IowaScaledEngineering/ckt-pingpong/doc/usermanual/img/power.jpg

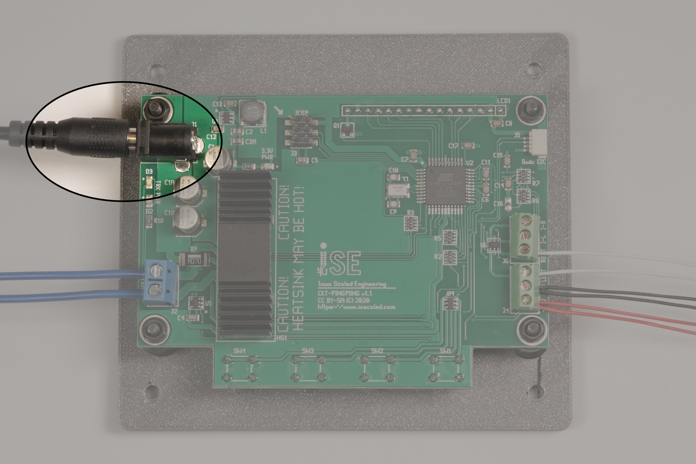
doc/usermanual/img/power.jpg
