IowaScaledEngineering/ckt-pingpong/mech/faceplates/pingpong-sw-template.pdf

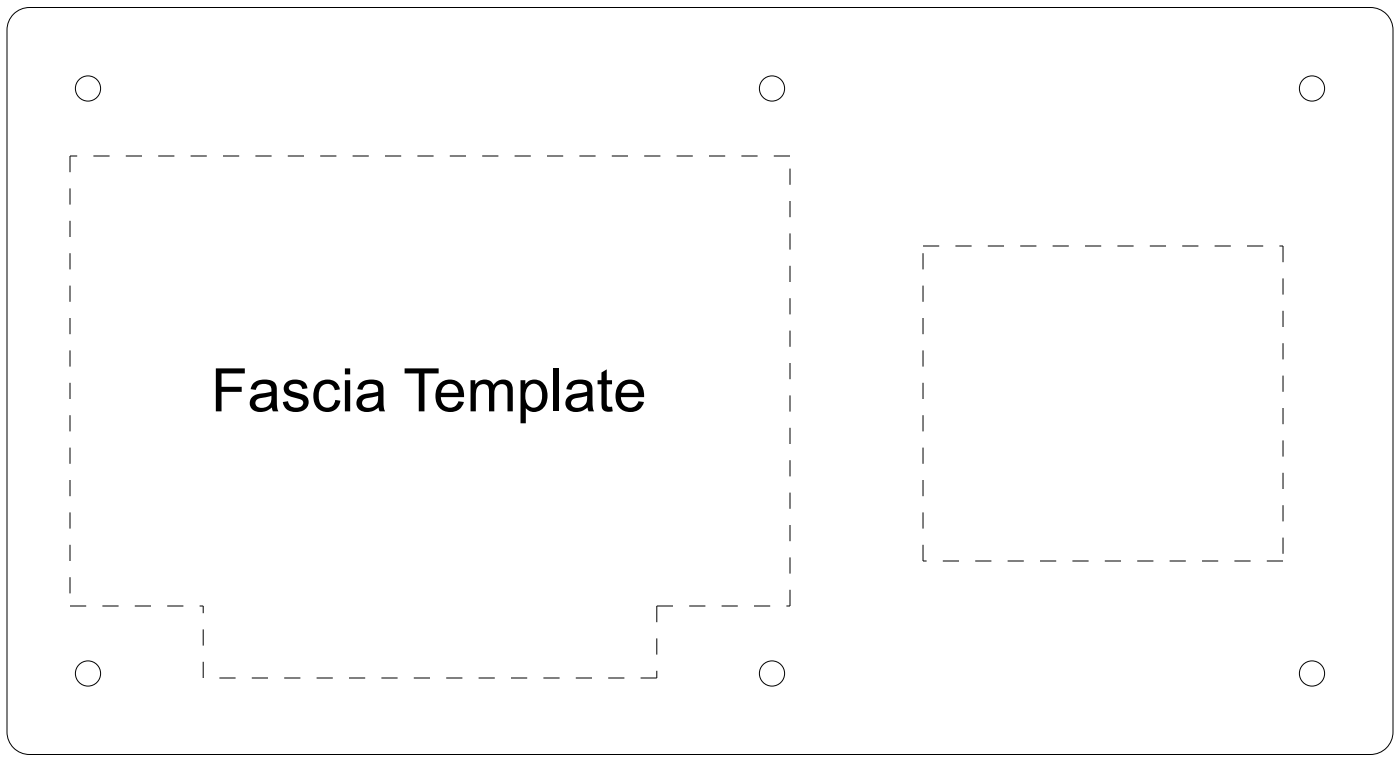
[picture p2: figure]
Fascia Template
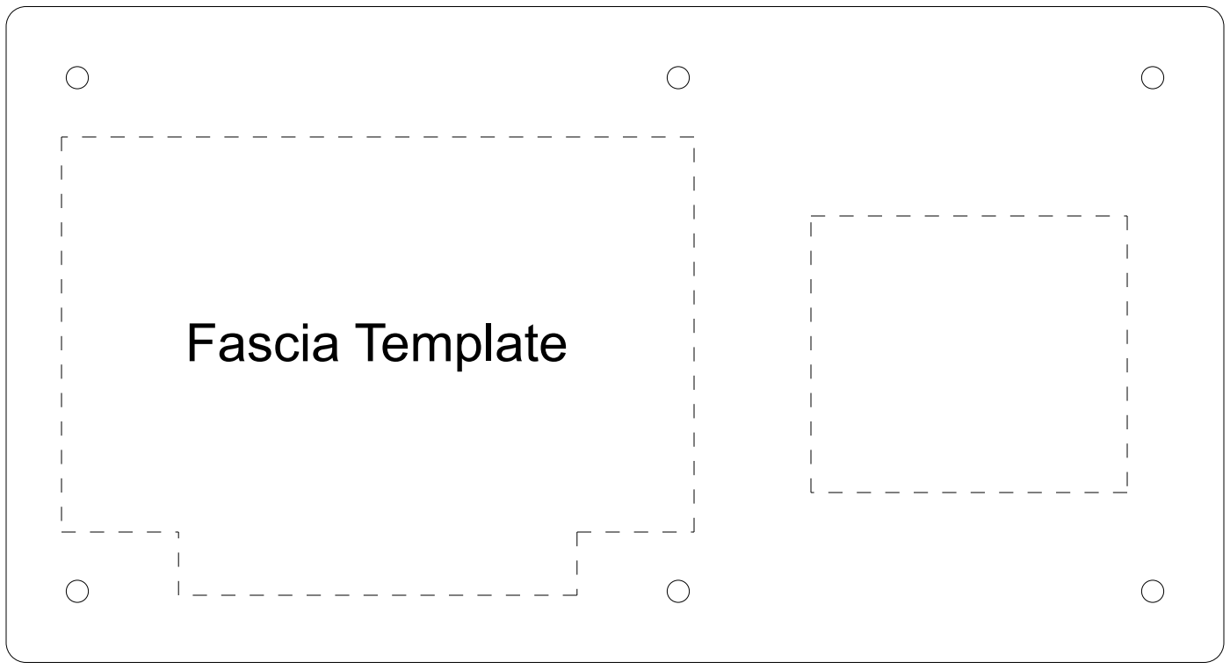
[picture p3: figure]
Fascia Template
