IowaScaledEngineering/ckt-pingpong/pg/ckt-pingpong-sw-v1.0-e837b19/ckt-pingpong-sw-pcb.pdf

# ckt-pingpong-sw.pcb

# 1. Table of Contents (This Page) Created on Wed Aug 19 21:07:21 2020

# 2. top 3. bottom 4. outline 5. plated-drill 6. componentmask 7. soldermask 8. topsilk 9. bottomsilk 10. topassembly 11. bottomassembly 12. fab

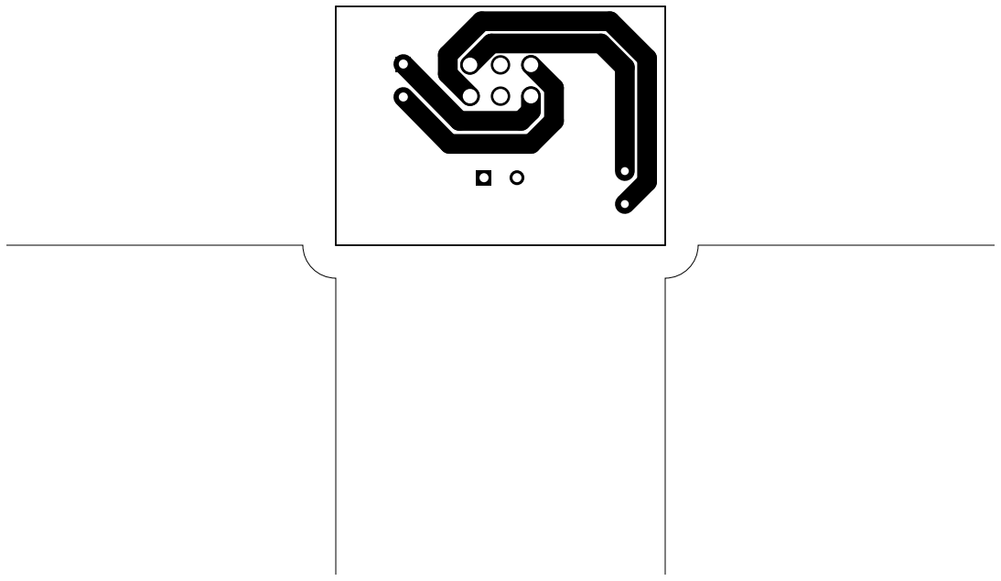
[picture p4: figure]

top, scale = 1:1.000

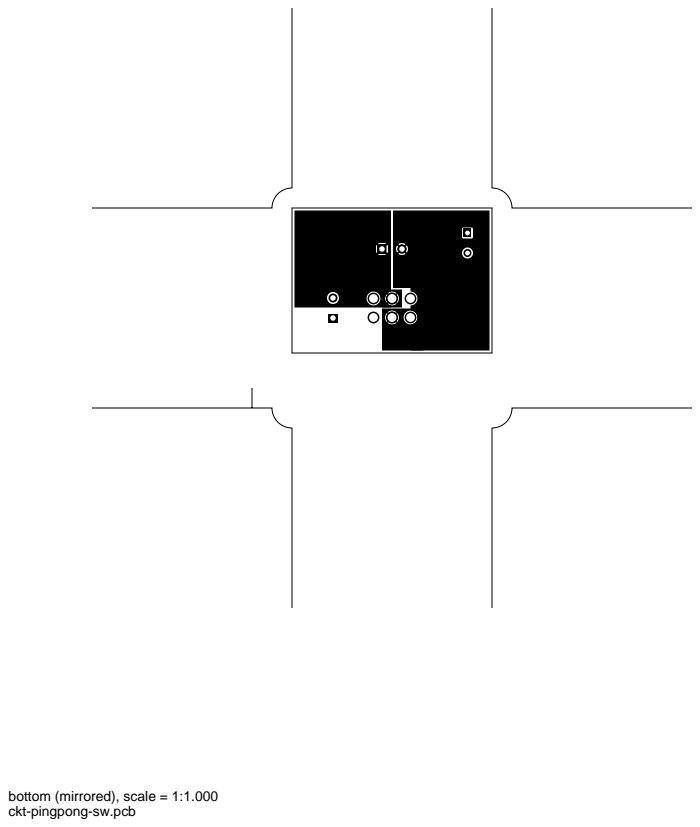
[picture p5: page 3]

bottom (mirrored), scale = 1:1.000

outline, scale = 1:1.000 plated-drill, scale = 1:1.000

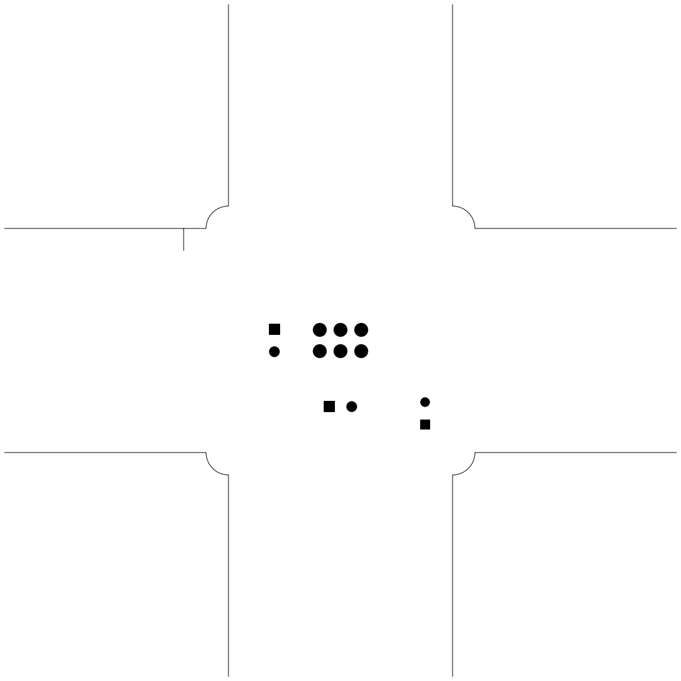
[picture p6: figure]

topmask, scale = 1:1.000

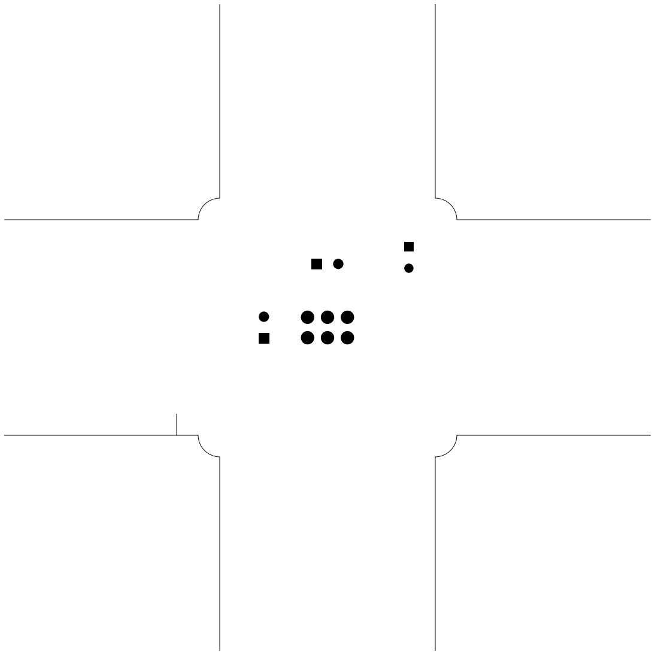
[picture p7: figure]

bottommask (mirrored), scale = 1:1.000

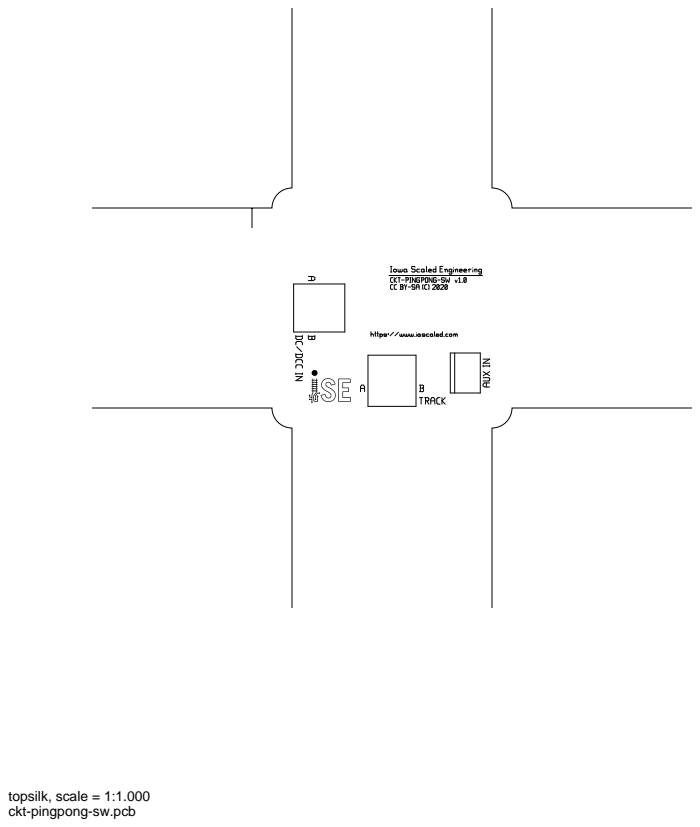
[picture p8: page 8]
topsilk, scale = 1:1.000

bottomsilk (mirrored), scale = 1:1.000

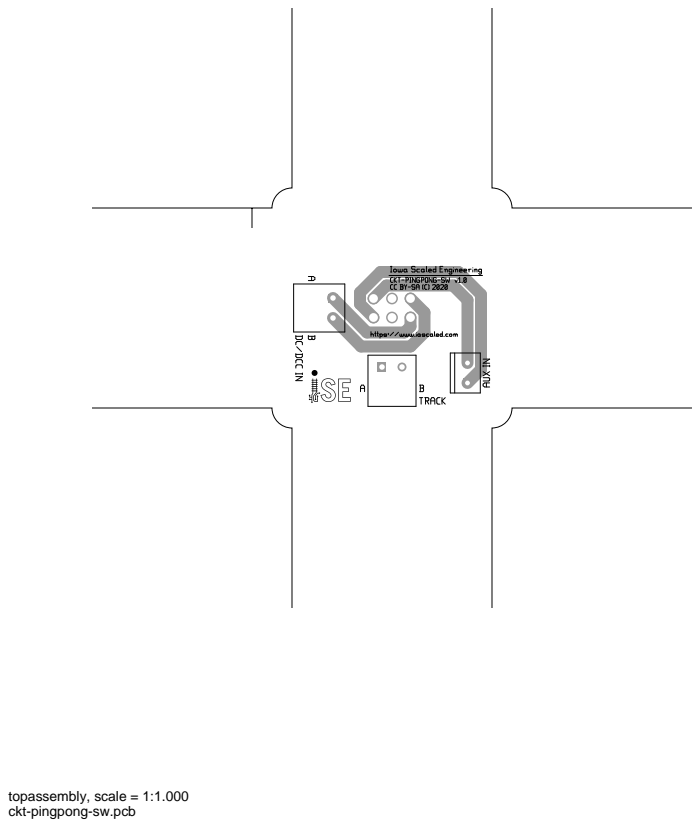
[picture p9: page 10]
topassembly, scale = 1:1.000

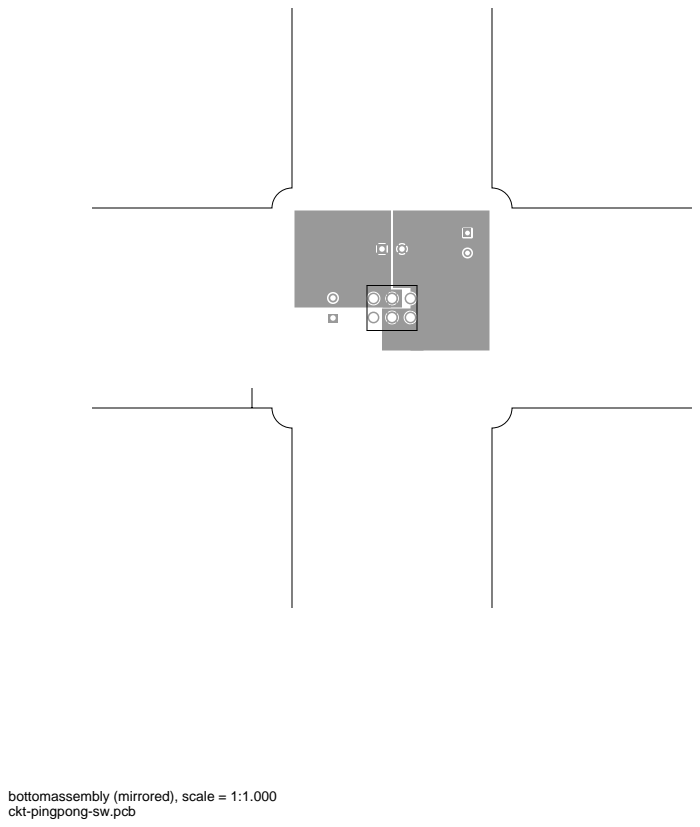
[picture p10: page 11]

bottomassembly (mirrored), scale = 1:1.000

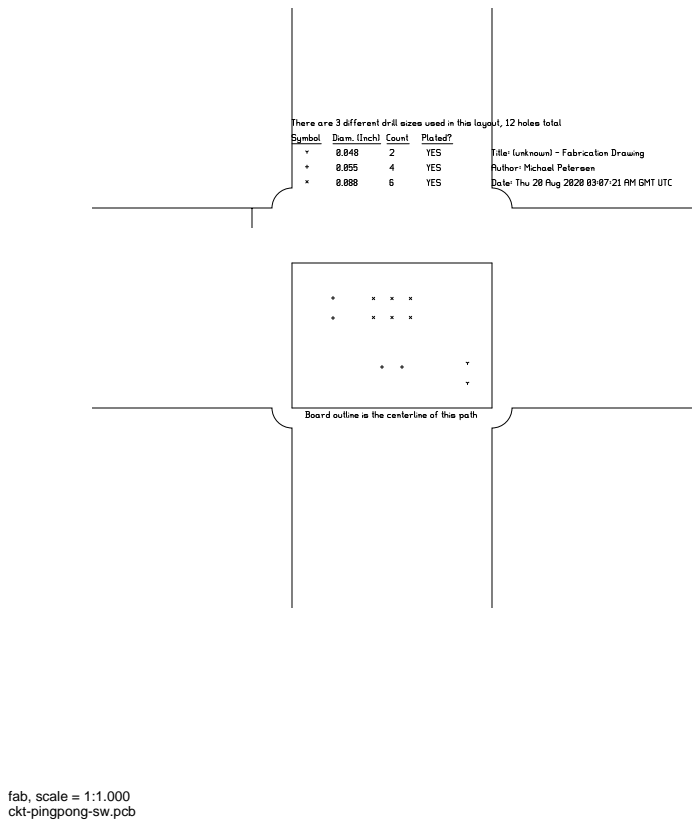
[picture p11: page 12]
fab, scale = 1:1.000
