IowaScaledEngineering/ckt-pingpong/mech/faceplates/pingpong-faceplate-plate v18.stl

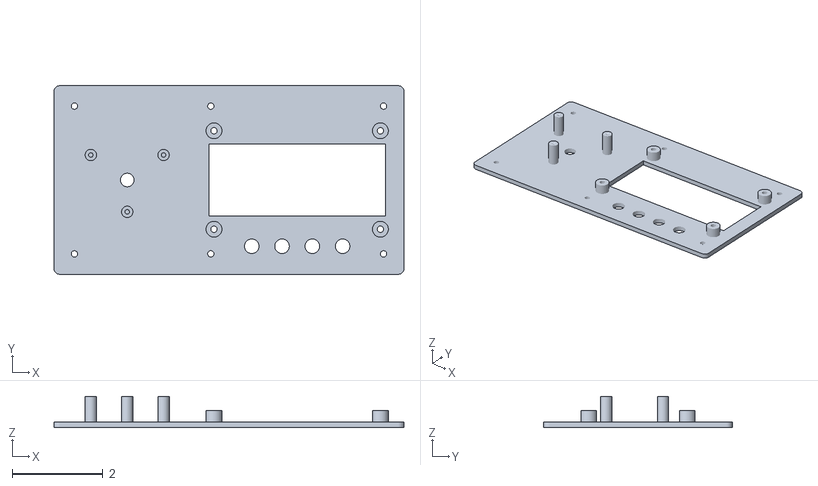
[picture p12: CAD file, 2021-12-24]
mech/faceplates/pingpong-faceplate-plate v18.stl
7.70 x 4.15 x 0.683
