IowaScaledEngineering/ckt-pingpong/mech/faceplates/pingpong-faceplate v18.3mf

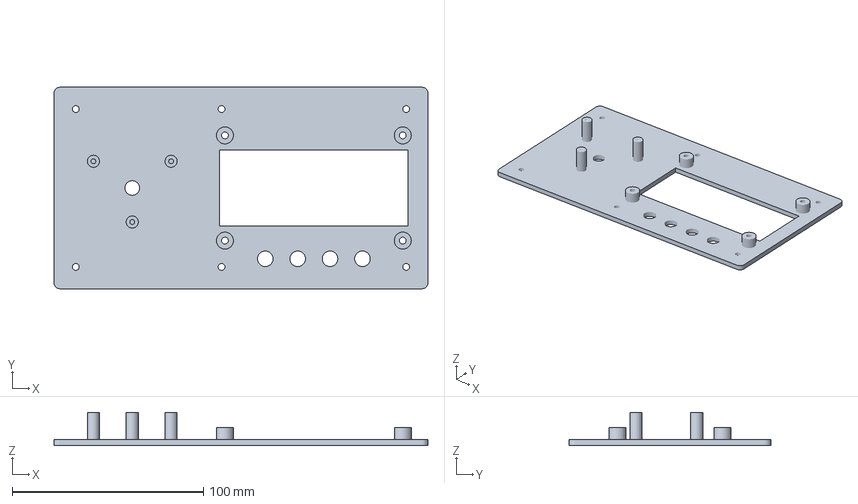
[picture p13: CAD file, 2021-12-24]
mech/faceplates/pingpong-faceplate v18.3mf
195.6 x 105.4 x 17.3 mm
