IowaScaledEngineering/ckt-pingpong/mech/faceplates/knob v7.3mf

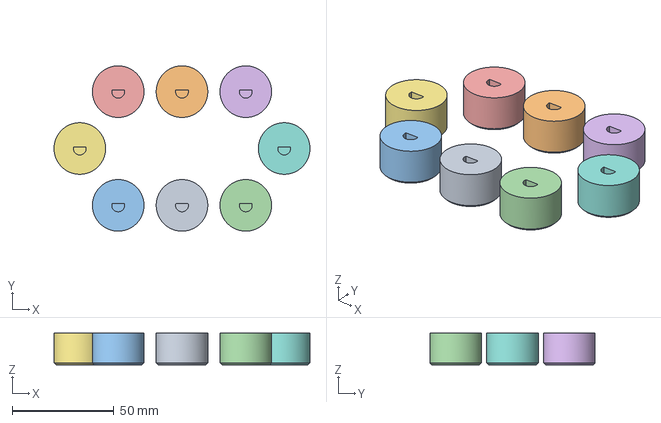
[picture p14: CAD file, 2021-12-24]
mech/faceplates/knob v7.3mf
126.0 x 81.4 x 15.7 mm
