IowaScaledEngineering/ckt-pingpong/mech/faceplates/pingpong-faceplate-abc v18.stl

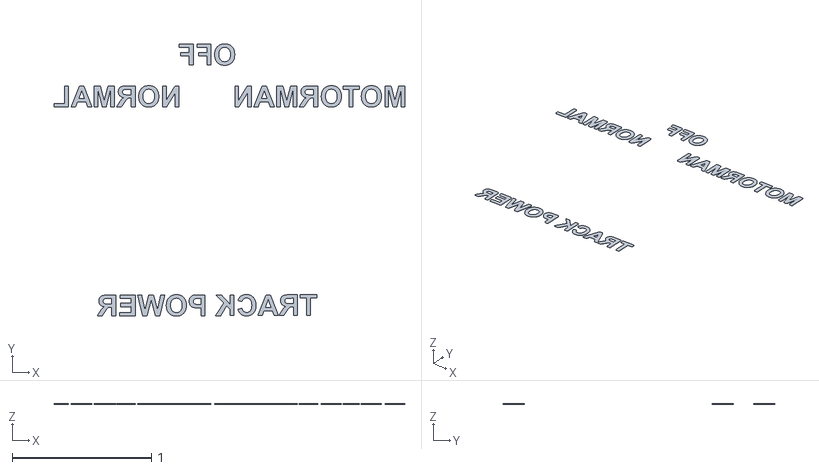
[picture p15: CAD file, 2021-12-24]
mech/faceplates/pingpong-faceplate-abc v18.stl
2.52 x 1.96 x 0.00787
