IowaScaledEngineering/ckt-pingpong/mech/faceplates/knob-pointer v7.stl

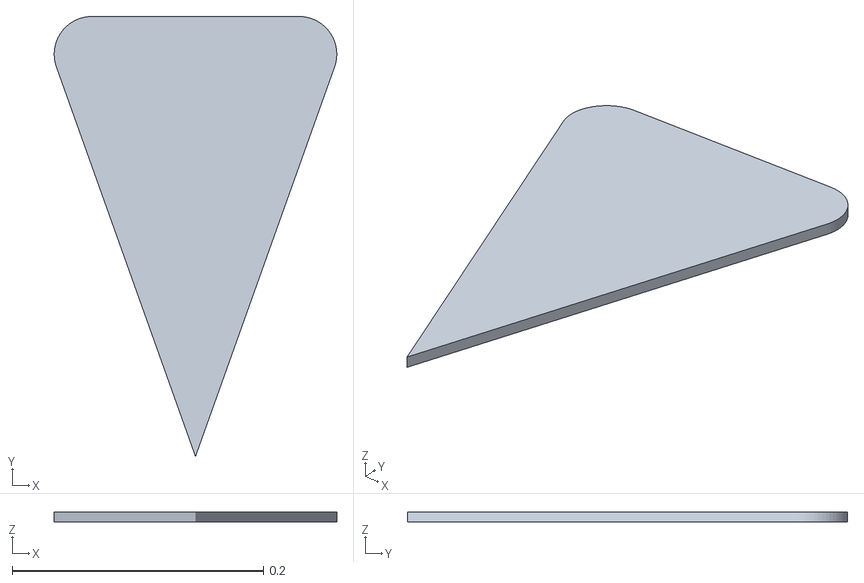
[picture p16: CAD file, 2021-02-20]
mech/faceplates/knob-pointer v7.stl
0.225 x 0.35 x 0.00787
