IowaScaledEngineering/ckt-pingpong/(list of files, cad)

Other CAD files:
mech/faceplates/knob v7.stl
