IowaScaledEngineering/ckt-pingpong/doc/motorman-testing.odt

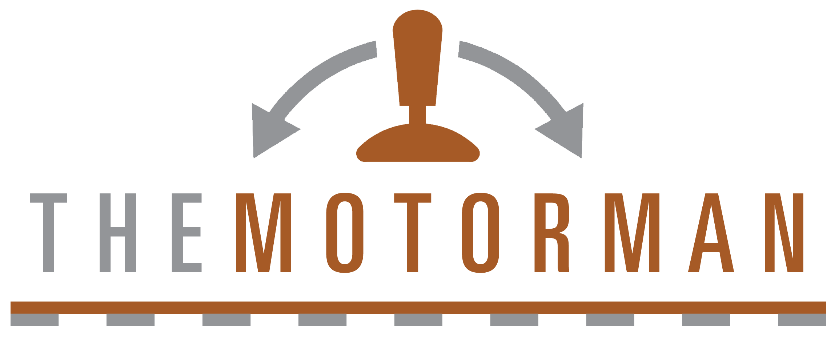
[picture p21: figure]
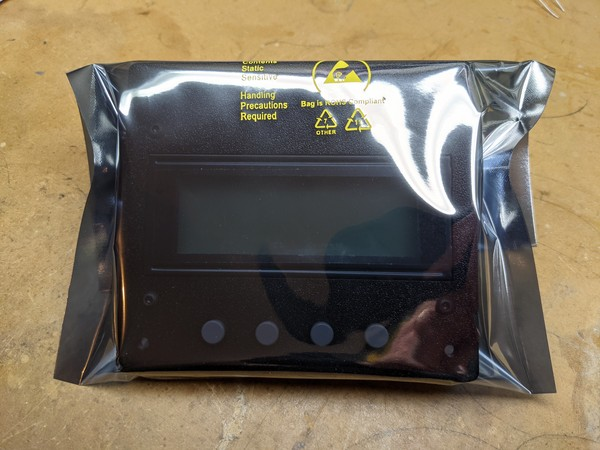
[picture p22: figure]

1. Power from 12V Verify power LED is lit Loosen GND and track screws while powering up Figure 1
2. Factory Reset
3. Attach 12Ω resistor to TRACK terminals Monitor voltage and current Verify both track LEDs are lit
4. Enter Diagnostics menu Short each sensor input to GND, verifying response on display

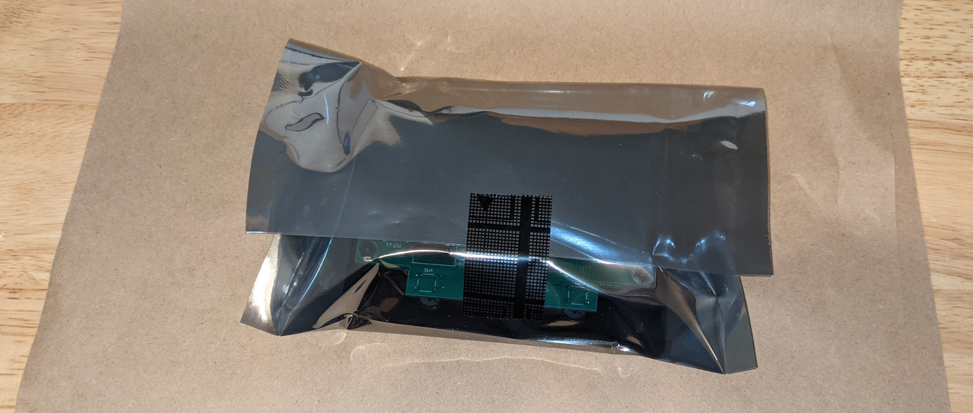
[picture p23: figure]

5. Place in 6x8 anti-tatic bag (Figure 1) Tape closed on back Figure 2
6. Place face down on folded packing paper (Figure 2)
7. Wrap and fold paper loosely over front (Figure 3)
8. Put layer of crinkle paper in box

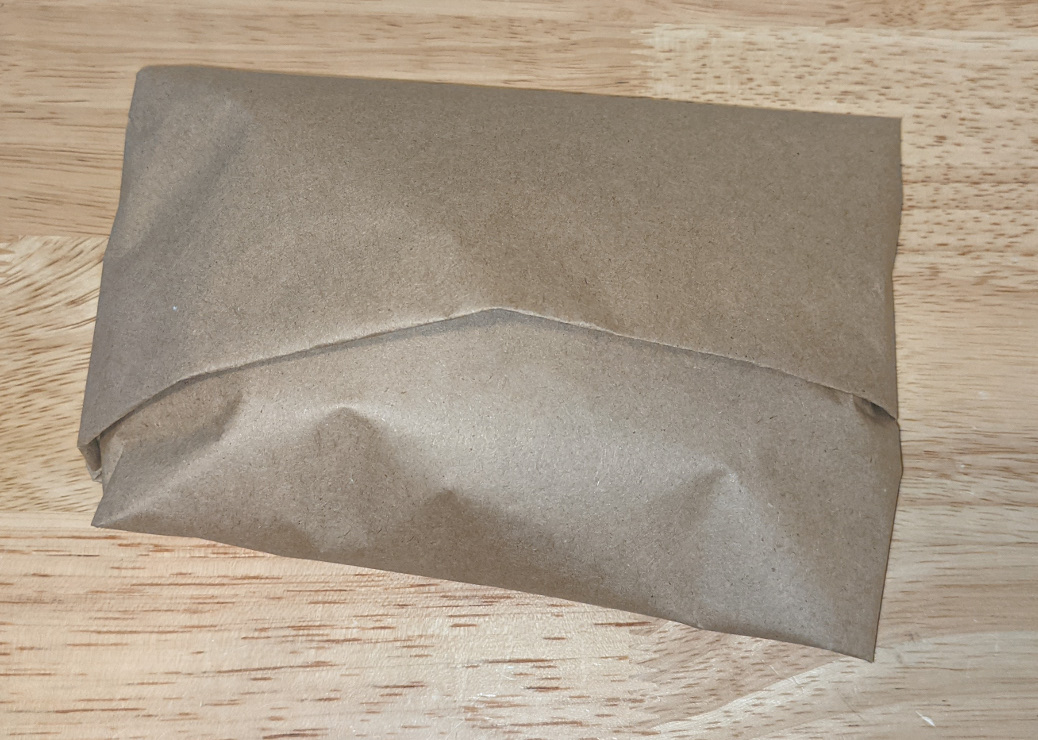
[picture p24: figure]

9. Place control unit in back of box, face down, with power supply toward front (Figure 4) Figure 3
10. Place selected IR sensor on top (Figure 5)
11. Insert manual and close box
12. Label box in middle of top lid, small piece of tape to hold closed

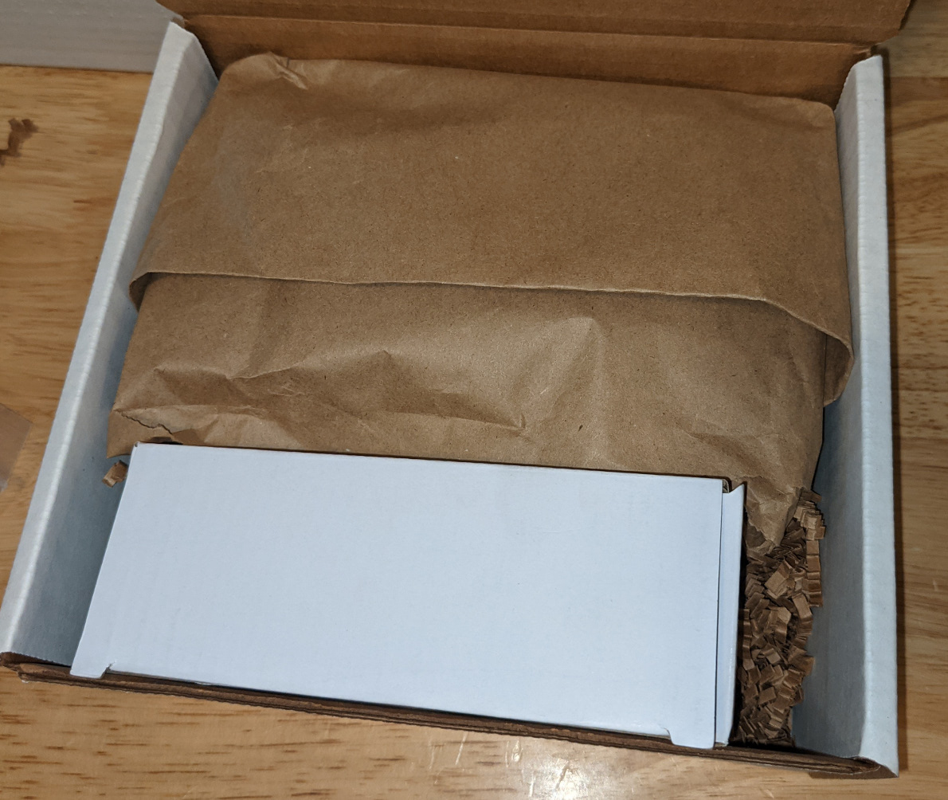
[picture p25: figure]

Figure 4

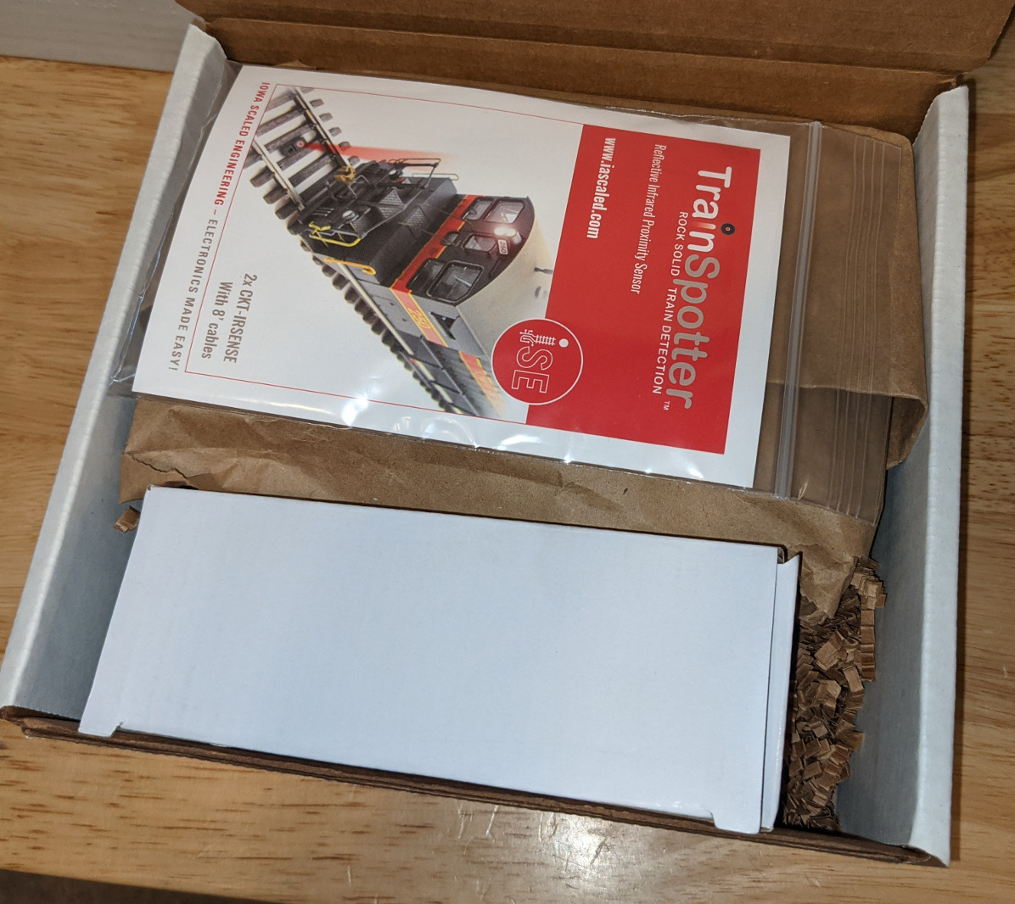
[picture p26: figure]

Figure 5
