IowaScaledEngineering/ckt-pingpong/pg/ckt-pingpong-v1.3-6b31691/ckt-pingpong-pcb.pdf

# ckt-pingpong.pcb

# 1. Table of Contents (This Page) Created on Thu Feb 2 21:42:43 2023

# 2. component 3. solder 4. outline 5. plated-drill 6. componentmask 7. soldermask 8. topsilk 9. bottomsilk 10. toppaste 11. topassembly 12. bottomassembly 13. fab

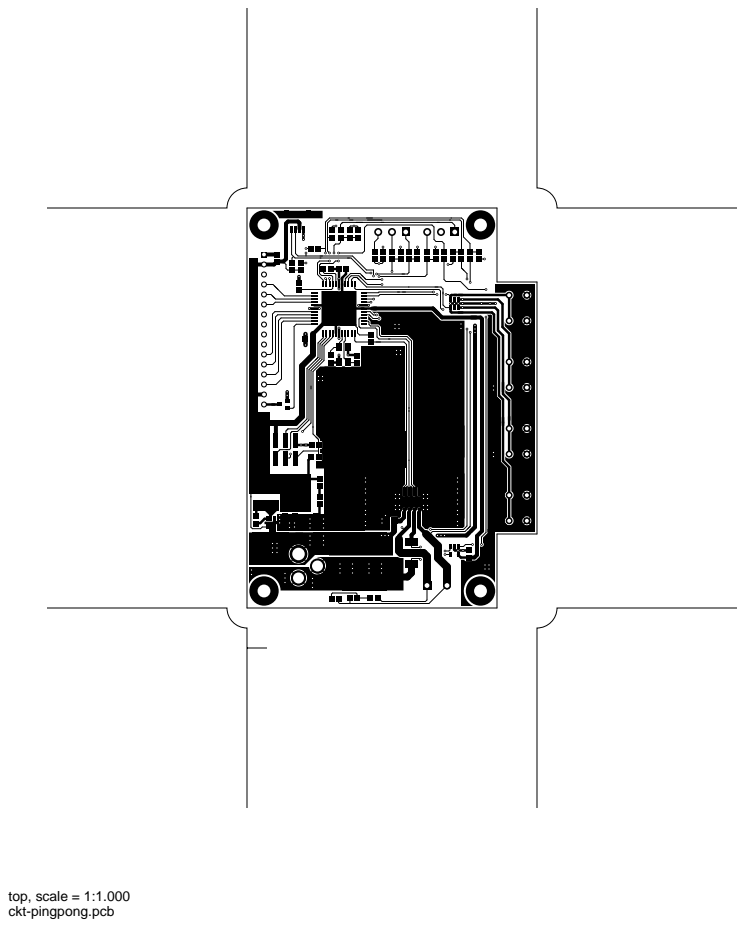
[picture p27: page 2]
top, scale = 1:1.000

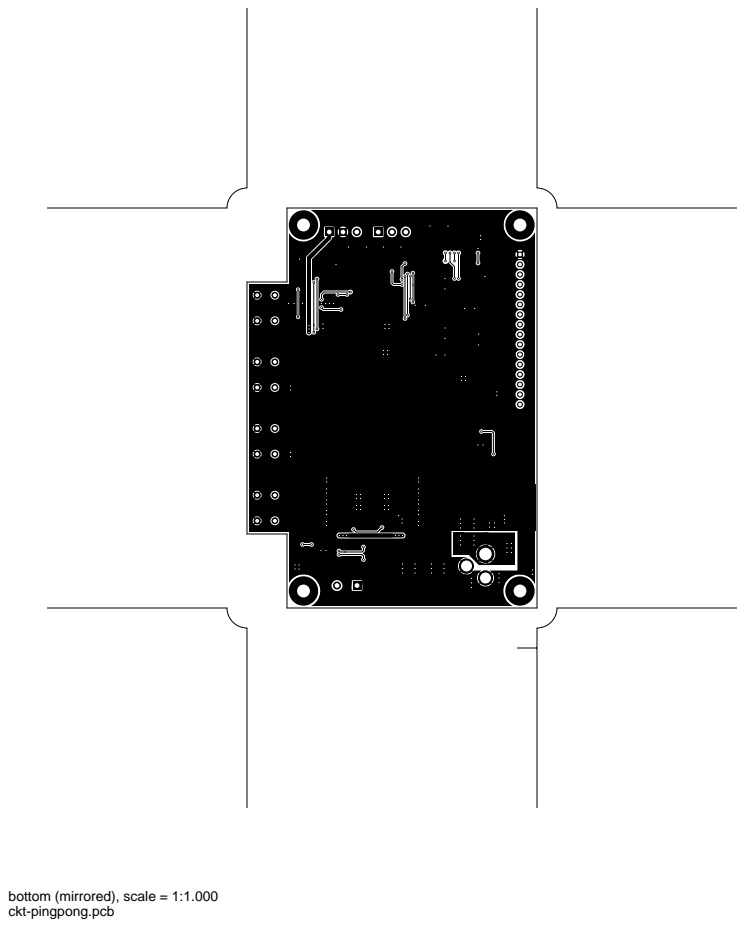
[picture p28: page 3]

bottom (mirrored), scale = 1:1.000

outline, scale = 1:1.000

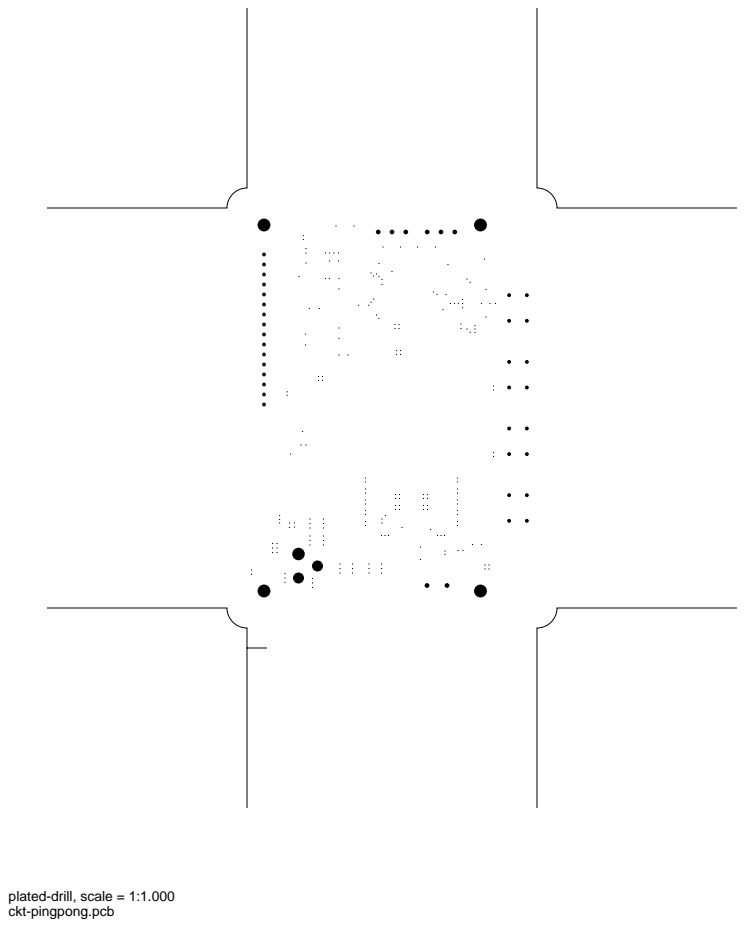
[picture p29: page 5]

plated-drill, scale = 1:1.000

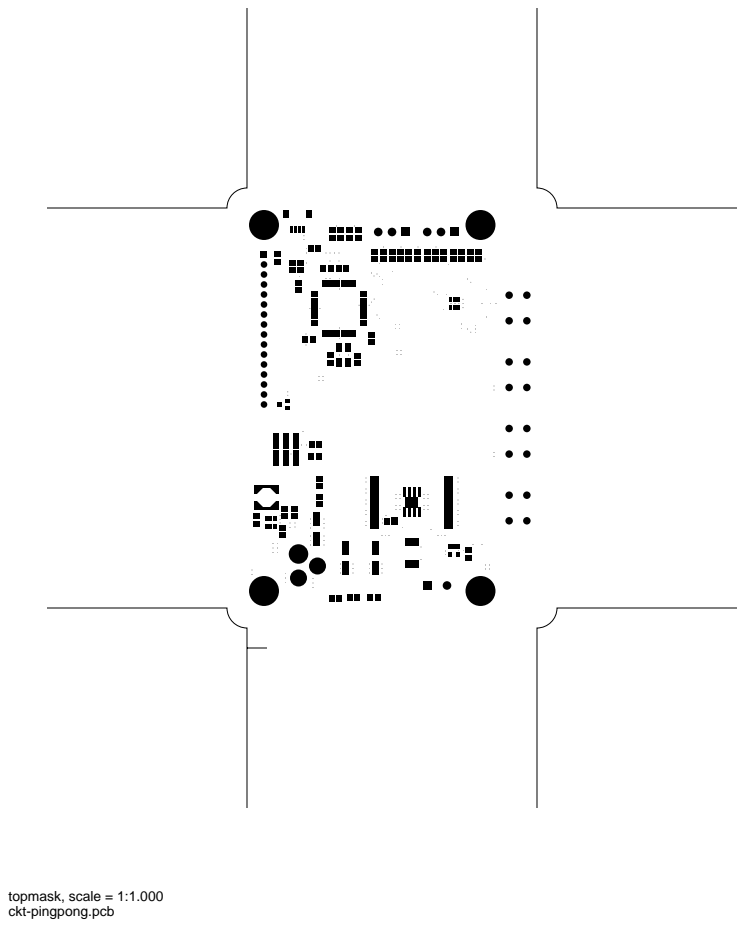
[picture p30: page 6]
topmask, scale = 1:1.000

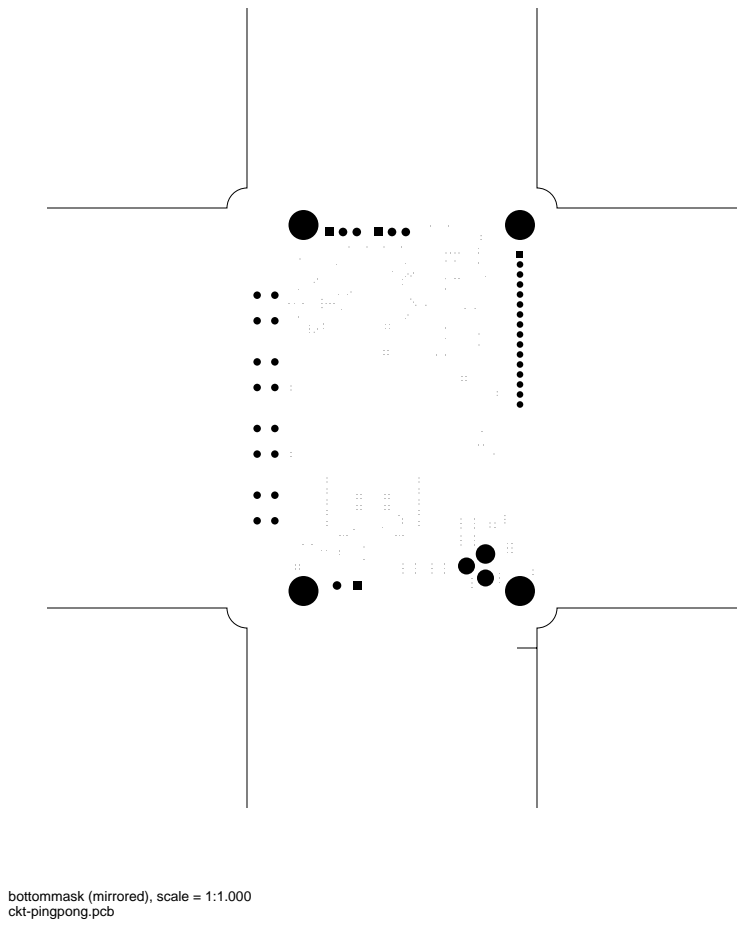
[picture p31: page 7]

bottommask (mirrored), scale = 1:1.000

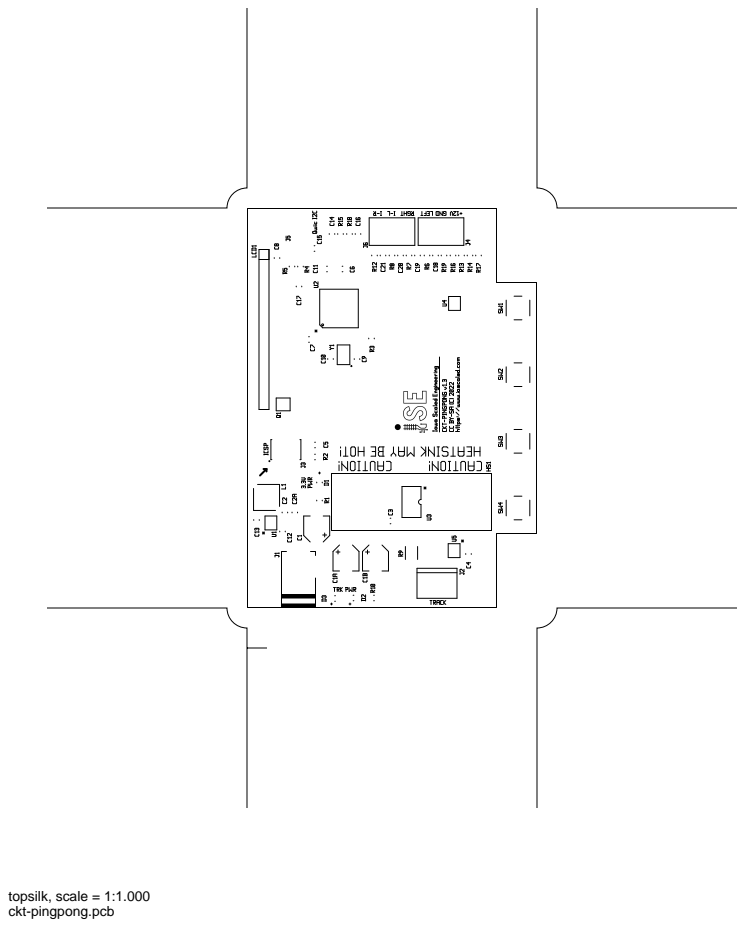
[picture p32: page 8]
topsilk, scale = 1:1.000

bottomsilk (mirrored), scale = 1:1.000

toppaste, scale = 1:1.000

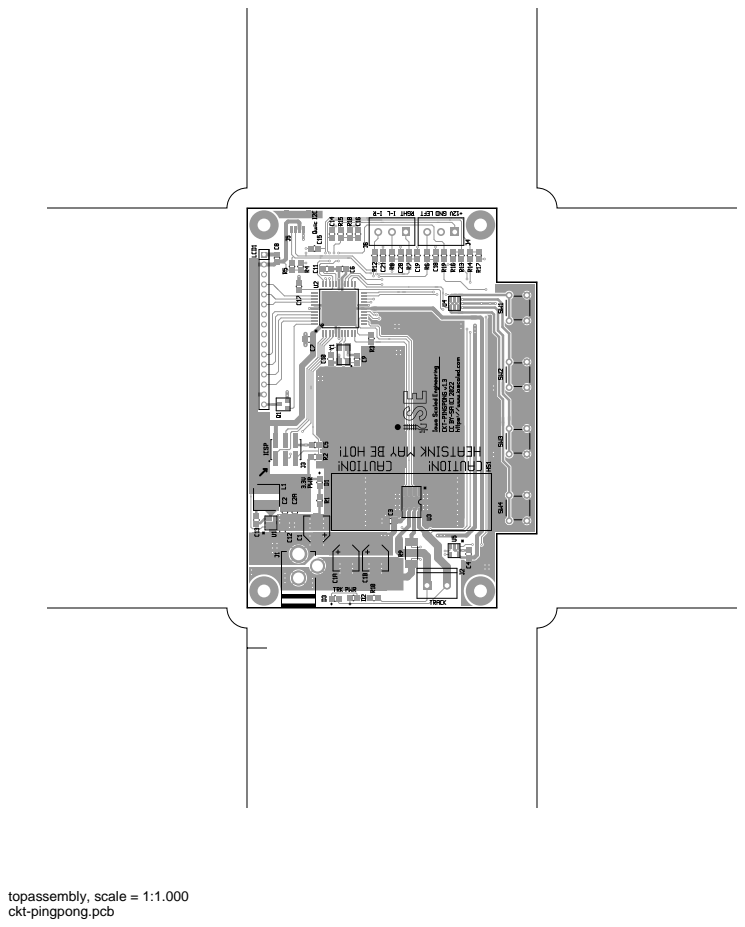
[picture p33: page 11]
topassembly, scale = 1:1.000

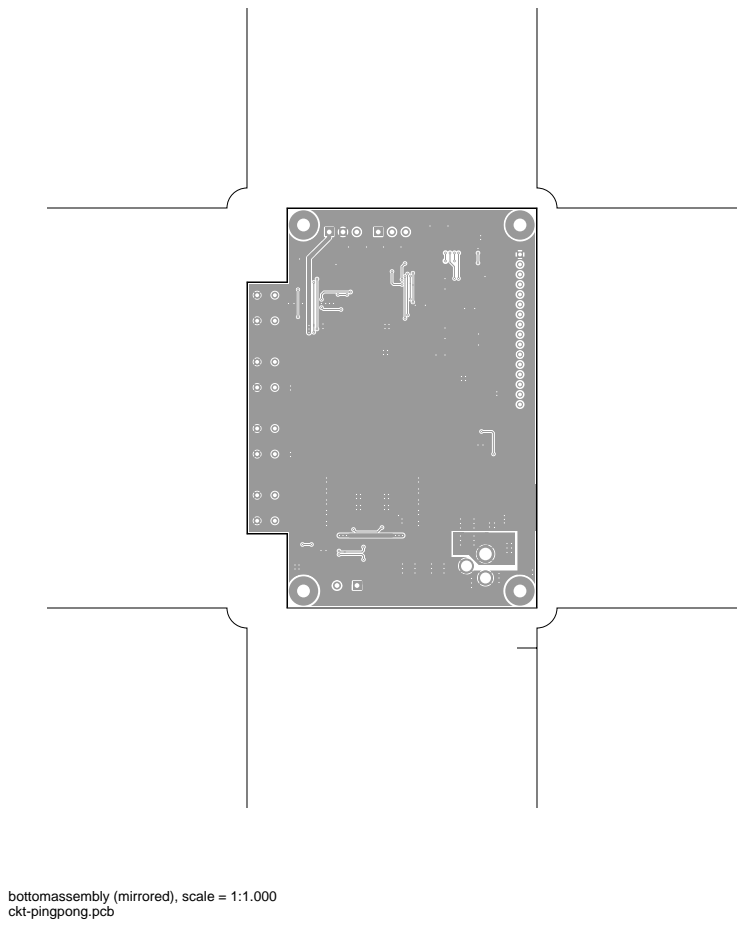
[picture p34: page 12]

bottomassembly (mirrored), scale = 1:1.000

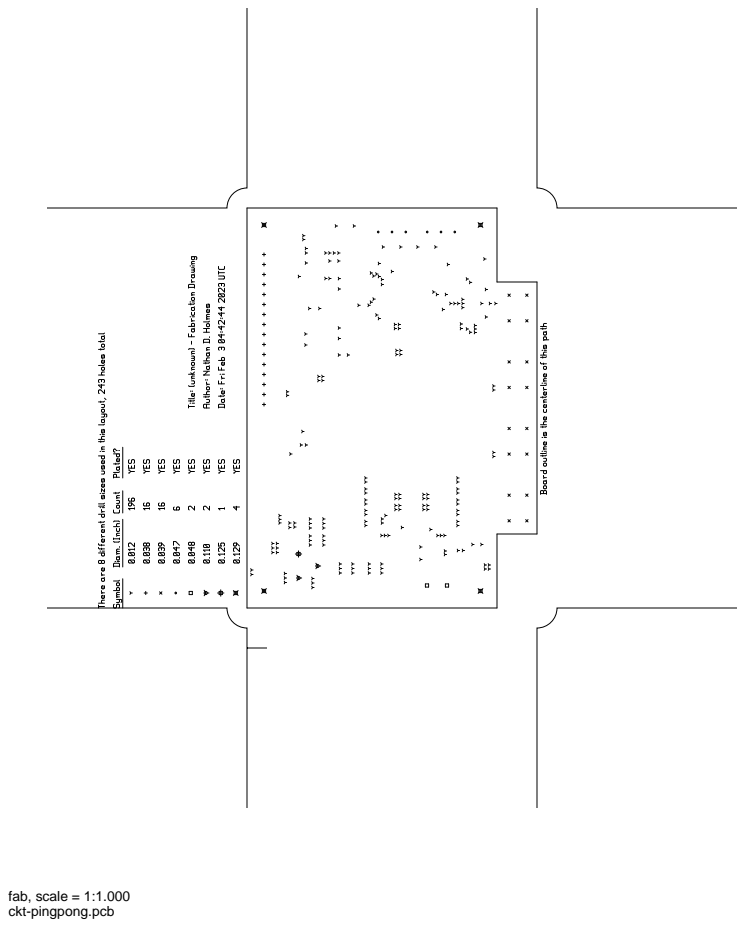
[picture p35: page 13]
fab, scale = 1:1.000
