IowaScaledEngineering/ckt-pingpong/pg/ckt-pingpong-v1.3-6b31691/ckt-pingpong.pdf

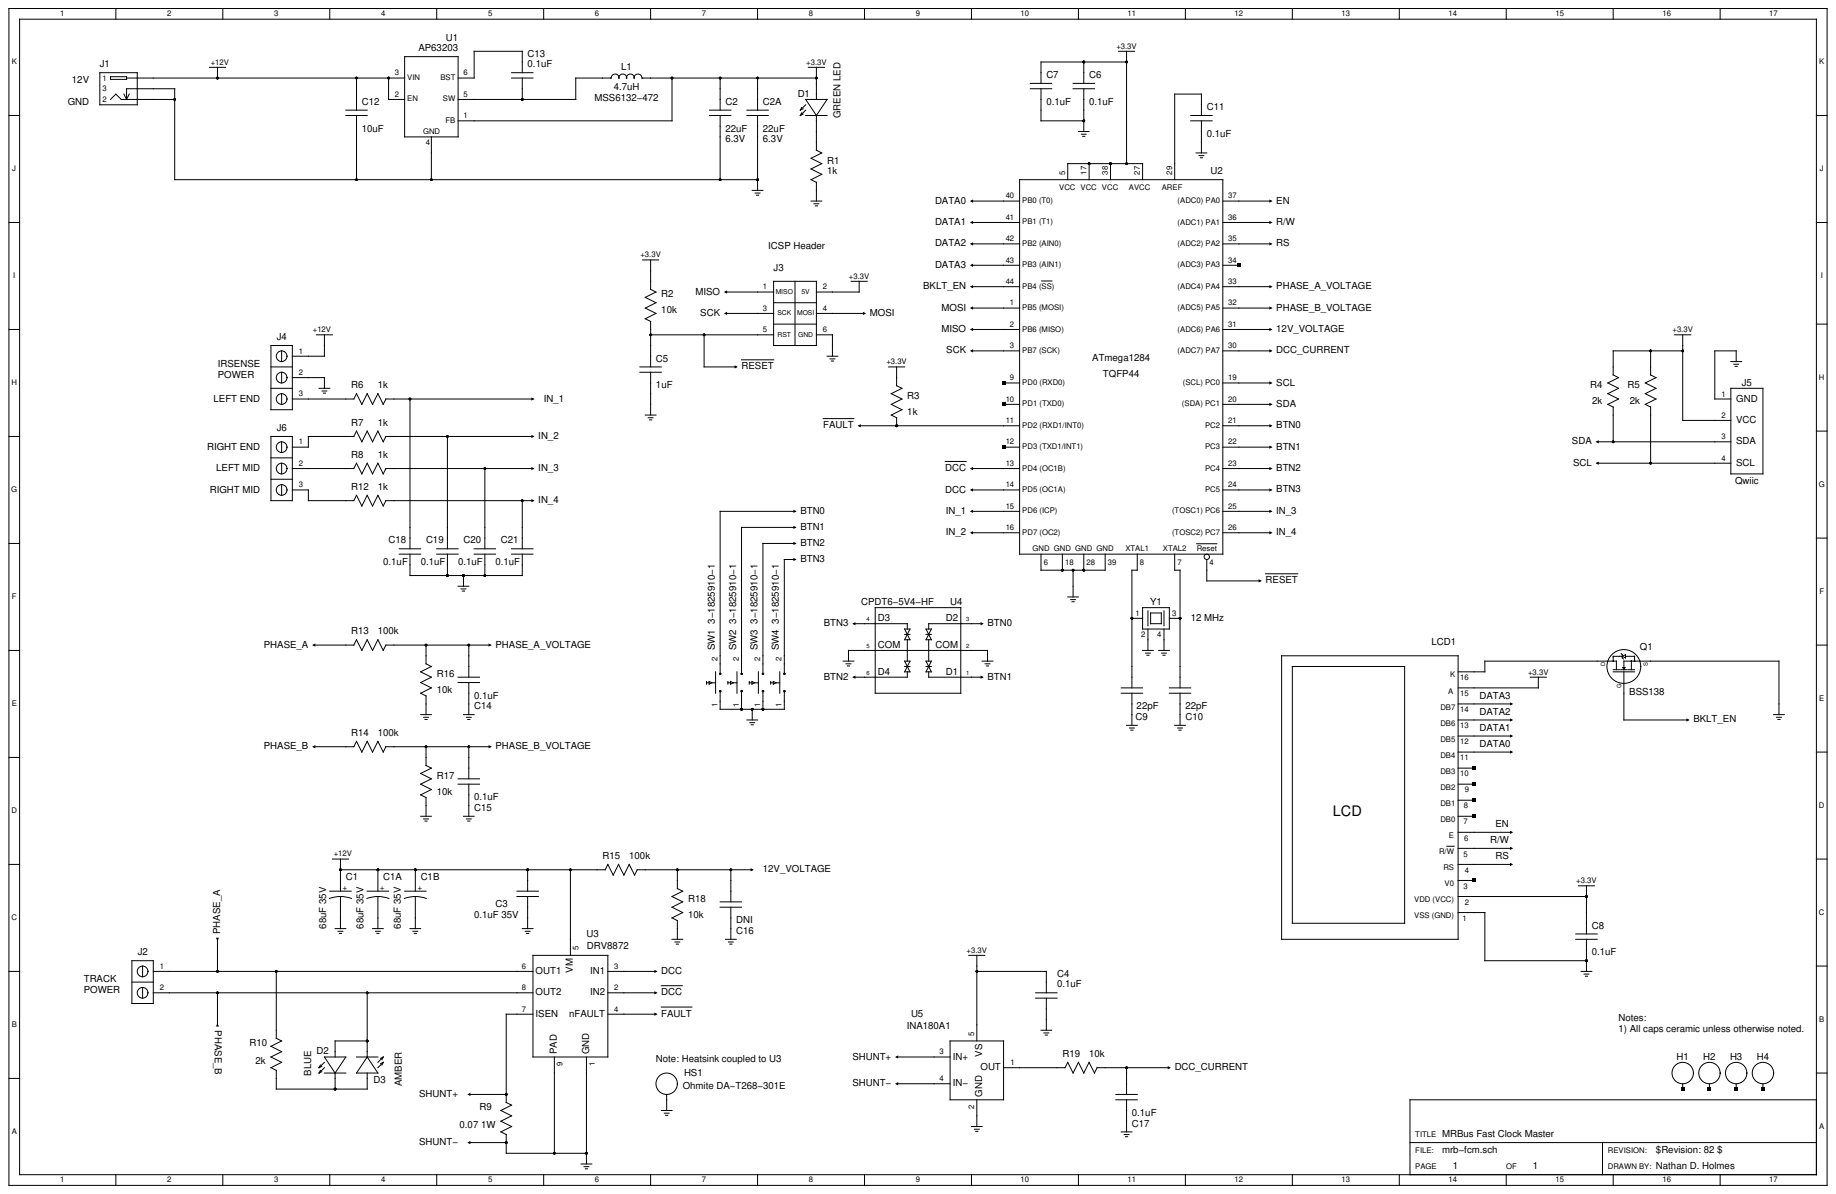
[picture p36: page 1]

Notes:
1) All caps ceramic unless otherwise noted.

Note: Heatsink coupled to U3
Ohmite DA−T268−301E

MRBus Fast Clock Master
mrb−fcm.sch
