IowaScaledEngineering/ckt-pingpong/pg/ckt-pingpong-sw-v2.0-66eee88/ckt-pingpong-sw-pcb.pdf

# ckt-pingpong-sw.pcb

# 1. Table of Contents (This Page) Created on Mon Jan 25 11:16:20 2021

# 2. top 3. bottom 4. outline 5. plated-drill 6. componentmask 7. soldermask 8. topsilk 9. bottomsilk 10. topassembly 11. bottomassembly 12. fab

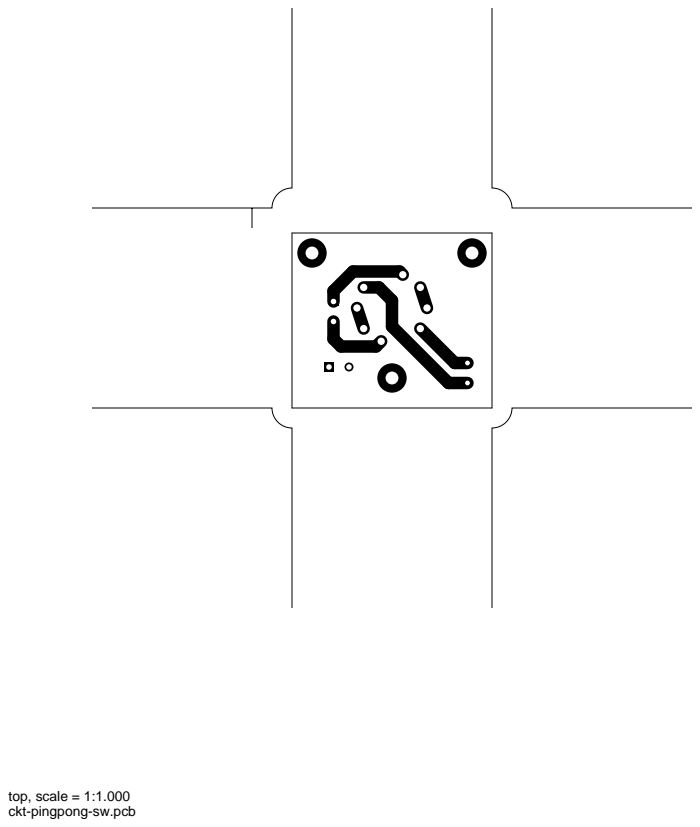
[picture p37: page 2]
top, scale = 1:1.000

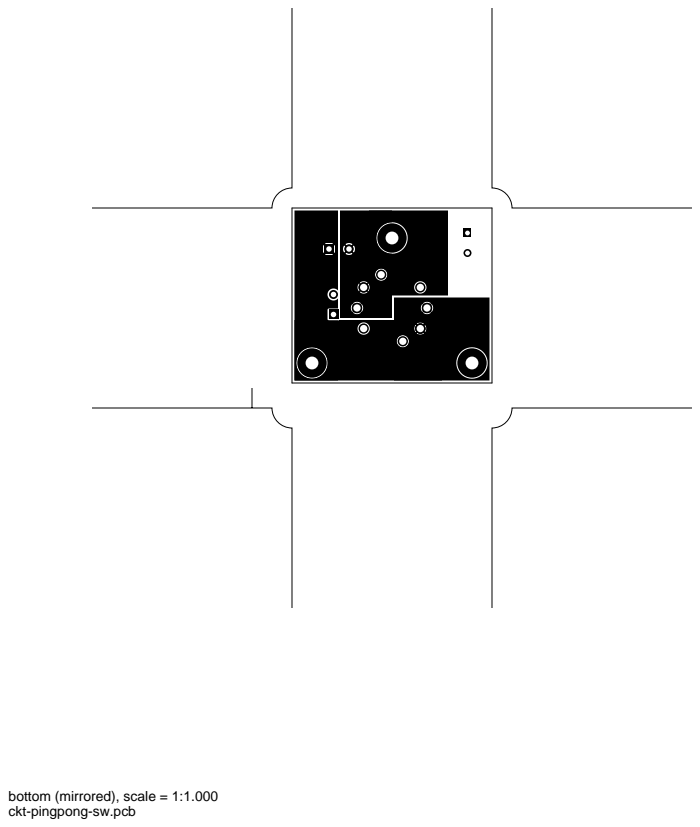
[picture p38: page 3]

bottom (mirrored), scale = 1:1.000

outline, scale = 1:1.000 plated-drill, scale = 1:1.000

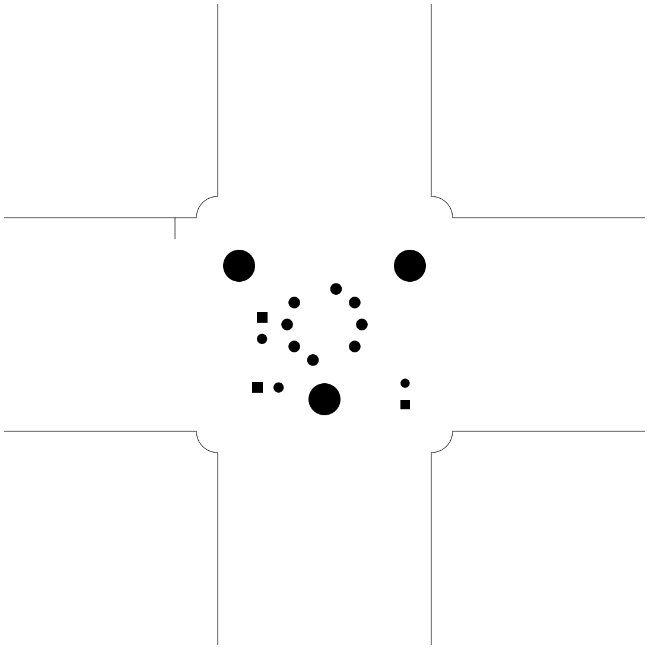
[picture p39: figure]

topmask, scale = 1:1.000

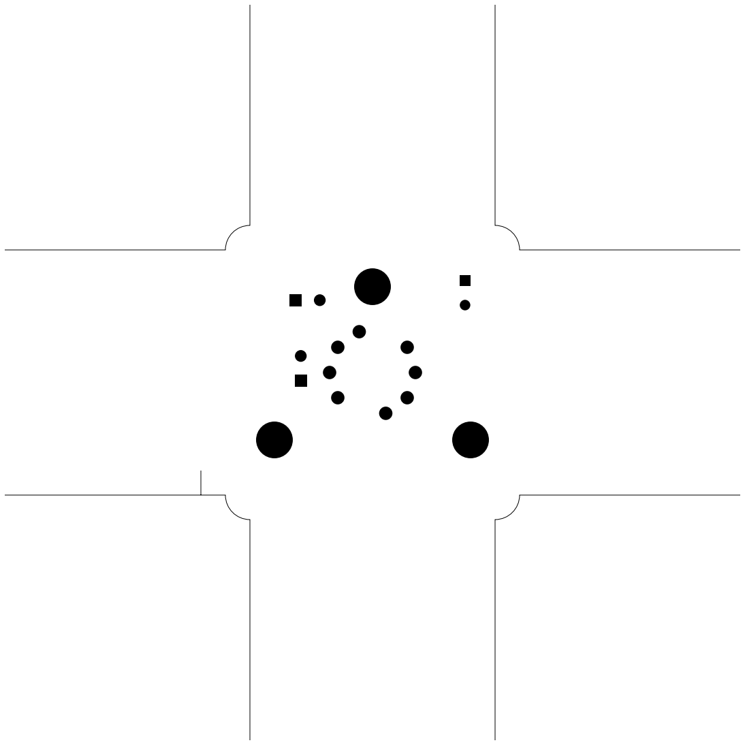
[picture p40: figure]

bottommask (mirrored), scale = 1:1.000

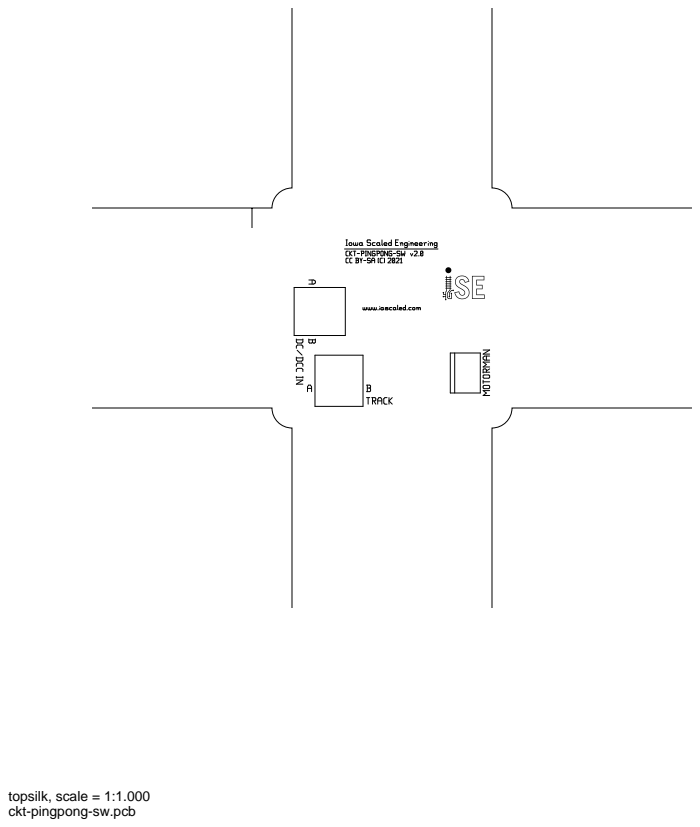
[picture p41: page 8]
topsilk, scale = 1:1.000

bottomsilk (mirrored), scale = 1:1.000

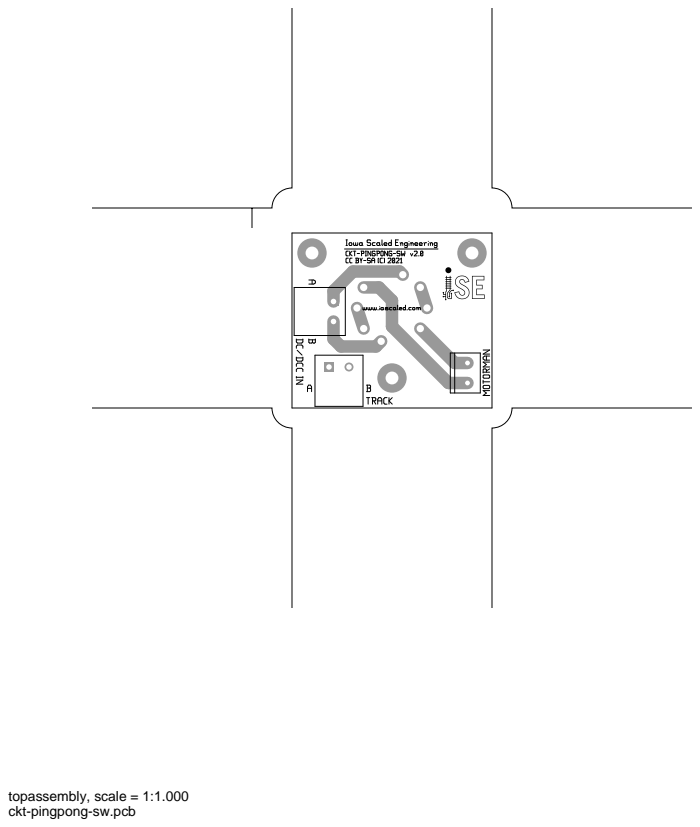
[picture p42: page 10]
topassembly, scale = 1:1.000

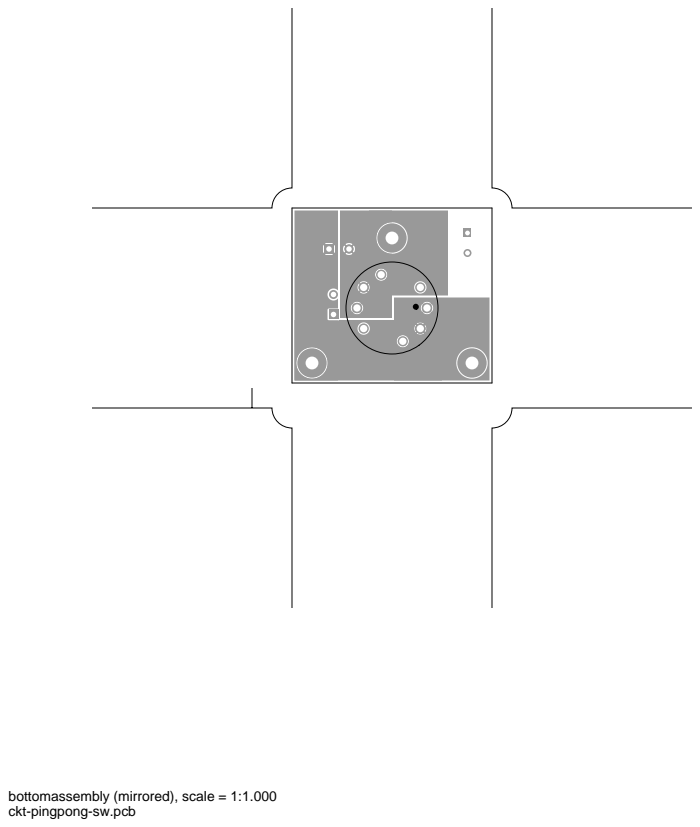
[picture p43: page 11]

bottomassembly (mirrored), scale = 1:1.000

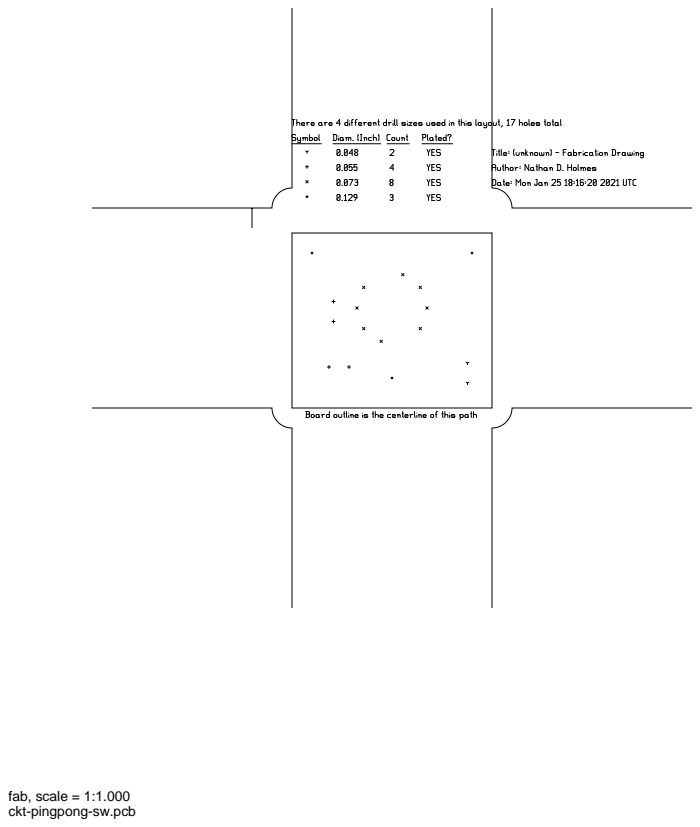
[picture p44: page 12]
fab, scale = 1:1.000
