IowaScaledEngineering/ckt-pingpong/pg/ckt-pingpong-v1.2-3fdbe3e/ckt-pingpong-pcb.pdf

# ckt-pingpong.pcb

# 1. Table of Contents (This Page) Created on Tue Jun 15 20:52:29 2021

# 2. component 3. solder 4. outline 5. plated-drill 6. componentmask 7. soldermask 8. topsilk 9. bottomsilk 10. toppaste 11. topassembly 12. bottomassembly 13. fab

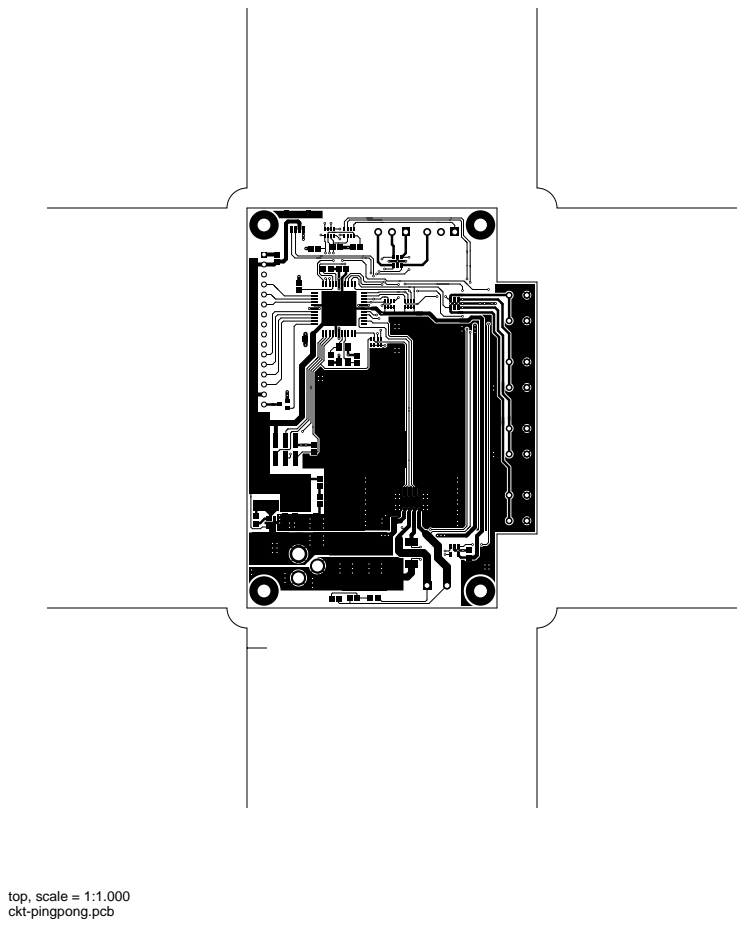
[picture p45: page 2]
top, scale = 1:1.000

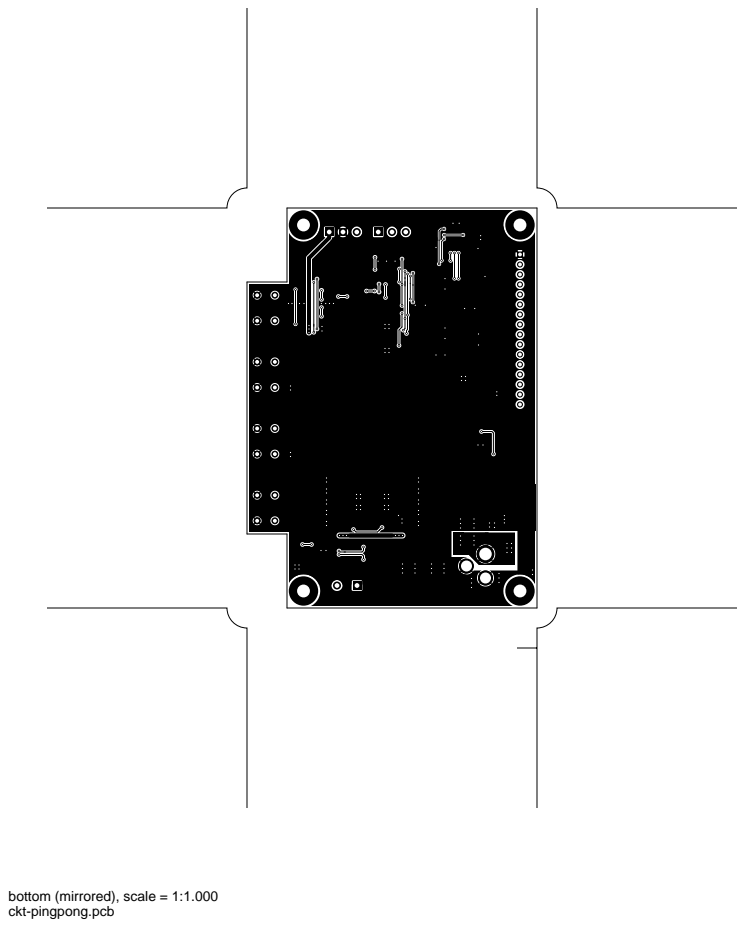
[picture p46: page 3]

bottom (mirrored), scale = 1:1.000

outline, scale = 1:1.000

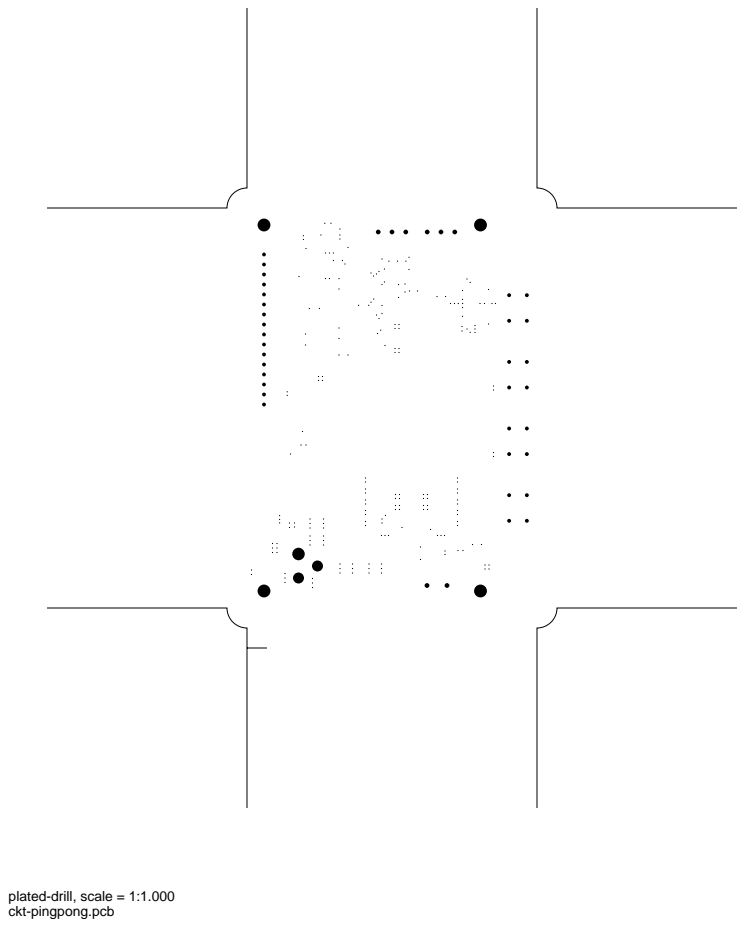
[picture p47: page 5]

plated-drill, scale = 1:1.000

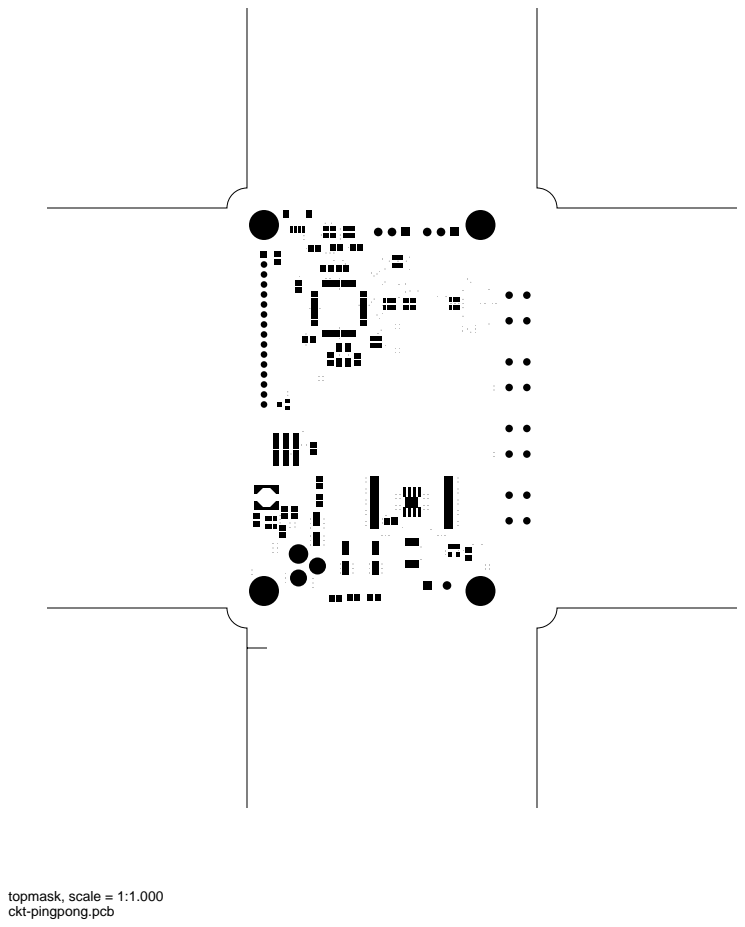
[picture p48: page 6]
topmask, scale = 1:1.000

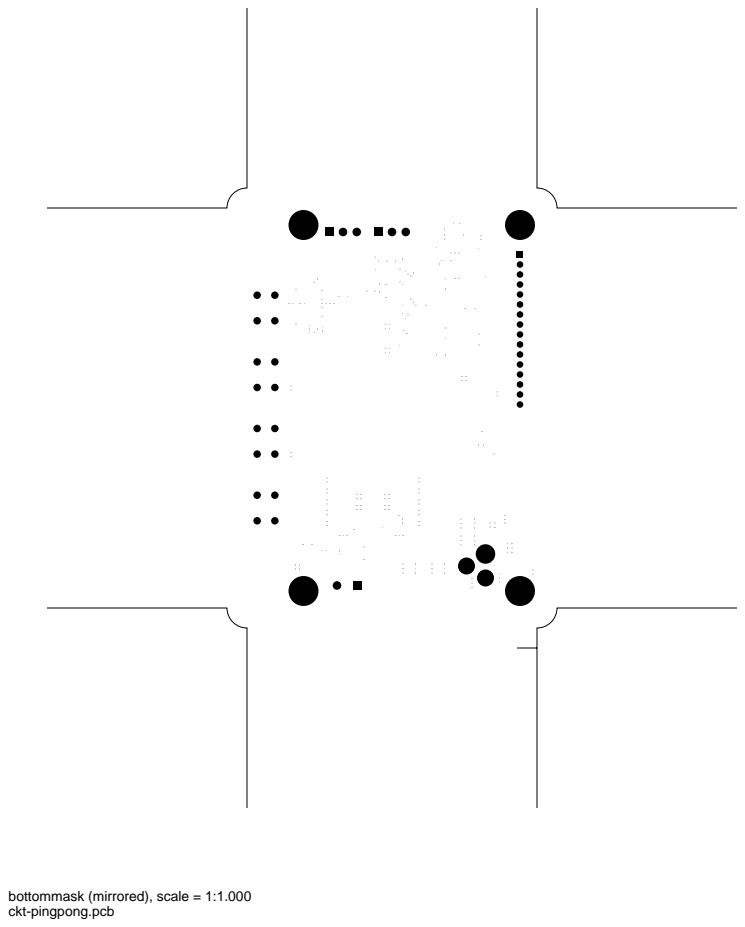
[picture p49: page 7]

bottommask (mirrored), scale = 1:1.000

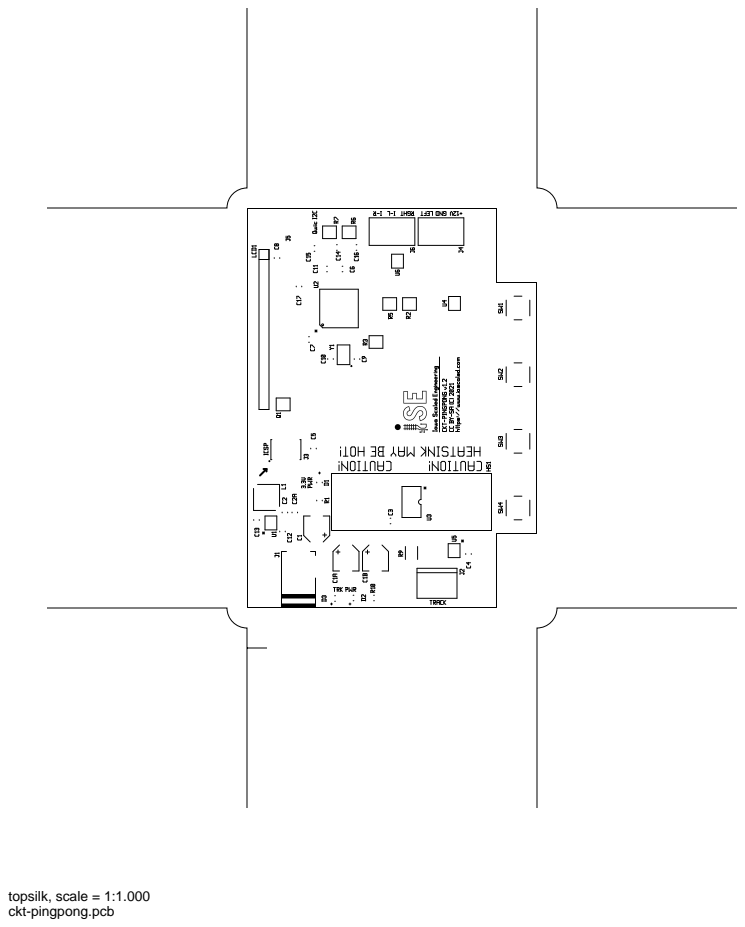
[picture p50: page 8]
topsilk, scale = 1:1.000

bottomsilk (mirrored), scale = 1:1.000

toppaste, scale = 1:1.000

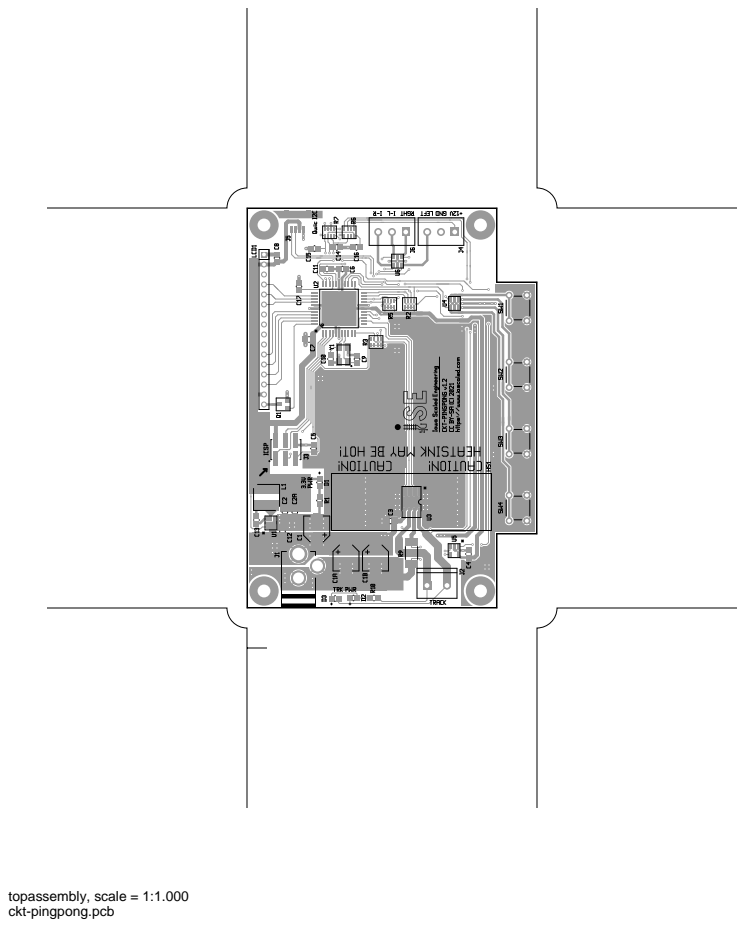
[picture p51: page 11]
topassembly, scale = 1:1.000

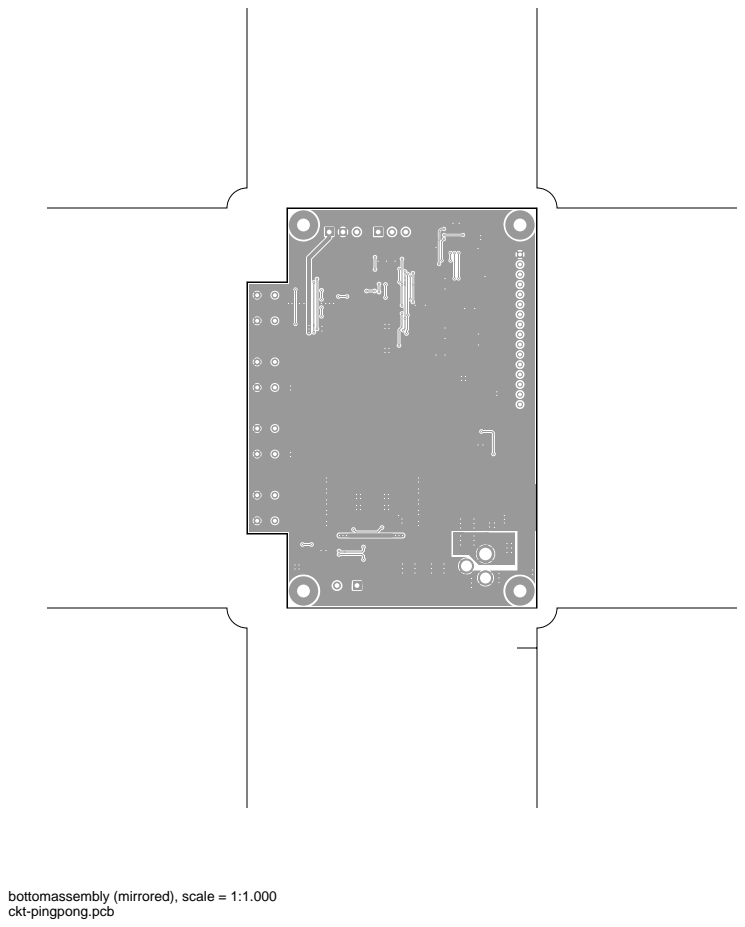
[picture p52: page 12]

bottomassembly (mirrored), scale = 1:1.000

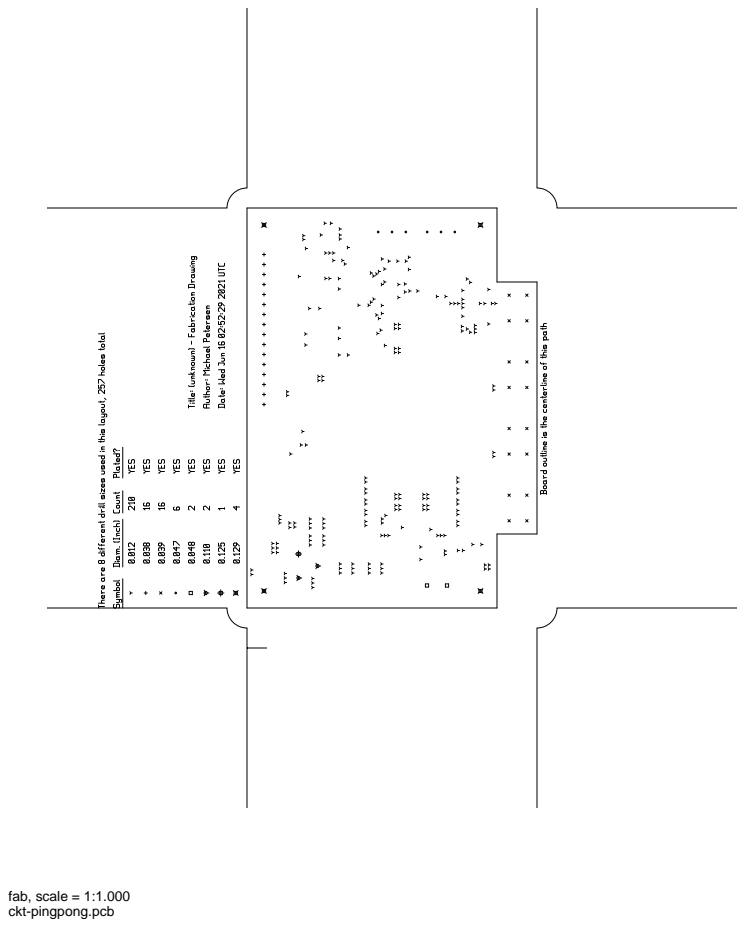
[picture p53: page 13]
fab, scale = 1:1.000
