IowaScaledEngineering/ckt-pingpong/(list of files, drawings)

Other design files:
pcb/ckt-pingpong-sw.pcb
pcb/ckt-pingpong.pcb
