IowaScaledEngineering/ckt-pingpong/src/ckt-pingpong.c

/*************************************************************************
Title:    CKT-PINGPONG v1.2
Authors:  Nathan D. Holmes <maverick@drgw.net>
File:     $Id: $
License:  GNU General Public License v3

LICENSE:
    Copyright (C) 2022 Nathan D. Holmes (maverick@drgw.net)
     & Michael Petersen (railfan@drgw.net)

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
*************************************************************************/

#include <stdlib.h>
#include <stdio.h>
#include <string.h>
#include <stdbool.h>

#include <avr/io.h>
#include <avr/interrupt.h>
#include <avr/eeprom.h>
#include <avr/wdt.h>
#include <util/delay.h>
#include <avr/sleep.h>
#include <avr/pgmspace.h>
#include <util/delay.h>
#include <util/atomic.h>

#include "macros.h"
#include "lcd.h"
#include "dc.h"
#include "dcc.h"
#include "userconfig.h"
#include "increment.h"

typedef enum
{
	STATE_LEARN = 0,
	STATE_FTOR_WAIT,
	STATE_RTOF_WAIT,
	STATE_REVERSE,
	STATE_FORWARD,
	STATE_REVDECEL,
	STATE_FWDDECEL,
	STATE_REVINTDECEL,
	STATE_FWDINTDECEL,
	STATE_REVINTWAIT,
	STATE_FWDINTWAIT,
	STATE_REVINTACCEL,
	STATE_FWDINTACCEL,

} OpState;


// ******** Start 100 Hz Timer - Very Accurate Version

// Initialize a 100Hz timer for use in triggering events.
// If you need the timer resources back, you can remove this, but I find it
// rather handy in triggering things like periodic status transmissions.
// If you do remove it, be sure to yank the interrupt handler and ticks/secs as well
// and the call to this function in the main function

volatile uint16_t decisecs=0;
volatile uint16_t screenUpdateDecisecs=0;
volatile uint8_t eventFlags=0;

#define EVENT_TIME_READ_INPUTS      0x01
#define EVENT_TIME_READ_ADCS        0x02
#define EVENT_TIME_ADJUST_SPEED     0x04
#define EVENT_ANALOG_READ_COMPLETE  0x10

uint32_t loopCount = 0;

void blankCursorLine()
{
	lcd_gotoxy(0,2);
	lcd_puts_p(PSTR("                    "));
}

typedef struct
{
	uint16_t clock_A;
	uint16_t clock_B;
	uint16_t debounced_state;
} DebounceState;

void initDebounceState(DebounceState* d, uint16_t initialState)
{
	d->clock_A = d->clock_B = 0;
	d->debounced_state = initialState;
}

uint16_t debounce(uint16_t raw_inputs, DebounceState* d)
{
	uint16_t delta = raw_inputs ^ d->debounced_state;   //Find all of the changes
	uint16_t changes;

	d->clock_A ^= d->clock_B;                     //Increment the counters
	d->clock_B  = ~d->clock_B;

	d->clock_A &= delta;                       //Reset the counters if no changes
	d->clock_B &= delta;                       //were detected.

	changes = ~((~delta) | d->clock_A | d->clock_B);
	d->debounced_state ^= changes;
	return(changes & ~(d->debounced_state));
}


#define TRACK_STATUS_SENSOR_LEFT      0x80
#define TRACK_STATUS_SENSOR_RIGHT     0x40
#define TRACK_STATUS_FAULTED          0x20
#define TRACK_STATUS_SENSOR_MIDPNT    0x10
#define TRACK_STATUS_SENSOR_INT_LEFT  0x08
#define TRACK_STATUS_SENSOR_INT_RIGHT 0x04
#define TRACK_STATUS_STOPPED          0x01

volatile uint16_t adcValue[4];

void initializeADC()
{
	for(uint8_t i=0; i<sizeof(adcValue[0])/sizeof(adcValue); i++)
		adcValue[i] = 0;

	// Setup ADC for bus voltage monitoring
	ADMUX  = 0x44;  // AVCC reference, ADC4 starting channel
	ADCSRA = _BV(ADIF) | _BV(ADPS2) | _BV(ADPS1) | _BV(ADPS0); // 128 prescaler
	ADCSRB = 0x00;  // Free-running mode
	DIDR0  = 0xF0;  // Turn ADC 4-7 into inputs
	ADCSRA |= _BV(ADEN) | _BV(ADSC) | _BV(ADIE) | _BV(ADIF);
}

ISR(ADC_vect)
{
	static uint8_t workingChannel = 0;
	static uint32_t accumulator[4] = {0,0,0,0};
	static uint8_t count = 0;
	
	accumulator[workingChannel++] += ADC;

	if (4 == workingChannel)
	{
		count++;
		workingChannel = 0;
	}
	ADMUX = (ADMUX & 0xF0) | ((workingChannel+4) & 0x07);
	
	if (count >= 128)
	{
		for(uint8_t i=0; i<4; i++)
		{
			adcValue[i] = accumulator[i] / 128;
			accumulator[i] = 0;
		}
		count = 0;
		eventFlags |= EVENT_ANALOG_READ_COMPLETE;
	}

	if (0 == (eventFlags & EVENT_ANALOG_READ_COMPLETE))
	{
		// Trigger the next conversion.  Not using auto-trigger so that we can safely change channels
		ADCSRA |= _BV(ADSC);
	}
}


typedef enum
{
	SCREEN_MAIN_DRAW = 0,
	SCREEN_MAIN_REFRESH = 1,
	SCREEN_MAIN_IDLE = 2,
	
	SCREEN_CONF_MENU_DRAW = 10,
	SCREEN_CONF_MENU_IDLE = 11,

	SCREEN_FAST_RESET_DRAW = 14,
	SCREEN_FAST_RESET_IDLE = 15,

	SCREEN_CONF_OUTPUT_SETUP = 100,
	SCREEN_CONF_OUTPUT_DRAW  = 101,
	SCREEN_CONF_OUTPUT_IDLE  = 102,


	SCREEN_CONF_LOCOLIST_SETUP = 105,
	SCREEN_CONF_LOCOLIST_DRAW  = 106,
	SCREEN_CONF_LOCOLIST_IDLE  = 107,

	SCREEN_CONF_LOCOSLOT1_SETUP = 110,
	SCREEN_CONF_LOCOSLOT1_DRAW  = 111,
	SCREEN_CONF_LOCOSLOT1_IDLE  = 112,

	SCREEN_CONF_LOCOSLOT2_SETUP = 113,
	SCREEN_CONF_LOCOSLOT2_DRAW  = 114,
	SCREEN_CONF_LOCOSLOT2_IDLE  = 115,

	SCREEN_CONF_LOCOSLOT3_SETUP = 116,
	SCREEN_CONF_LOCOSLOT3_DRAW  = 117,
	SCREEN_CONF_LOCOSLOT3_IDLE  = 118,

	SCREEN_LOAD_CONF_SETUP = 120,
	SCREEN_LOAD_CONF_DRAW = 121,
	SCREEN_LOAD_CONF_IDLE = 122,

	SCREEN_CONF_DELAY_SETUP = 125,
	SCREEN_CONF_DELAY_DRAW = 126,
	SCREEN_CONF_DELAY_IDLE = 127,

	SCREEN_CONF_PAUSED_SETUP = 130,
	SCREEN_CONF_PAUSED_DRAW = 131,
	SCREEN_CONF_PAUSED_IDLE = 132,
	
	SCREEN_CONF_MIDDELAY_SETUP = 135,
	SCREEN_CONF_MIDDELAY_DRAW = 136,
	SCREEN_CONF_MIDDELAY_IDLE = 137,
	
	SCREEN_CONF_INTSENSE_SETUP = 140,
	SCREEN_CONF_INTSENSE_DRAW  = 141,
	SCREEN_CONF_INTSENSE_IDLE  = 142,

	SCREEN_CONF_ACCLIST_SETUP = 145,
	SCREEN_CONF_ACCLIST_DRAW  = 146,
	SCREEN_CONF_ACCLIST_IDLE  = 147,

	SCREEN_CONF_ACCCONF_SETUP  = 150,
	SCREEN_CONF_ACCCONF_DRAW   = 151,
	SCREEN_CONF_ACCCONF_IDLE   = 152,
	
	SCREEN_CONF_RELEARN_SETUP = 153,
	SCREEN_CONF_RELEARN_DRAW = 154,
	SCREEN_CONF_RELEARN_IDLE = 155,

	SCREEN_CONF_BACKLITE_SETUP = 235,
	SCREEN_CONF_BACKLITE_DRAW  = 236,
	SCREEN_CONF_BACKLITE_IDLE  = 237,
	SCREEN_CONF_BACKLITE_OFF   = 238,

	SCREEN_CONF_MANUAL_SETUP = 240,
	SCREEN_CONF_MANUAL_DRAW  = 241,
	SCREEN_CONF_MANUAL_IDLE  = 242,

	SCREEN_CONF_RESET_SETUP = 245,
	SCREEN_CONF_RESET_DRAW  = 246,
	SCREEN_CONF_RESET_IDLE  = 247,

	SCREEN_CONF_DIAG_SETUP = 250,
	SCREEN_CONF_DIAG_DRAW  = 251,
	SCREEN_CONF_DIAG_IDLE  = 252,
	
	SCREEN_DONT_KNOW = 255

} ScreenState;


typedef struct
{
	const char* configName;
	ScreenState configScreen;
} ConfigurationOption;

const ConfigurationOption configurationOptions[] = 
{
  { "Locomotive Config",  SCREEN_CONF_LOCOLIST_SETUP },
  { "Accessory Config",   SCREEN_CONF_ACCLIST_SETUP },
  { "DC/DCC Output ",     SCREEN_CONF_OUTPUT_SETUP },
  { "Endpoint Delay",     SCREEN_CONF_DELAY_SETUP },
  { "Midpoint Delay",     SCREEN_CONF_MIDDELAY_SETUP },  
  { "Midpoints Enable",   SCREEN_CONF_INTSENSE_SETUP },
  { "Pause on Start",     SCREEN_CONF_PAUSED_SETUP },
  { "Stop Relearns Dir",   SCREEN_CONF_RELEARN_SETUP },
  { "Backlight Timeout",  SCREEN_CONF_BACKLITE_SETUP },  
  { "Turn Off Backlight", SCREEN_CONF_BACKLITE_OFF },  
  { "Diagnostics",        SCREEN_CONF_DIAG_SETUP },  
  { "Factory Reset",      SCREEN_CONF_RESET_SETUP },  
};

#define NUM_CONF_OPTIONS  (sizeof(configurationOptions)/sizeof(ConfigurationOption))

void initialize100HzTimer(void)
{
	// Set up timer 3 for 100Hz interrupts
	TCNT3 = 0;
	OCR3A = 0x0752;
	TCCR3A = 0;
	TCCR3B = _BV(WGM32) | _BV(CS31) | _BV(CS30);
	TCCR3C = 0;
	TIFR3 |= _BV(OCF3A);
	TIMSK3 |= _BV(OCIE3A);
	
	decisecs = 0;
	screenUpdateDecisecs = 0;
}

ISR(TIMER3_COMPA_vect)
{
	static uint8_t ticks = 0;

	if (++ticks & 0x01)
		eventFlags |= EVENT_TIME_READ_INPUTS;

	if (ticks >= 10)
	{
		ticks = 0;
		decisecs++;
		screenUpdateDecisecs++;
		eventFlags |= EVENT_TIME_READ_ADCS | EVENT_TIME_ADJUST_SPEED;
	}
}

#define LCD_BACKLIGHT_PIN  PB4

void lcd_backlightOn()
{
	DDRB |= _BV(LCD_BACKLIGHT_PIN);
	PORTB |= _BV(LCD_BACKLIGHT_PIN);
}

void lcd_backlightOff()
{
	DDRB |= _BV(LCD_BACKLIGHT_PIN);
	PORTB &= ~_BV(LCD_BACKLIGHT_PIN);
}

#define PANEL_SWITCH_MASK (_BV(PC2) | _BV(PC3) | _BV(PC4) | _BV(PC5))
#define SENSOR_INPUT_MASK (_BV(PD7) | _BV(PD6))
#define INT_SENSOR_INPUT_MASK (_BV(PC6) | _BV(PC7))

#define SOFTKEY_1      0x01
#define SOFTKEY_2      0x02
#define SOFTKEY_3      0x04
#define SOFTKEY_4      0x08
#define SOFTKEY_1_LONG 0x10
#define SOFTKEY_2_LONG 0x20
#define SOFTKEY_3_LONG 0x40
#define SOFTKEY_4_LONG 0x80

#define FAULT_IN         0x0020
#define SENSOR_LEFT      0x0040
#define SENSOR_RIGHT     0x0080
#define SENSOR_INT_LEFT  0x0100
#define SENSOR_INT_RIGHT 0x0200


void initializeSwitches(void)
{
	DDRC &= ~(PANEL_SWITCH_MASK);  // Make panel switches inputs
	PORTC |= (PANEL_SWITCH_MASK);  // Turn on pull-ups

	DDRD &= ~(SENSOR_INPUT_MASK);  // Make sensor input connections inputs
	PORTD |= (SENSOR_INPUT_MASK);  // Turn on pull-ups (already has externals)
	DDRC &= ~(INT_SENSOR_INPUT_MASK);  // Make intermediate sensors inputs (I2C lines)
	PORTC |= (INT_SENSOR_INPUT_MASK);  // Turn on pull-ups

	DDRD &= ~(_BV(PD2)); // Fault input
	PORTD |= _BV(PD2); // Fault input
}

uint16_t readSwitches()
{
	uint16_t sensors = (uint16_t)(PIND & SENSOR_INPUT_MASK) | (((uint16_t)(PINC & INT_SENSOR_INPUT_MASK))<<2);
	uint8_t switches = ((PINC & PANEL_SWITCH_MASK)>>2);

	uint8_t fault = (PIND & _BV(PD2))?0x20:0x00;
	// We want the upper two bits of sensors and the lower four of switches
	// These are active low, so we need to be careful how we put them together
	
	return (sensors & 0x03C0) | (fault & 0x20) |  (switches & 0x0F);
}

void init(void)
{
	// Kill watchdog
	MCUSR = 0;
	wdt_reset();
	wdt_enable(WDTO_1S);
	eventFlags = 0;
	wdt_reset();

	memset((uint8_t*)nextDCCPacket.data, 0, sizeof(nextDCCPacket.data));
	nextDCCPacket.len = 0;

	initializeSwitches();
	// Set Up LCD Panel
	lcd_backlightOn();
	lcd_init(LCD_DISP_ON);
	lcd_clrscr();
	lcd_gotoxy(0,0);

	// Set up tick timer
	initialize100HzTimer();
	initializeADC();
	// Enable interrupts
	sei();
}

void drawSplashScreen()
{
	char buffer[24];
	lcd_setup_bigdigits();
	lcd_gotoxy(0,0);
	//               00000000001111111111
	//               01234567890123456789
	//                        ||
	lcd_gotoxy(0,0);
	memset(buffer, 0, sizeof(buffer));
	sprintf(buffer, " The Motorman  v%d.%d", SWREV_MAJOR, SWREV_MINOR);
	lcd_puts(buffer);
	lcd_gotoxy(0,1);
	lcd_puts_p(PSTR(" Shuttle Controller "));
	lcd_gotoxy(0,2);
	lcd_puts_p(PSTR("Iowa Scaled Eng 2022"));
	lcd_gotoxy(0,3);
	lcd_puts_p(PSTR("  www.iascaled.com  "));
	
	for(uint8_t i=0; i<30; i++)
	{
		wdt_reset();
		_delay_ms(100);
	}
	lcd_clrscr();
}

void calcIntermediateAccFunctions(uint8_t trackStatus, AccConfig* accConfig, OpState opState)
{
	for(uint8_t r = 0; r<NUM_ACC_OPTIONS; r++)
	{
		if(0 == accConfig[r].address)
			continue;
			
		// Only do the intermediate functions
		switch(accConfig[r].trigMode)
		{
			case ACC_LI_ST:
				if ((opState == STATE_FWDINTDECEL || opState == STATE_REVINTDECEL) && (trackStatus & TRACK_STATUS_SENSOR_INT_LEFT))
					accPktQueuePush(accConfig[r].address, accConfig[r].currentState = true);
				else if ((opState == STATE_FWDINTACCEL || opState == STATE_REVINTACCEL) && true == accConfig[r].currentState)
					accPktQueuePush(accConfig[r].address, accConfig[r].currentState = false);
				break;
				
			case ACC_RI_ST:
				if ((opState == STATE_FWDINTDECEL || opState == STATE_REVINTDECEL) && (trackStatus & TRACK_STATUS_SENSOR_INT_RIGHT))
					accPktQueuePush(accConfig[r].address, accConfig[r].currentState = true);
				else if ((opState == STATE_FWDINTACCEL || opState == STATE_REVINTACCEL) && true == accConfig[r].currentState)
					accPktQueuePush(accConfig[r].address, accConfig[r].currentState = false);
				break;
				
			case ACC_XI_ST:
				if ((opState == STATE_FWDINTDECEL || opState == STATE_REVINTDECEL) && (trackStatus & (TRACK_STATUS_SENSOR_INT_RIGHT | TRACK_STATUS_SENSOR_INT_LEFT)))
					accPktQueuePush(accConfig[r].address, accConfig[r].currentState = true);
				else if ((opState == STATE_FWDINTACCEL || opState == STATE_REVINTACCEL) && true == accConfig[r].currentState)
					accPktQueuePush(accConfig[r].address, accConfig[r].currentState = false);
				break;
			default: // Don't do anything
				break; 
		}
	}
}

void calcEndpointAccFunctions(uint8_t trackStatus, AccConfig* accConfig, OpState opState)
{
	for(uint8_t r = 0; r<NUM_ACC_OPTIONS; r++)
	{
		if(0 == accConfig[r].address)
			continue;

		switch(accConfig[r].trigMode)
		{
			case ACC_LS_RC:
				if (opState == STATE_FWDDECEL || opState == STATE_REVDECEL)
				{
					if ((opState == STATE_FWDDECEL || opState == STATE_REVDECEL) && (trackStatus & TRACK_STATUS_SENSOR_LEFT))
						accPktQueuePush(accConfig[r].address, accConfig[r].currentState = true);
					else if (trackStatus & TRACK_STATUS_SENSOR_RIGHT)
						accPktQueuePush(accConfig[r].address, accConfig[r].currentState = false);
				}
				break;
				
			case ACC_LC_RS:
				if (opState == STATE_FWDDECEL || opState == STATE_REVDECEL)
				{
					if (trackStatus & TRACK_STATUS_SENSOR_LEFT)
						accPktQueuePush(accConfig[r].address, accConfig[r].currentState = false);
					else if (trackStatus & TRACK_STATUS_SENSOR_RIGHT)
						accPktQueuePush(accConfig[r].address, accConfig[r].currentState = true);
				}
				break;

			case ACC_LSTOG:
				if ((opState == STATE_FWDDECEL || opState == STATE_REVDECEL) && (trackStatus & TRACK_STATUS_SENSOR_LEFT))
					accPktQueuePush(accConfig[r].address, accConfig[r].currentState = !accConfig[r].currentState);
				break;

			case ACC_RSTOG:
				if ((opState == STATE_FWDDECEL || opState == STATE_REVDECEL) && (trackStatus & TRACK_STATUS_SENSOR_RIGHT))
					accPktQueuePush(accConfig[r].address, accConfig[r].currentState = !accConfig[r].currentState);
				break;

			case ACC_XSTOG:
				if ((opState == STATE_FWDDECEL || opState == STATE_REVDECEL) && (trackStatus & (TRACK_STATUS_SENSOR_RIGHT | TRACK_STATUS_SENSOR_LEFT)))
					accPktQueuePush(accConfig[r].address, accConfig[r].currentState = !accConfig[r].currentState);
				break;

			case ACC_LE_ST: // this should set when entering the left end, clear when departing
				if ((opState == STATE_FWDDECEL || opState == STATE_REVDECEL) && (trackStatus & TRACK_STATUS_SENSOR_LEFT))
					accPktQueuePush(accConfig[r].address, accConfig[r].currentState = true);
				else if ((opState == STATE_RTOF_WAIT || opState == STATE_FTOR_WAIT) && true == accConfig[r].currentState)
					accPktQueuePush(accConfig[r].address, accConfig[r].currentState = false);
				break;
			case ACC_RE_ST:
				if ((opState == STATE_FWDDECEL || opState == STATE_REVDECEL) && (trackStatus & TRACK_STATUS_SENSOR_RIGHT))
					accPktQueuePush(accConfig[r].address, accConfig[r].currentState = true);
				else if ((opState == STATE_RTOF_WAIT || opState == STATE_FTOR_WAIT) && true == accConfig[r].currentState)
					accPktQueuePush(accConfig[r].address, accConfig[r].currentState = false);
			case ACC_XE_ST:
				if ((opState == STATE_FWDDECEL || opState == STATE_REVDECEL) && (trackStatus & (TRACK_STATUS_SENSOR_LEFT | TRACK_STATUS_SENSOR_RIGHT)))
					accPktQueuePush(accConfig[r].address, accConfig[r].currentState = true);
				else if ((opState == STATE_RTOF_WAIT || opState == STATE_FTOR_WAIT) && true == accConfig[r].currentState)
					accPktQueuePush(accConfig[r].address, accConfig[r].currentState = false);
				break;


			case ACC_INIT: // Only sets initially
			case ACC_DISBL: // Does nothing
			default:
				break;
		}
	}
}


/* Screen Layouts

//  Main Screen
//  00000000001111111111
//  01234567890123456789
// [ADR:xxxx vv.vV a.aaA]
// [SPD:nnn%  RAMP:yy.ys]
// [DIR:fff    SENSE:-/-]
// [LOAD REV  STOP CONF ]
//  1111 2222 3333 4444
// xxxx = Unit number (4 digit, sNNN for short, or *DC* for DC)
// nnn = Speed, 0-100%
// STOP softkey says "RUN" when stopped
// yy.y = Ramp, 0-25.5 seconds
// a.aa = Track amps
// v.v = Track volts
// fff = FWD/REV (direction)
// REV softkey will say "FWD" if direction is reversed
// [ADR:xxxx  **FAULT** ] <-- Top line if driver is faulted
// 

// Configuration Options
// - DC/DCC
// - Loco Config
// - 

//  Loco Configuration Slots Screen (15 slots?)
//  00000000001111111111
//  01234567890123456789
// [> nn A:xxxx nnn/yy.y]
// [> nn A:xxxx nnn/yy.y]
// [> nn A:xxxx         ]
// [ UP  DOWN SLCT BACK ]
// nn = locomotive slot number or DC (slot 0)
// xxxx = address (or *DC* for DC)
// nnn = max speed %
// yy.y = ramp time



//  Diagnostic Screen
//  00000000001111111111
//  01234567890123456789
// [IN:vv.vV ]
// [A:vv.v B:vv.v I:a.aa]
// [S:-/- F:n           ]
// [PHSA PHSB      BACK ]
// F:n - n=Y/N for faulted
*/
void drawSoftKeys_p(const char* key1Text, const char* key2Text, const char* key3Text, const char* key4Text)
{
	uint8_t i;

	lcd_gotoxy(0,3);
	for(i=0; i<20; i++)
		lcd_putc(' ');

	lcd_gotoxy(0,3);
	lcd_puts_p(key1Text);
	lcd_gotoxy(5,3);
	lcd_puts_p(key2Text);
	lcd_gotoxy(10,3);
	lcd_puts_p(key3Text);
	lcd_gotoxy(15,3);
	lcd_puts_p(key4Text);
}





#define ANALOG_CHANNEL_PHASE_A_VOLTS  0
#define ANALOG_CHANNEL_PHASE_B_VOLTS  1
#define ANALOG_CHANNEL_INPUT_VOLTS    2
#define ANALOG_CHANNEL_TRACK_CURRENT  3




int main(void)
{
	uint8_t buttonsPressed=0;
	uint8_t configMenuOption = 0;
	uint32_t kloopsPerSec=0;
	uint8_t trackStatus = 0;
	uint16_t inputVoltage=0, phaseAVoltage=0, phaseBVoltage=0, trackCurrent=0, trackVoltage=0;

	char screenLineBuffer[21];
	uint8_t configSaveU8 = 0;
	uint8_t configSaveU8_2 = 0;
	uint8_t configSaveFuncs[5];
	uint8_t locoSlotOption = 0;
	OpState opState = STATE_LEARN;
	ScreenState screenState = SCREEN_MAIN_DRAW;
	LocoConfig currentLoco, tmpLocoConfig;
	OpsConfiguration opsConfig;
	AccConfig accConfig[NUM_ACC_OPTIONS];
	AccConfig tmpAccConfig;
	uint16_t endStopDelay = 0;
	uint16_t backlightDelay = 0xFFFF;
	uint8_t buttonLongPressCounters[4] = {3,3,3,3};
	DebounceState d;
	uint8_t fwdSensorMask = 0, revSensorMask = 0;
	uint8_t fwdIntSensorMask = 0, revIntSensorMask = 0;
	bool forceBacklightOff = false;

	memset(&currentLoco, 0, sizeof(currentLoco));
	memset(&tmpLocoConfig, 0, sizeof(tmpLocoConfig));


	// ***************************************************************************
	// Application initialization
	init();
	initDebounceState(&d, 0xFFFF); // Initialize all high since all inputs are active low

	loadOpsConfiguration(&opsConfig);
	opsConfig.stopped = true;

	loadLocoConfiguration(opsConfig.activeLocoConfig, &currentLoco);
	for(uint8_t i = 0; i<NUM_ACC_OPTIONS; i++)
		loadAccConfiguration(i, &accConfig[i]);


	// Initialize the output driver to either DC or DCC operation
	// In the event of DCC, send the initial state of all accessories
	
	if (opsConfig.dcMode)
		dc_init();
	else
	{
		dcc_init();
		for(uint8_t r = 0; r<NUM_ACC_OPTIONS; r++)
		{
			if(0 != accConfig[r].address && ACC_DISBL != accConfig[r].trigMode)
			{
				accPktQueuePush(accConfig[r].address, accConfig[r].startState);
				accConfig[r].currentState = accConfig[r].startState;
			}
		}
	}
	drawSplashScreen();
	wdt_reset();



	loopCount = 0;

	opState = STATE_LEARN;
	opsConfig.stopped = opsConfig.startPaused;
	opsConfig.requestedSpeed = (int16_t)currentLoco.maxSpeed * 100;
	backlightDelay = opsConfig.backlightTimeout * 10;

	while (1)
	{
		bool updateData = false;
		loopCount++;
		wdt_reset();
		
		// STEP 1 - Check Event Flags from 100Hz ISR and see if it's time to scan the inputs (every 20mS)

		if (eventFlags & EVENT_TIME_READ_INPUTS)
		{
			eventFlags &= ~(EVENT_TIME_READ_INPUTS);
			
			buttonsPressed = 0x0F & (debounce(readSwitches(), &d));
			
			for(uint8_t btn=0; btn<4; btn++)
			{
				if (buttonsPressed & (1<<btn))
					buttonLongPressCounters[btn] = 25; // On initial press, we set a 0.5s delay before rapid

				if (d.debounced_state & (1<<btn))
					buttonLongPressCounters[btn] = 25; // Long delay if the button is up, too
				else
				{
					// Button is down
					if (buttonLongPressCounters[btn])
						buttonLongPressCounters[btn]--;
					else
					{
						buttonsPressed |= (1<<(btn+4));
						buttonLongPressCounters[btn] = 5; // Repeat time
					}
				}
			}

			// If any button is pressed, reset backlight delay
			if (buttonsPressed)
			{
				if ((0 == backlightDelay && opsConfig.backlightTimeout != 0) || forceBacklightOff)
				{
					// If we're timed out and the backlight is off, eat the first
					// keystroke
					buttonsPressed &= 0xF0;
					forceBacklightOff = false;
					lcd_backlightOn();
				}
				backlightDelay = opsConfig.backlightTimeout * 10;
			}

			if (d.debounced_state & FAULT_IN)
				trackStatus &= ~TRACK_STATUS_FAULTED;
			else
				trackStatus |= TRACK_STATUS_FAULTED;
				
			
			if (d.debounced_state & SENSOR_LEFT)
				trackStatus &= ~TRACK_STATUS_SENSOR_LEFT;
			else
				trackStatus |= TRACK_STATUS_SENSOR_LEFT;
				
			if (d.debounced_state & SENSOR_RIGHT)
				trackStatus &= ~TRACK_STATUS_SENSOR_RIGHT;
			else
				trackStatus |= TRACK_STATUS_SENSOR_RIGHT;
				
			if (d.debounced_state & SENSOR_INT_LEFT)
				trackStatus &= ~TRACK_STATUS_SENSOR_INT_LEFT;
			else
				trackStatus |= TRACK_STATUS_SENSOR_INT_LEFT;
				
			if (d.debounced_state & SENSOR_INT_RIGHT)
				trackStatus &= ~TRACK_STATUS_SENSOR_INT_RIGHT;
			else
				trackStatus |= TRACK_STATUS_SENSOR_INT_RIGHT;
		}

		// STEP 2 - Run Ping-Pong State Machine
		//  Now that we have the sensor inputs read and debounced, run the state machine to
		//  see if we need to change states of motion

		switch(opState)
		{
			case STATE_LEARN:
				fwdSensorMask = 0;
				revSensorMask = 0;
				fwdIntSensorMask = 0;
				revIntSensorMask = 0;
				
				if (opsConfig.requestedSpeed >= 0)
					opsConfig.requestedSpeed = (int16_t)currentLoco.maxSpeed * 100;
				else
					opsConfig.requestedSpeed = -(int16_t)currentLoco.maxSpeed * 100;

				if (opsConfig.speed > 0)
				{
					if (trackStatus & TRACK_STATUS_SENSOR_LEFT)
					{
						fwdSensorMask = TRACK_STATUS_SENSOR_LEFT;
						revSensorMask = TRACK_STATUS_SENSOR_RIGHT;
						fwdIntSensorMask = TRACK_STATUS_SENSOR_INT_RIGHT; // These are backwards because the right sensor will hit first for intermediates
						revIntSensorMask = TRACK_STATUS_SENSOR_INT_LEFT;
						opState = STATE_FWDDECEL;
						calcEndpointAccFunctions(trackStatus, accConfig, opState);

					} else if (trackStatus & TRACK_STATUS_SENSOR_RIGHT) {
						fwdSensorMask = TRACK_STATUS_SENSOR_RIGHT;
						revSensorMask = TRACK_STATUS_SENSOR_LEFT;
						fwdIntSensorMask = TRACK_STATUS_SENSOR_INT_LEFT; // These are backwards because the left sensor will hit first for intermediates
						revIntSensorMask = TRACK_STATUS_SENSOR_INT_RIGHT;
						opState = STATE_FWDDECEL;
						calcEndpointAccFunctions(trackStatus, accConfig, opState);
					}
				} else if (opsConfig.speed < 0) {
					if (trackStatus & TRACK_STATUS_SENSOR_LEFT)
					{
						fwdSensorMask = TRACK_STATUS_SENSOR_RIGHT;
						revSensorMask = TRACK_STATUS_SENSOR_LEFT;
						fwdIntSensorMask = TRACK_STATUS_SENSOR_INT_LEFT;
						revIntSensorMask = TRACK_STATUS_SENSOR_INT_RIGHT;
						opState = STATE_REVDECEL;
						calcEndpointAccFunctions(trackStatus, accConfig, opState);
					} else if (trackStatus & TRACK_STATUS_SENSOR_RIGHT) {
						fwdSensorMask = TRACK_STATUS_SENSOR_LEFT;
						revSensorMask = TRACK_STATUS_SENSOR_RIGHT;
						fwdIntSensorMask = TRACK_STATUS_SENSOR_INT_RIGHT;
						revIntSensorMask = TRACK_STATUS_SENSOR_INT_LEFT;
						opState = STATE_REVDECEL;
						calcEndpointAccFunctions(trackStatus, accConfig, opState);
					}
				}
				break;
				
			case STATE_FTOR_WAIT:
				opsConfig.requestedSpeed = 0;
				if (0 == endStopDelay)
				{
					calcEndpointAccFunctions(trackStatus, accConfig, opState);
					opState = STATE_REVERSE;
				}
				break;
			
			case STATE_RTOF_WAIT:
				opsConfig.requestedSpeed = 0;
				if (0 == endStopDelay)
				{
					calcEndpointAccFunctions(trackStatus, accConfig, opState);
					opState = STATE_FORWARD;
				}
				break;
			
			case STATE_FORWARD:
				if (trackStatus & fwdSensorMask)
				{
					opsConfig.requestedSpeed = 0;
					opState = STATE_FWDDECEL;
					calcEndpointAccFunctions(trackStatus, accConfig, opState);
				} else if (opsConfig.intStopsEnable && (trackStatus & fwdIntSensorMask)) {
					opsConfig.requestedSpeed = 0;
					opState = STATE_FWDINTDECEL;
					calcIntermediateAccFunctions(trackStatus, accConfig, opState);
				} else {
					opsConfig.requestedSpeed = (int16_t)currentLoco.maxSpeed*100;
				}
				break;

			case STATE_REVERSE:
				if (trackStatus & revSensorMask)
				{
					opsConfig.requestedSpeed = 0;
					opState = STATE_REVDECEL;
					calcEndpointAccFunctions(trackStatus, accConfig, opState);
				} else if (opsConfig.intStopsEnable && (trackStatus & revIntSensorMask)) {
					opsConfig.requestedSpeed = 0;
					opState = STATE_REVINTDECEL;
					calcIntermediateAccFunctions(trackStatus, accConfig, opState);
				} else {
					opsConfig.requestedSpeed = -((int16_t)currentLoco.maxSpeed*100);
				}
				break;

			case STATE_REVDECEL:
				opsConfig.requestedSpeed = 0;
				if (0 == opsConfig.speed)
				{
					endStopDelay = opsConfig.endpointDelay * 10;
					opState = STATE_RTOF_WAIT;
				}
				break;

			case STATE_REVINTDECEL:
				opsConfig.requestedSpeed = 0;
				if (0 == opsConfig.speed)
				{
					endStopDelay = opsConfig.midpointDelay * 10;
					opState = STATE_REVINTWAIT;
				}
				break;

			case STATE_REVINTWAIT:
				opsConfig.requestedSpeed = 0;
				if (0 == endStopDelay)
				{
					opState = STATE_REVINTACCEL;
					opsConfig.requestedSpeed = -((int16_t)currentLoco.maxSpeed*100);
				}
				break;

			case STATE_REVINTACCEL:
				opsConfig.requestedSpeed = -((int16_t)currentLoco.maxSpeed*100);
				if (!(trackStatus & revIntSensorMask))
				{
					calcIntermediateAccFunctions(trackStatus, accConfig, opState);
					opState = STATE_REVERSE;
				}
				break;

			case STATE_FWDDECEL:
				opsConfig.requestedSpeed = 0;
				if (0 == opsConfig.speed)
				{
					endStopDelay = opsConfig.endpointDelay * 10;
					opState = STATE_FTOR_WAIT;
				}
				break;

			case STATE_FWDINTDECEL:
				opsConfig.requestedSpeed = 0;
				if (0 == opsConfig.speed)
				{
					endStopDelay = opsConfig.midpointDelay * 10;
					opState = STATE_FWDINTWAIT;
				}
				break;

			case STATE_FWDINTWAIT:
				opsConfig.requestedSpeed = 0;
				if (0 == endStopDelay)
				{
					opState = STATE_FWDINTACCEL;
					opsConfig.requestedSpeed = (int16_t)currentLoco.maxSpeed*100;
				}
				break;

			case STATE_FWDINTACCEL:
				opsConfig.requestedSpeed = (int16_t)currentLoco.maxSpeed*100;
				if (!(trackStatus & fwdIntSensorMask))
				{
					calcIntermediateAccFunctions(trackStatus, accConfig, opState);
					opState = STATE_FORWARD;
				}
				break;

			default:
				opState = STATE_LEARN;
				break;
		}

		// STEP 3 - If it's time to adjust speed (every 100mS), send a new speed to the output
		//  mechanism (DC or DCC)

		if (eventFlags & EVENT_TIME_ADJUST_SPEED)
		{
			eventFlags &= ~(EVENT_TIME_ADJUST_SPEED);
			
			if (endStopDelay > 0)
				endStopDelay--;

			if (0 == opsConfig.backlightTimeout)
				backlightDelay = 255;  // Never let the backlight time out if configured to never sleep

			if (forceBacklightOff || 0 == backlightDelay )
				lcd_backlightOff();
			else
			{
				if (backlightDelay > 0)
					backlightDelay--;
				lcd_backlightOn();
			}

			// Time to re-evaluate speed
			if (opsConfig.stopped)  // If a stop is requested, immediately set speed to 0
				opsConfig.speed = 0;
			else if (opsConfig.requestedSpeed != opsConfig.speed)
			{
				// Ramp rate is the number of deciseconds it should take to go from 0-max
				// What we need is the speed change per decisecond
				// Fix 1/4/2021 - add a floor for the max speed, otherwise at 0 it never turns off, and at only a couple percent
				//  it takes forever
				uint16_t incrementsPerDecisec = (int16_t)max(5,currentLoco.maxSpeed)*100 / currentLoco.rampRate;
				
				// Which is less, the current difference or the ramp increment?
				uint16_t increment = min(abs(opsConfig.speed - opsConfig.requestedSpeed), incrementsPerDecisec);
				
				if (opsConfig.requestedSpeed > opsConfig.speed)
					opsConfig.speed += increment;
				else if (opsConfig.requestedSpeed < opsConfig.speed)
					opsConfig.speed -= increment;
			}

			// Set speed / direction
			if (opsConfig.dcMode)
				dc_setSpeedAndDir(abs(opsConfig.speed) / 100, (opsConfig.speed >= 0)?0:1);
			else
			{
				uint32_t accDecFunctions = 0;
				if (opState == STATE_REVDECEL || opState == STATE_REVINTDECEL || opState == STATE_REVINTWAIT || opState == STATE_RTOF_WAIT
					|| opState == STATE_FWDDECEL || opState == STATE_FWDINTDECEL || opState == STATE_FWDINTWAIT || opState == STATE_FTOR_WAIT || opsConfig.stopped)
				{
					// If we're in a known deceleration or stopping mode, activate decelerate functions (like brake)
					accDecFunctions = currentLoco.decFunctions;
				} else if (opsConfig.requestedSpeed != opsConfig.speed) {
					// If we're in any other mode and requested speed != speed, assume accel and set functions
					accDecFunctions = currentLoco.accFunctions;
				}
				
				
				dcc_setSpeedAndDir(currentLoco.address, currentLoco.shortDCCAddress, 
					abs(opsConfig.speed) / 100, (opsConfig.speed >= 0)?0:1,
					currentLoco.allFunctions | accDecFunctions | ((opsConfig.speed >= 0)?currentLoco.fwdFunctions:currentLoco.revFunctions));
			}
		}

		// Whether or not we've changed speed, we need to call the DCC scheduler so that it can fill the packet buffer
		//  if it's empty
		dcc_scheduler();

		// STEP 4 - Read the ADCs
		if ((eventFlags & EVENT_TIME_READ_ADCS) && (eventFlags & EVENT_ANALOG_READ_COMPLETE))
		{
			// Analog readings are done - go get and process the values
			
			// ADC decivolts = adcValue[] * 33 / 1023
			// Real volts to ADC decivolts = ADC * 11
			// adcValue[ANALOG_CHANNEL_INPUT_VOLTS] * 33 * 11 / 1023
			// simplified, that's adc * 11 / 31
			
			// Iin = adcdecivolts / (20 * 0.07 * 10)
			// Iin = (adc * 33) / (1023 * 14)
			// cIin = adc * 100 / 434
			
			inputVoltage = adcValue[ANALOG_CHANNEL_INPUT_VOLTS] * 11 / 31;
			phaseAVoltage = adcValue[ANALOG_CHANNEL_PHASE_A_VOLTS] * 11 / 31;
			phaseBVoltage = adcValue[ANALOG_CHANNEL_PHASE_B_VOLTS] * 11 / 31;
			trackCurrent = adcValue[ANALOG_CHANNEL_TRACK_CURRENT] * 100 / 434;
			if (opsConfig.dcMode)
				trackVoltage = max(phaseAVoltage, phaseBVoltage);
			else
				trackVoltage = (phaseAVoltage + phaseBVoltage);
			
			// Restart ADC for another round
			eventFlags &= ~(EVENT_ANALOG_READ_COMPLETE | EVENT_TIME_READ_ADCS);
			ADCSRA |= _BV(ADSC);
			updateData = true;
		}
		
		// STEP 5 - Deal with the gigantic UI management state machine
		// This really should be better
		switch(screenState)
		{
			case SCREEN_MAIN_DRAW:
				lcd_clrscr();
//  Main Screen
//  00000000001111111111
//  01234567890123456789
// [ADR:xxxx vv.vV a.aaA]
// [SPD:Fnnn (Fnnn)  STA]
// [RMP:yy.ys L-?/R-?/I-]
// [LOAD REV  STOP CONF ]
				lcd_gotoxy(0, 0);
				lcd_puts_p(PSTR("ADR:"));
				if (opsConfig.dcMode)
					lcd_puts_p(PSTR("*DC*"));
				else
				{
					if (currentLoco.shortDCCAddress)
						snprintf(screenLineBuffer, sizeof(screenLineBuffer), "s%03d", (currentLoco.address & 0xFF));
					else
						snprintf(screenLineBuffer, sizeof(screenLineBuffer), "%04d", currentLoco.address);
					lcd_puts(screenLineBuffer);
				}
				lcd_gotoxy(0,1);
				lcd_puts_p(PSTR("SPD:"));

				// Display ramp rate
				lcd_gotoxy(0, 2);
				lcd_puts_p(PSTR("RMP:"));
				snprintf(screenLineBuffer, sizeof(screenLineBuffer), "%02d.%01ds", currentLoco.rampRate/10, currentLoco.rampRate%10);
				lcd_puts(screenLineBuffer);
				
				// Display sensor input status
				lcd_gotoxy(10, 2);
				// Intentional fall-through

			case SCREEN_MAIN_REFRESH:
				lcd_gotoxy(9, 0);
				if (trackStatus & TRACK_STATUS_FAULTED)
				{
					lcd_puts_p(PSTR("** FAULT **"));
				} else {
					snprintf(screenLineBuffer, sizeof(screenLineBuffer), "%02d.%01dV %01d.%02dA", trackVoltage/10, trackVoltage%10, trackCurrent/100, trackCurrent%100);
					lcd_puts(screenLineBuffer);
				}
				
				
				// Display speed
				lcd_gotoxy(4, 1);
				snprintf(screenLineBuffer, sizeof(screenLineBuffer), "%c%03d", (opsConfig.speed<0)?'R':'F', abs(opsConfig.speed)/100);
				lcd_puts(screenLineBuffer);
				lcd_gotoxy(9, 1);
				if (!opsConfig.stopped)
				{
					snprintf(screenLineBuffer, sizeof(screenLineBuffer), "(%c%03d)", (opsConfig.requestedSpeed<0)?'R':'F', abs(opsConfig.requestedSpeed)/100);
					lcd_puts(screenLineBuffer);
				}
				else
					lcd_puts_p(PSTR("(STOP)"));


				lcd_gotoxy(16, 1);
				{
					char opStateStr[5];
					switch(opState)
					{
						case STATE_LEARN:
							strcpy(opStateStr, "LRN ");
							break;
						case STATE_FTOR_WAIT:
							strcpy(opStateStr, "FTR ");
							break;
						case STATE_RTOF_WAIT:
							strcpy(opStateStr, "RTF ");
							break;
						case STATE_REVERSE:
							strcpy(opStateStr, "REV ");
							break;
						case STATE_FORWARD:
							strcpy(opStateStr, "FWD ");
							break;
						case STATE_REVDECEL:
							strcpy(opStateStr, "RDC ");
							break;
						case STATE_FWDDECEL:
							strcpy(opStateStr, "FDC ");
							break;

						case STATE_REVINTDECEL:
							strcpy(opStateStr, "RID ");
							break;
						case STATE_FWDINTDECEL:
							strcpy(opStateStr, "FID ");
							break;
						case STATE_REVINTWAIT:
							strcpy(opStateStr, "RIW ");
							break;
						case STATE_FWDINTWAIT:
							strcpy(opStateStr, "FIW ");
							break;
						case STATE_REVINTACCEL:
							strcpy(opStateStr, "RIA ");
							break;
						case STATE_FWDINTACCEL:
							strcpy(opStateStr, "FIA ");
							break;


						default:
							snprintf(opStateStr, sizeof(opStateStr), "%03d", opState);
							break;
					}
					lcd_puts(opStateStr);
				}

				lcd_gotoxy(10,2);
				// [RMP:yy.ys L-?/R-?/I-]
				lcd_putc('L');
				lcd_putc((trackStatus & TRACK_STATUS_SENSOR_LEFT)?'*':'-');

				if (TRACK_STATUS_SENSOR_LEFT == fwdSensorMask)
					lcd_putc('F');
				else if (TRACK_STATUS_SENSOR_LEFT == revSensorMask)
					lcd_putc('R');
				else
					lcd_putc('?');
				lcd_putc('/');
				lcd_putc('R');
				lcd_putc((trackStatus & TRACK_STATUS_SENSOR_RIGHT)?'*':'-');

				if (TRACK_STATUS_SENSOR_RIGHT == fwdSensorMask)
					lcd_putc('F');
				else if (TRACK_STATUS_SENSOR_RIGHT == revSensorMask)
					lcd_putc('R');
				else
					lcd_putc('?');

				if (opsConfig.intStopsEnable)
				{
					lcd_putc('/');
					lcd_putc('I');
					if ((trackStatus & (TRACK_STATUS_SENSOR_INT_RIGHT | TRACK_STATUS_SENSOR_INT_LEFT)) ==  (TRACK_STATUS_SENSOR_INT_RIGHT | TRACK_STATUS_SENSOR_INT_LEFT))
						lcd_putc('A');
					else if (trackStatus & (TRACK_STATUS_SENSOR_INT_RIGHT))
						lcd_putc('R');
					else if (trackStatus & (TRACK_STATUS_SENSOR_INT_LEFT))
						lcd_putc('L');
					else
						lcd_putc('-');
				}

				drawSoftKeys_p(opsConfig.dcMode?PSTR(""):PSTR("LOAD"),  PSTR("MANL"), (opsConfig.stopped)?PSTR("RUN!"):PSTR("STOP"), PSTR("CONF"));
				buttonsPressed = 0;
				screenState = SCREEN_MAIN_IDLE;
				break;

			case SCREEN_MAIN_IDLE:
				if(updateData)
					screenState = SCREEN_MAIN_REFRESH;
			
				if ((SOFTKEY_1 & buttonsPressed) && !opsConfig.dcMode)
				{
					// The "Load" key only works in DCC mode
					// Do stuff here to change to load configuration screen
					screenState = SCREEN_LOAD_CONF_SETUP;
				}
				else if (SOFTKEY_2 & buttonsPressed)
				{
					screenState = SCREEN_CONF_MANUAL_SETUP;
				}
				else if (SOFTKEY_3 & buttonsPressed)
				{
					opsConfig.stopped = !opsConfig.stopped;
					if (opsConfig.stopped)
					{
						opsConfig.speed = 0;
						if (opsConfig.stopRetriggersLearnMode)
							opState = STATE_LEARN; // Put it back in learning mode
					}
					
					screenState = SCREEN_MAIN_REFRESH;
				}
				else if (SOFTKEY_4 & buttonsPressed)
				{
					// Load Configuration menu
					screenState = SCREEN_CONF_MENU_DRAW;
					configMenuOption = 0;
				}

				buttonsPressed = 0;
				break;
				
			case SCREEN_LOAD_CONF_SETUP:
				if (opsConfig.dcMode)
				{
					screenState = SCREEN_MAIN_DRAW;
					break;
				}
				locoSlotOption = 0;
				screenState = SCREEN_LOAD_CONF_DRAW;
				break;

			case SCREEN_LOAD_CONF_DRAW:
				lcd_clrscr();
				drawSoftKeys_p((locoSlotOption>0)?PSTR(" UP "):PSTR(""),  (locoSlotOption < NUM_LOCO_OPTIONS-1)?PSTR("DOWN"):PSTR(""), PSTR("SLCT"), PSTR("CNCL"));
				{
					uint8_t i, baseOptionCount = (locoSlotOption / 3) * 3;
					for(i=0; i<3; i++)
					{
						if (i+baseOptionCount >= NUM_LOCO_OPTIONS-1)
							continue;
						if (i+baseOptionCount == locoSlotOption)
						{
							lcd_gotoxy(0, i);
							lcd_putc('>');
						}
						
						loadLocoConfiguration(i+baseOptionCount+1, &tmpLocoConfig);
						lcd_gotoxy(1, i);
						
						char currentConfigIndicator = (i+baseOptionCount+1 == opsConfig.activeLocoConfig)?'*':' ';
						
						// Get locomotive configuration details
						snprintf(screenLineBuffer, sizeof(screenLineBuffer), 
							tmpLocoConfig.shortDCCAddress?"%02d%cA:s%03d %03d %02d.%01d":"%02d%cA:%04d %03d %02d.%01d",
							i+baseOptionCount+1, currentConfigIndicator, tmpLocoConfig.address, tmpLocoConfig.maxSpeed, tmpLocoConfig.rampRate/10, tmpLocoConfig.rampRate%10);
						lcd_puts(screenLineBuffer);
					}
				}
				screenState = SCREEN_LOAD_CONF_IDLE;
				break;

			case SCREEN_LOAD_CONF_IDLE:
				// Switchy goodness
				if ((SOFTKEY_1 | SOFTKEY_1_LONG) & buttonsPressed)
				{
					if (locoSlotOption > 0)
						locoSlotOption--;
					screenState = SCREEN_LOAD_CONF_DRAW;
				}
				else if ((SOFTKEY_2 | SOFTKEY_2_LONG) & buttonsPressed)
				{
					if (locoSlotOption < NUM_LOCO_OPTIONS-1)
						locoSlotOption++;
					screenState = SCREEN_LOAD_CONF_DRAW;
				}
				else if (SOFTKEY_4 & buttonsPressed)
				{
					screenState = SCREEN_MAIN_DRAW;
				}
				else if (SOFTKEY_3 & buttonsPressed && (configurationOptions[configMenuOption].configScreen))
				{
					// Stop old locomotive in DCC mode
					if (!opsConfig.dcMode)
						dcc_reinit();
					opsConfig.activeLocoConfig = locoSlotOption+1;
					saveOpsConfiguration(&opsConfig);
					loadLocoConfiguration(opsConfig.activeLocoConfig, &currentLoco);
					if (opsConfig.startPaused)
						opsConfig.stopped = true;
					opState = STATE_LEARN; // New locomotive, no guarantee it moves the same direction
					screenState = SCREEN_MAIN_DRAW;
				}
				
				// Buttons handled, clear
				buttonsPressed = 0;
				break;


			case SCREEN_CONF_LOCOLIST_SETUP:
				locoSlotOption = 0;
				screenState = SCREEN_CONF_LOCOLIST_DRAW;
				break;
				
			case SCREEN_CONF_LOCOLIST_DRAW:
				lcd_clrscr();
				drawSoftKeys_p((locoSlotOption>0)?PSTR(" UP "):PSTR(""),  (locoSlotOption < NUM_LOCO_OPTIONS-1)?PSTR("DOWN"):PSTR(""), PSTR("SLCT"), PSTR("BACK"));
				{
					uint8_t i, baseOptionCount = (locoSlotOption / 3) * 3;
					for(i=0; i<3; i++)
					{
						if (i+baseOptionCount >= NUM_LOCO_OPTIONS)
							continue;
						if (i+baseOptionCount == locoSlotOption)
						{
							lcd_gotoxy(0, i);
							lcd_putc('>');
						}

						loadLocoConfiguration(i+baseOptionCount, &tmpLocoConfig);
						lcd_gotoxy(2, i);
						if (0 == i+baseOptionCount)
							snprintf(screenLineBuffer, sizeof(screenLineBuffer), "00 **DC** %03d %02d.%01d", tmpLocoConfig.maxSpeed, tmpLocoConfig.rampRate/10, tmpLocoConfig.rampRate%10);
						else
						{
							// Get locomotive configuration details
							snprintf(screenLineBuffer, sizeof(screenLineBuffer), 
								tmpLocoConfig.shortDCCAddress?"%02d A:s%03d %03d %02d.%01d":"%02d A:%04d %03d %02d.%01d", 
								i+baseOptionCount, tmpLocoConfig.address, tmpLocoConfig.maxSpeed, tmpLocoConfig.rampRate/10, tmpLocoConfig.rampRate%10);
						}
						lcd_puts(screenLineBuffer);
					}
				}
				screenState = SCREEN_CONF_LOCOLIST_IDLE;
				break;

			case SCREEN_CONF_LOCOLIST_IDLE:
				// Switchy goodness
				if (SOFTKEY_1 & buttonsPressed)
				{
					if (locoSlotOption > 0)
						locoSlotOption--;
					screenState = SCREEN_CONF_LOCOLIST_DRAW;
				}
				else if (SOFTKEY_2 & buttonsPressed)
				{
					if (locoSlotOption < NUM_LOCO_OPTIONS-1)
						locoSlotOption++;
					screenState = SCREEN_CONF_LOCOLIST_DRAW;
				}
				else if (SOFTKEY_4 & buttonsPressed)
				{
					screenState = SCREEN_CONF_MENU_DRAW;
				}
				else if (SOFTKEY_3 & buttonsPressed && (configurationOptions[configMenuOption].configScreen))
				{
					screenState = SCREEN_CONF_LOCOSLOT1_SETUP;
				}
				
				// Buttons handled, clear
				buttonsPressed = 0;
				break;


			case SCREEN_CONF_ACCLIST_SETUP:
				locoSlotOption = 0;
				screenState = SCREEN_CONF_ACCLIST_DRAW;
				break;


// mmmm = LS-RC
// mmmm = LC-RS
// mmmm = LSTOG
// mmmm = RSTOG


//  00000000001111111111
//  01234567890123456789
// [ 00 0000 LS-RC S [S]]
// [ 01 0001 LS-RC S [S]]
// [ 02 0002 LS-RC S [S]]
// [ +++  >>> NEXT CNCL ]



			case SCREEN_CONF_ACCLIST_DRAW:
				lcd_clrscr();
				drawSoftKeys_p((locoSlotOption>0)?PSTR(" UP "):PSTR(""),  (locoSlotOption < NUM_ACC_OPTIONS-1)?PSTR("DOWN"):PSTR(""), PSTR("SLCT"), PSTR("BACK"));
				{
					uint8_t i, baseOptionCount = (locoSlotOption / 3) * 3;
					for(i=0; i<3; i++)
					{
						uint8_t j = i+baseOptionCount;
						
						if (j >= NUM_ACC_OPTIONS)
							continue;
						if (j == locoSlotOption)
						{
							lcd_gotoxy(0, i);
							lcd_putc('>');
						} else {
							lcd_gotoxy(0, i);
							lcd_putc(' ');
						}
						
						// Get accessory configuration details
						snprintf(screenLineBuffer, sizeof(screenLineBuffer), 
							"%02d %04d %5.5s %c [%c]", 
							j, accConfig[j].address, getAccModeText(accConfig[j].trigMode), 
							accConfig[j].startState?'S':'C', accConfig[j].currentState?'S':'C');
						lcd_puts(screenLineBuffer);
					}
				}
				screenState = SCREEN_CONF_ACCLIST_IDLE;
				break;

			case SCREEN_CONF_ACCLIST_IDLE:
				// Switchy goodness
				if ((SOFTKEY_1_LONG | SOFTKEY_1) & buttonsPressed)
				{
					if (locoSlotOption > 0)
						locoSlotOption--;
					screenState = SCREEN_CONF_ACCLIST_DRAW;
				}
				else if ((SOFTKEY_2_LONG | SOFTKEY_2) & buttonsPressed)
				{
					if (locoSlotOption < NUM_ACC_OPTIONS-1)
						locoSlotOption++;
					screenState = SCREEN_CONF_ACCLIST_DRAW;
				}
				else if (SOFTKEY_4 & buttonsPressed)
				{
					screenState = SCREEN_CONF_MENU_DRAW;
				}
				else if (SOFTKEY_3 & buttonsPressed)
				{
					screenState = SCREEN_CONF_ACCCONF_SETUP;
				}
				
				// Buttons handled, clear
				buttonsPressed = 0;
				break;


//  00000000001111111111
//  01234567890123456789
// [ACC ADDR INIT TRIGR ]
// [ nn xxxx nnn  qqqqq ]
// [    ^               ]
// [ +++  >>> NEXT CNCL ]


			case SCREEN_CONF_ACCCONF_SETUP:
				lcd_clrscr();
				memcpy(&tmpAccConfig, &accConfig[locoSlotOption], sizeof(AccConfig));
				
				snprintf(screenLineBuffer, sizeof(screenLineBuffer), "ACC ADDR INIT TRIGR");
				lcd_puts(screenLineBuffer);

				configSaveU8 = 4;
				drawSoftKeys_p(PSTR(" ++ "), PSTR(" >> "), PSTR("SAVE"), PSTR("CNCL"));
				screenState = SCREEN_CONF_ACCCONF_DRAW;
				break;
				
			case SCREEN_CONF_ACCCONF_DRAW:
				lcd_gotoxy(0, 1);
				snprintf(screenLineBuffer, sizeof(screenLineBuffer), "%02d  %04d %3.3s  %5.5s", locoSlotOption, 
					tmpAccConfig.address, tmpAccConfig.startState?"SET":"CLR", getAccModeText(tmpAccConfig.trigMode));
				lcd_puts(screenLineBuffer);

				blankCursorLine();
				lcd_gotoxy(configSaveU8, 2);
				switch(configSaveU8)
				{
					case 4:
					case 5:
					case 6:
					case 7:
						lcd_putc('^');
						break;
					
					case 9:
						lcd_puts("^^^");
						break;
					case 14:
						lcd_puts("^^^^^");
						break;
				}
				screenState = SCREEN_CONF_ACCCONF_IDLE;
				break;

			case SCREEN_CONF_ACCCONF_IDLE:
				if ((SOFTKEY_1_LONG | SOFTKEY_1) & buttonsPressed)
				{
					switch(configSaveU8)
					{
						case 4:
						case 5: // 100s addr
						case 6: // 10s addr
						case 7: // 1s addr
							tmpAccConfig.address = deciIncrement(tmpAccConfig.address, 2044, 0, 7 - configSaveU8 );
							break;

						case 9:
							tmpAccConfig.startState = !tmpAccConfig.startState;
							break;

						case 14: // 10s rate
							tmpAccConfig.trigMode = (tmpAccConfig.trigMode+1) % ACC_MAX_OPS_MODES;
							break;

					}
					screenState = SCREEN_CONF_ACCCONF_DRAW;
				}
				else if ((SOFTKEY_2_LONG | SOFTKEY_2) & buttonsPressed)
				{
					switch(configSaveU8)
					{
						case 4:
						case 5:
						case 6:
							configSaveU8++;
							break;

						case 7:
							configSaveU8 = 9;
							break;
						
						case 9:
							configSaveU8 = 14;
							break;

						case 14:
							configSaveU8 = 4;
							break;

						default:
							configSaveU8 = 4;
							break;
					}
					screenState = SCREEN_CONF_ACCCONF_DRAW;
				}
				else if (SOFTKEY_3 & buttonsPressed)
				{
					// Save this accessory option
					saveAccConfiguration(locoSlotOption, &tmpAccConfig);
					loadAccConfiguration(locoSlotOption, &accConfig[locoSlotOption]);
					screenState = SCREEN_CONF_ACCLIST_DRAW;

				}
				else if (SOFTKEY_4 & buttonsPressed)
				{
					// Cancel
					lcd_clrscr();
					screenState = SCREEN_CONF_ACCLIST_DRAW;
				}

				// Buttons handled, clear
				buttonsPressed = 0;

				break;




//  Loco Configuration Screen 1
//  00000000001111111111
//  01234567890123456789
// [nn  ADDR  MAX  RAMP ]
// [    xxxx  nnn% yy.ys]
// [    ^               ]
// [ +++  >>> NEXT CNCL ]
// nn = locomotive slot number or DC (slot 0)
// xxxx = address (or *DC* for DC)
// nnn = max speed %
// yy.y = ramp time

			case SCREEN_CONF_LOCOSLOT1_SETUP:
				lcd_clrscr();
				loadLocoConfiguration(locoSlotOption, &tmpLocoConfig);
				snprintf(screenLineBuffer, sizeof(screenLineBuffer), "%02d  ADDR  MAX  RAMP", locoSlotOption);
				lcd_puts(screenLineBuffer);
				configSaveU8 = (0 == locoSlotOption)?10:4;
				lcd_gotoxy(configSaveU8, 2);
				lcd_putc('^');
				drawSoftKeys_p(PSTR(" ++ "), PSTR(" >> "), (0==locoSlotOption)?PSTR("SAVE"):PSTR("NEXT"), PSTR("CNCL"));
				screenState = SCREEN_CONF_LOCOSLOT1_DRAW;
				break;

			case SCREEN_CONF_LOCOSLOT1_DRAW:
				lcd_gotoxy(4, 1);
				if (0 == locoSlotOption)
				{
					// DC Slot
					snprintf(screenLineBuffer, sizeof(screenLineBuffer), 
						"-DC-  %03d  %02d.%01d", 
						tmpLocoConfig.maxSpeed, tmpLocoConfig.rampRate/10, tmpLocoConfig.rampRate%10);
				} else {
					snprintf(screenLineBuffer, sizeof(screenLineBuffer), 
						tmpLocoConfig.shortDCCAddress?"s%03d  %03d  %02d.%01d":"%04d  %03d  %02d.%01d", 
						tmpLocoConfig.address, tmpLocoConfig.maxSpeed, tmpLocoConfig.rampRate/10, tmpLocoConfig.rampRate%10);
				}
				lcd_puts(screenLineBuffer);
				blankCursorLine();
				lcd_gotoxy(configSaveU8, 2);
				lcd_putc('^');
				screenState = SCREEN_CONF_LOCOSLOT1_IDLE;
				break;

			case SCREEN_CONF_LOCOSLOT1_IDLE:
				if ((SOFTKEY_1_LONG | SOFTKEY_1) & buttonsPressed)
				{
					switch(configSaveU8)
					{
						case 4:
							// 1000x addr - 0-9 & s
							if (tmpLocoConfig.shortDCCAddress)
							{
								tmpLocoConfig.shortDCCAddress = false;
							} else {
								if ((9 == tmpLocoConfig.address / 1000) && (tmpLocoConfig.address % 1000 <= 127))
								{
									tmpLocoConfig.shortDCCAddress = true;
									tmpLocoConfig.address %= 1000;
									tmpLocoConfig.address = min(tmpLocoConfig.address, 127);
								} else {
									tmpLocoConfig.address = deciIncrement(tmpLocoConfig.address, 9999, 0, 3 );
								}
							}
							break;
						case 5: // 100s addr
						case 6: // 10s addr
						case 7: // 1s addr
							tmpLocoConfig.address = deciIncrement(tmpLocoConfig.address, (tmpLocoConfig.shortDCCAddress)?127:9999, 0, 7 - configSaveU8 );
							break;

						case 10:
						case 11:
						case 12:
							tmpLocoConfig.maxSpeed = deciIncrement(tmpLocoConfig.maxSpeed, 100, 1, 12 - configSaveU8 );
							break;

						case 15: // 10s rate
						case 16: // 1s rate
						case 18: // 0.1s rate
							tmpLocoConfig.rampRate = deciIncrement(tmpLocoConfig.rampRate, 255, 1, (18==configSaveU8)?0:(17 - configSaveU8) );
							break;

					}
					screenState = SCREEN_CONF_LOCOSLOT1_DRAW;
				}
				else if ((SOFTKEY_2_LONG | SOFTKEY_2) & buttonsPressed)
				{
					switch(configSaveU8)
					{
						case 4:
						case 5:
						case 6:
						case 10:
						case 11:
						case 15:
							configSaveU8++;
							break;

						case 7:
							configSaveU8 = 10; // Jump to first digit of max speed
							break;

						case 12:
							configSaveU8 = 15; // Jump to first digit of ramp
							break;


						case 16:
							configSaveU8 = 18; // Jump to decimal of ramp
							break;

						case 18:
							configSaveU8 = (0 == locoSlotOption)?10:4; // Jump to first digit of address
							break;

						default:
							//WTF?
							configSaveU8 = 4;
							break;
					}
					screenState = SCREEN_CONF_LOCOSLOT1_DRAW;
				}
				else if (SOFTKEY_3 & buttonsPressed)
				{
					// Next or save based on if it's the DC screen
					if (0 == locoSlotOption)
					{
						// DC mode, we're saving
						saveLocoConfiguration(0, &tmpLocoConfig);
						screenState = SCREEN_CONF_LOCOLIST_SETUP;
					} else {
						// DCC mode, on to the function screen
						screenState = SCREEN_CONF_LOCOSLOT2_SETUP;
					}
				}
				else if (SOFTKEY_4 & buttonsPressed)
				{
					// Cancel
					lcd_clrscr();
					screenState = SCREEN_CONF_MENU_DRAW;
				}

				// Buttons handled, clear
				buttonsPressed = 0;

				break;

//  Loco Configuration Screen 2
//  00000000001111111111
//  01234567890123456789
// [nn   FWD FWD REV REV]
// [ Fnn Fnn Fnn Fnn Fnn]
// [     ^              ]
// [ +++  >>> SAVE CNCL ]
// nn = locomotive slot number or DC (slot 0)
// xxxx = address (or *DC* for DC)
// nnn = max speed %
// yy.y = ramp time

			case SCREEN_CONF_LOCOSLOT2_SETUP:
				lcd_clrscr();
				snprintf(screenLineBuffer, sizeof(screenLineBuffer), "%02d   FWD FWD REV REV", locoSlotOption);
				lcd_puts(screenLineBuffer);
				configSaveU8 = 0;
				drawSoftKeys_p(PSTR(" ++ "), PSTR(" >> "), PSTR("NEXT"), PSTR("CNCL"));
				{
					uint8_t i;
					for(i=0; i<5; i++)
						configSaveFuncs[i] = 29; // Set all functions to 29 - which is unset

					for(i=0; i<=28; i++)
					{
						if (tmpLocoConfig.allFunctions & ((uint32_t)1UL<<i))
						{
							configSaveFuncs[0] = i;
							break;
						}
					}

					for(i=0; i<=28; i++)
					{
						if (tmpLocoConfig.fwdFunctions & ((uint32_t)1UL<<i))
						{
							configSaveFuncs[1] = i;
							break;
						}
					}
					for(i++; i<=28; i++)
					{
						if (tmpLocoConfig.fwdFunctions & ((uint32_t)1UL<<i))
						{
							configSaveFuncs[2] = i;
							break;
						}
					}
					
					for(i=0; i<=28; i++)
					{
						if (tmpLocoConfig.revFunctions & ((uint32_t)1UL<<i))
						{
							configSaveFuncs[3] = i;
							break;
						}
					}
					
					for(i++; i<=28; i++)
					{
						if (tmpLocoConfig.revFunctions & ((uint32_t)1UL<<i))
						{
							configSaveFuncs[4] = i;
							break;
						}
					}
				}
				screenState = SCREEN_CONF_LOCOSLOT2_DRAW;
				
				break;

			case SCREEN_CONF_LOCOSLOT2_DRAW:
				blankCursorLine();
				for(uint8_t i=0; i<5; i++)
				{
					if (configSaveFuncs[i] >= 29)
						strncpy(screenLineBuffer, "F--", sizeof(screenLineBuffer));
					else
						snprintf(screenLineBuffer, sizeof(screenLineBuffer), "F%02d", configSaveFuncs[i]);
					switch(i)
					{
						case 0:
							lcd_gotoxy(1, 1);
							lcd_puts(screenLineBuffer);
							if (configSaveU8 == i)
							{
								lcd_gotoxy(2, 2);
								lcd_puts("^^");
							}
							break;

						case 1:
							lcd_gotoxy(5, 1);
							lcd_puts(screenLineBuffer);
							if (configSaveU8 == i)
							{
								lcd_gotoxy(6, 2);
								lcd_puts("^^");
							}
							break;

						case 2:
							lcd_gotoxy(9, 1);
							lcd_puts(screenLineBuffer);
							if (configSaveU8 == i)
							{
								lcd_gotoxy(10, 2);
								lcd_puts("^^");
							}
							break;

						case 3:
							lcd_gotoxy(13, 1);
							lcd_puts(screenLineBuffer);
							if (configSaveU8 == i)
							{
								lcd_gotoxy(14, 2);
								lcd_puts("^^");
							}
							break;

						case 4:
							lcd_gotoxy(17, 1);
							lcd_puts(screenLineBuffer);
							if (configSaveU8 == i)
							{
								lcd_gotoxy(18, 2);
								lcd_puts("^^");
							}
							break;
					}
				}
				screenState = SCREEN_CONF_LOCOSLOT2_IDLE;
				break;

			case SCREEN_CONF_LOCOSLOT2_IDLE:
				if ((SOFTKEY_1 | SOFTKEY_1_LONG) & buttonsPressed)
				{
					configSaveFuncs[configSaveU8] = (configSaveFuncs[configSaveU8] + 1) % 30;
					screenState = SCREEN_CONF_LOCOSLOT2_DRAW;
				}
				else if (SOFTKEY_2 & buttonsPressed)
				{
					configSaveU8++;
					if (configSaveU8 > 5)
						configSaveU8 = 0;
					screenState = SCREEN_CONF_LOCOSLOT2_DRAW;
				}
				else if (SOFTKEY_3 & buttonsPressed)
				{
					// Put the functions back in their bitmasks
					tmpLocoConfig.allFunctions = ((uint32_t)1UL<<configSaveFuncs[0]);
					tmpLocoConfig.fwdFunctions = ((uint32_t)1UL<<configSaveFuncs[1]) | ((uint32_t)1UL<<configSaveFuncs[2]);
					tmpLocoConfig.revFunctions = ((uint32_t)1UL<<configSaveFuncs[3]) | ((uint32_t)1UL<<configSaveFuncs[4]);
					screenState = SCREEN_CONF_LOCOSLOT3_SETUP;
				}
				else if (SOFTKEY_4 & buttonsPressed)
				{
					// Cancel
					lcd_clrscr();
					screenState = SCREEN_CONF_MENU_DRAW;
				}

				// Buttons handled, clear
				buttonsPressed = 0;

				break;


//  Loco Configuration Screen 3
//  00000000001111111111
//  01234567890123456789
// [nn   ACC BRK        ]
// [     Fnn Fnn        ]
// [     ^              ]
// [ +++  >>> SAVE CNCL ]
// nn = locomotive slot number or DC (slot 0)

			case SCREEN_CONF_LOCOSLOT3_SETUP:
				lcd_clrscr();
				snprintf(screenLineBuffer, sizeof(screenLineBuffer), "%02d   ACC BRK        ", locoSlotOption);
				lcd_puts(screenLineBuffer);
				configSaveU8 = 0;
				drawSoftKeys_p(PSTR(" ++ "), PSTR(" >> "), PSTR("SAVE"), PSTR("CNCL"));
				{
					uint8_t i;
					for(i=0; i<5; i++)
						configSaveFuncs[i] = 29; // Set all functions to 29 - which is unset

					for(i=0; i<=28; i++)
					{
						if (tmpLocoConfig.accFunctions & ((uint32_t)1UL<<i))
						{
							configSaveFuncs[0] = i;
							break;
						}
					}
					for(i=0; i<=28; i++)
					{
						if (tmpLocoConfig.decFunctions & ((uint32_t)1UL<<i))
						{
							configSaveFuncs[1] = i;
							break;
						}
					}
					
				}
				screenState = SCREEN_CONF_LOCOSLOT3_DRAW;
				
				break;

			case SCREEN_CONF_LOCOSLOT3_DRAW:
				blankCursorLine();
				for(uint8_t i=0; i<2; i++)
				{
					if (configSaveFuncs[i] >= 29)
						strncpy(screenLineBuffer, "F--", sizeof(screenLineBuffer));
					else
						snprintf(screenLineBuffer, sizeof(screenLineBuffer), "F%02d", configSaveFuncs[i]);
					switch(i)
					{
						case 0:
							lcd_gotoxy(5, 1);
							lcd_puts(screenLineBuffer);
							if (configSaveU8 == i)
							{
								lcd_gotoxy(6, 2);
								lcd_puts("^^");
							}
							break;

						case 1:
							lcd_gotoxy(9, 1);
							lcd_puts(screenLineBuffer);
							if (configSaveU8 == i)
							{
								lcd_gotoxy(10, 2);
								lcd_puts("^^");
							}
							break;
					}
				}
				screenState = SCREEN_CONF_LOCOSLOT3_IDLE;
				break;

			case SCREEN_CONF_LOCOSLOT3_IDLE:
				if ((SOFTKEY_1 | SOFTKEY_1_LONG) & buttonsPressed)
				{
					configSaveFuncs[configSaveU8] = (configSaveFuncs[configSaveU8] + 1) % 30;
					screenState = SCREEN_CONF_LOCOSLOT3_DRAW;
				}
				else if (SOFTKEY_2 & buttonsPressed)
				{
					configSaveU8++;
					if (configSaveU8 > 1)
						configSaveU8 = 0;
					screenState = SCREEN_CONF_LOCOSLOT3_DRAW;
				}
				else if (SOFTKEY_3 & buttonsPressed)
				{
					// Put the functions back in their bitmasks
					tmpLocoConfig.accFunctions = ((uint32_t)1UL<<configSaveFuncs[0]);
					tmpLocoConfig.decFunctions = ((uint32_t)1UL<<configSaveFuncs[1]);
					saveLocoConfiguration(locoSlotOption, &tmpLocoConfig);

					if (locoSlotOption == opsConfig.activeLocoConfig)
					{
						loadLocoConfiguration(opsConfig.activeLocoConfig, &currentLoco);
					}
					screenState = SCREEN_CONF_LOCOLIST_SETUP;
				}
				else if (SOFTKEY_4 & buttonsPressed)
				{
					// Cancel
					lcd_clrscr();
					screenState = SCREEN_CONF_MENU_DRAW;
				}

				// Buttons handled, clear
				buttonsPressed = 0;

				break;




//  Backlight Timeout Configuration
//  00000000001111111111
//  01234567890123456789
// [Backlight Timeout   ]
// [ Seconds: yyys      ]
// [          ^         ]
// [ +++  >>> SAVE CNCL ]
// nnn = max speed %
// yy.y = ramp time

			case SCREEN_CONF_BACKLITE_SETUP:
				lcd_clrscr();
				lcd_puts_p(PSTR("Backlight Timeout"));
				lcd_gotoxy(1, 1);
				lcd_puts_p(PSTR("Seconds: "));
				lcd_gotoxy(10, 2);
				lcd_puts("^^^^");
				configSaveU8_2 = (opsConfig.backlightTimeout / 10) * 10;

				drawSoftKeys_p(PSTR(" ++ "), PSTR(" -- "), PSTR("SAVE"), PSTR("CNCL"));
				screenState = SCREEN_CONF_BACKLITE_DRAW;
				break;

			case SCREEN_CONF_BACKLITE_DRAW:
				lcd_gotoxy(10,1);
				if (0 == configSaveU8_2)
					snprintf(screenLineBuffer, sizeof(screenLineBuffer), "None");
				else
					snprintf(screenLineBuffer, sizeof(screenLineBuffer), "%03ds", configSaveU8_2);
				lcd_puts(screenLineBuffer);
				screenState = SCREEN_CONF_BACKLITE_IDLE;
				break;

			case SCREEN_CONF_BACKLITE_IDLE:
				if ((SOFTKEY_1 | SOFTKEY_1_LONG) & buttonsPressed)
				{
					if (configSaveU8_2 < 250)
						configSaveU8_2 += 10;
					screenState = SCREEN_CONF_BACKLITE_DRAW;
				}
				else if ((SOFTKEY_2 | SOFTKEY_2_LONG) & buttonsPressed)
				{
					if (configSaveU8_2 > 0)
						configSaveU8_2 -= 10;
					screenState = SCREEN_CONF_BACKLITE_DRAW;
				}
				else if (SOFTKEY_3 & buttonsPressed)
				{
					// Put the functions back in their bitmasks
					opsConfig.backlightTimeout = configSaveU8_2;
					forceBacklightOff = false;
					backlightDelay = opsConfig.backlightTimeout * 10;
					saveOpsConfiguration(&opsConfig);
					screenState = SCREEN_CONF_MENU_DRAW;
				}
				else if (SOFTKEY_4 & buttonsPressed)
				{
					// Cancel
					lcd_clrscr();
					screenState = SCREEN_CONF_MENU_DRAW;
				}

				// Buttons handled, clear
				buttonsPressed = 0;
				break;

			case SCREEN_CONF_BACKLITE_OFF:
				buttonsPressed = 0;
				// Turn backlight off
				forceBacklightOff = true;
				// Go back to main screen
				screenState = SCREEN_MAIN_DRAW;
				break;

//  Loco Configuration Screen 2
//  00000000001111111111
//  01234567890123456789
// [ENDPOINT DELAY      ]
// [ Seconds: yy.ys     ]
// [          ^         ]
// [ +++  >>> SAVE CNCL ]
// nn = locomotive slot number or DC (slot 0)
// xxxx = address (or *DC* for DC)
// nnn = max speed %
// yy.y = ramp time

			case SCREEN_CONF_DELAY_SETUP:
				lcd_clrscr();
				lcd_puts_p(PSTR("Endpoint Delay"));
				lcd_gotoxy(1, 1);
				lcd_puts_p(PSTR("Seconds: "));
				configSaveU8 = 10;
				configSaveU8_2 = opsConfig.endpointDelay;
				drawSoftKeys_p(PSTR(" ++ "), PSTR(" >> "), PSTR("SAVE"), PSTR("CNCL"));
				screenState = SCREEN_CONF_DELAY_DRAW;
				break;

			case SCREEN_CONF_DELAY_DRAW:
				blankCursorLine();
				lcd_gotoxy(10,1);
				snprintf(screenLineBuffer, sizeof(screenLineBuffer), "%03ds", configSaveU8_2);
				lcd_puts(screenLineBuffer);
				lcd_gotoxy(configSaveU8, 2);
				lcd_putc('^');
				screenState = SCREEN_CONF_DELAY_IDLE;
				break;

			case SCREEN_CONF_DELAY_IDLE:
				if ((SOFTKEY_1 | SOFTKEY_1_LONG) & buttonsPressed)
				{
					switch(configSaveU8)
					{
						case 10:
						case 11:
						case 12:
							configSaveU8_2 = deciIncrement(configSaveU8_2, 255, 0, 12 - configSaveU8);
							break;

						default:
							configSaveU8 = 10;
							break;
					}
					screenState = SCREEN_CONF_DELAY_DRAW;
				}
				else if ((SOFTKEY_2 | SOFTKEY_2_LONG) & buttonsPressed)
				{
					switch(configSaveU8)
					{
						case 10:
						case 11:
							configSaveU8++;
							break;
						case 12:
							configSaveU8 = 10;
							break;

						default:
							configSaveU8 = 10;
							break;
					}
					screenState = SCREEN_CONF_DELAY_DRAW;
				}
				else if (SOFTKEY_3 & buttonsPressed)
				{
					// Put the functions back in their bitmasks
					opsConfig.endpointDelay = configSaveU8_2;
					saveOpsConfiguration(&opsConfig);
					screenState = SCREEN_CONF_MENU_DRAW;
				}
				else if (SOFTKEY_4 & buttonsPressed)
				{
					// Cancel
					lcd_clrscr();
					screenState = SCREEN_CONF_MENU_DRAW;
				}

				// Buttons handled, clear
				buttonsPressed = 0;
				break;


			case SCREEN_CONF_MIDDELAY_SETUP:
				lcd_clrscr();
				lcd_puts_p(PSTR("Midpoint Delay"));
				lcd_gotoxy(1, 1);
				lcd_puts_p(PSTR("Seconds: "));
				configSaveU8 = 10;
				configSaveU8_2 = opsConfig.midpointDelay;
				drawSoftKeys_p(PSTR(" ++ "), PSTR(" >> "), PSTR("SAVE"), PSTR("CNCL"));
				screenState = SCREEN_CONF_MIDDELAY_DRAW;
				break;

			case SCREEN_CONF_MIDDELAY_DRAW:
				blankCursorLine();
				lcd_gotoxy(10,1);
				snprintf(screenLineBuffer, sizeof(screenLineBuffer), "%03ds", configSaveU8_2);
				lcd_puts(screenLineBuffer);
				lcd_gotoxy(configSaveU8, 2);
				lcd_putc('^');
				screenState = SCREEN_CONF_MIDDELAY_IDLE;
				break;

			case SCREEN_CONF_MIDDELAY_IDLE:
				if ((SOFTKEY_1 | SOFTKEY_1_LONG) & buttonsPressed)
				{
					switch(configSaveU8)
					{
						case 10:
						case 11:
						case 12:
							configSaveU8_2 = deciIncrement(configSaveU8_2, 255, 0, 12 - configSaveU8);
							break;

						default:
							configSaveU8 = 10;
							break;
					}
					screenState = SCREEN_CONF_MIDDELAY_DRAW;
				}
				else if ((SOFTKEY_2 | SOFTKEY_2_LONG) & buttonsPressed)
				{
					switch(configSaveU8)
					{
						case 10:
						case 11:
							configSaveU8++;
							break;
						case 12:
							configSaveU8 = 10;
							break;

						default:
							configSaveU8 = 10;
							break;
					}
					screenState = SCREEN_CONF_MIDDELAY_DRAW;
				}
				else if (SOFTKEY_3 & buttonsPressed)
				{
					// Put the functions back in their bitmasks
					opsConfig.midpointDelay = configSaveU8_2;
					saveOpsConfiguration(&opsConfig);
					screenState = SCREEN_CONF_MENU_DRAW;
				}
				else if (SOFTKEY_4 & buttonsPressed)
				{
					// Cancel
					lcd_clrscr();
					screenState = SCREEN_CONF_MENU_DRAW;
				}

				// Buttons handled, clear
				buttonsPressed = 0;
				break;


			case SCREEN_CONF_MENU_DRAW:
				lcd_clrscr();
				drawSoftKeys_p((configMenuOption>0)?PSTR(" UP "):PSTR(""),  (configMenuOption < NUM_CONF_OPTIONS-1)?PSTR("DOWN"):PSTR(""), PSTR("SLCT"), PSTR("BACK"));

				{
					uint8_t i, baseOptionCount = (configMenuOption / 3) * 3;
					for(i=0; i<3; i++)
					{
						if (i+baseOptionCount >= NUM_CONF_OPTIONS)
							continue;
						if (i+baseOptionCount == configMenuOption)
						{
							lcd_gotoxy(0, i);
							lcd_putc('>');
						}

						lcd_gotoxy(2, i);
						lcd_puts(configurationOptions[i+baseOptionCount].configName);
					}
				}

				screenState = SCREEN_CONF_MENU_IDLE;
				break;
				
			case SCREEN_CONF_MENU_IDLE:
				// Switchy goodness
				if ((SOFTKEY_1_LONG | SOFTKEY_1) & buttonsPressed)
				{
					if (configMenuOption > 0)
						configMenuOption--;
					screenState = SCREEN_CONF_MENU_DRAW;
				}
				else if ((SOFTKEY_2_LONG | SOFTKEY_2) & buttonsPressed)
				{
					if (configMenuOption < NUM_CONF_OPTIONS-1)
						configMenuOption++;
					screenState = SCREEN_CONF_MENU_DRAW;
				}
				else if (SOFTKEY_4 & buttonsPressed)
				{
					lcd_clrscr();
					screenState = SCREEN_MAIN_DRAW;
				}
				else if (SOFTKEY_3 & buttonsPressed && (configurationOptions[configMenuOption].configScreen))
				{
					screenState = configurationOptions[configMenuOption].configScreen;
					lcd_clrscr();
				}
				
				// Buttons handled, clear
				buttonsPressed = 0;
				break;

			case SCREEN_CONF_INTSENSE_SETUP:
				lcd_clrscr();
				configSaveU8 = (opsConfig.intStopsEnable)?1:0;
				lcd_gotoxy(0,0);
				lcd_puts("Midpoint Stops");
				drawSoftKeys_p(PSTR("ENBL"),  PSTR("DSBL"), PSTR("SAVE"), PSTR("CNCL"));
				// Intentional fall-through

			case SCREEN_CONF_INTSENSE_DRAW:
				lcd_gotoxy(0,1);
				lcd_puts_p(PSTR("[ ] Enable"));
				lcd_gotoxy(0,2);
				lcd_puts_p(PSTR("[ ] Disable"));
				lcd_gotoxy(1, (configSaveU8)?1:2);
				lcd_putc('*');
				screenState = SCREEN_CONF_INTSENSE_IDLE;
				break;

			case SCREEN_CONF_INTSENSE_IDLE:
				if (SOFTKEY_1 & buttonsPressed)
				{
					configSaveU8 = 1;
					screenState = SCREEN_CONF_INTSENSE_DRAW;
				}
				else if (SOFTKEY_2 & buttonsPressed)
				{
					configSaveU8 = 0;
					screenState = SCREEN_CONF_INTSENSE_DRAW;
				}
				else if ((SOFTKEY_3 | SOFTKEY_4) & buttonsPressed)
				{
					if (SOFTKEY_3 & buttonsPressed && (opsConfig.intStopsEnable != (bool)configSaveU8))
					{
						opsConfig.intStopsEnable = (bool)configSaveU8;
						saveOpsConfiguration(&opsConfig);
					}
					lcd_clrscr();
					screenState = SCREEN_CONF_MENU_DRAW;
				}
				// Buttons handled, clear
				buttonsPressed = 0;	
				break;



			case SCREEN_CONF_OUTPUT_SETUP:
				lcd_clrscr();
				configSaveU8 = (opsConfig.dcMode)?1:0;
				lcd_gotoxy(0,0);
				lcd_puts("DC / DCC Mode");
				drawSoftKeys_p(PSTR("DCC"),  PSTR(" DC"), PSTR("SAVE"), PSTR("CNCL"));
				// Intentional fall-through

			case SCREEN_CONF_OUTPUT_DRAW:
				lcd_gotoxy(0,1);
				lcd_puts_p(PSTR("[ ] DCC Trk Output"));
				lcd_gotoxy(0,2);
				lcd_puts_p(PSTR("[ ] DC Trk Output"));
				lcd_gotoxy(1, (configSaveU8)?2:1);
				lcd_putc('*');
				screenState = SCREEN_CONF_OUTPUT_IDLE;
				break;

			case SCREEN_CONF_OUTPUT_IDLE:
				if (SOFTKEY_1 & buttonsPressed)
				{
					configSaveU8 = 0;
					screenState = SCREEN_CONF_OUTPUT_DRAW;
				}
				else if (SOFTKEY_2 & buttonsPressed)
				{
					configSaveU8 = 1;
					screenState = SCREEN_CONF_OUTPUT_DRAW;
				}
				else if ((SOFTKEY_3 | SOFTKEY_4) & buttonsPressed)
				{
					if (SOFTKEY_3 & buttonsPressed && (opsConfig.dcMode != (bool)configSaveU8))
					{
						opsConfig.dcMode = (bool)configSaveU8;
						if(opsConfig.dcMode)
						{
							dc_init();
						} else {
							dcc_init();
							for(uint8_t r = 0; r<NUM_ACC_OPTIONS; r++)
							{
								if(0 != accConfig[r].address && ACC_DISBL != accConfig[r].trigMode)
									accPktQueuePush(accConfig[r].address, accConfig[r].startState);
							}
						}
						saveOpsConfiguration(&opsConfig);
					}
					lcd_clrscr();
					screenState = SCREEN_CONF_MENU_DRAW;
				}
				// Buttons handled, clear
				buttonsPressed = 0;	
				break;

//  Loco Configuration Screen 2
//  00000000001111111111
//  01234567890123456789
// [Start Locomotive:   ]
// [[ ] Running         ]
// [[ ] Paused          ]
// [ RUN  PAUS SAVE CNCL]

			case SCREEN_CONF_PAUSED_SETUP:
				lcd_clrscr();
				configSaveU8 = (opsConfig.startPaused)?1:0;
				lcd_gotoxy(0,0);
				lcd_puts_p(PSTR("Start Locomotive:"));
				drawSoftKeys_p(PSTR("RUN"),  PSTR("PAUS"), PSTR("SAVE"), PSTR("CNCL"));
				// Intentional fall-through

			case SCREEN_CONF_PAUSED_DRAW:
				lcd_gotoxy(0,1);
				lcd_puts_p(PSTR("[ ] Running"));
				lcd_gotoxy(0,2);
				lcd_puts_p(PSTR("[ ] Paused"));
				lcd_gotoxy(1, (configSaveU8)?2:1);
				lcd_putc('*');
				screenState = SCREEN_CONF_PAUSED_IDLE;
				break;

			case SCREEN_CONF_PAUSED_IDLE:
				if (SOFTKEY_1 & buttonsPressed)
				{
					configSaveU8 = 0;
					screenState = SCREEN_CONF_PAUSED_DRAW;
				}
				else if (SOFTKEY_2 & buttonsPressed)
				{
					configSaveU8 = 1;
					screenState = SCREEN_CONF_PAUSED_DRAW;
				}
				else if ((SOFTKEY_3 | SOFTKEY_4) & buttonsPressed)
				{
					if (SOFTKEY_3 & buttonsPressed && (opsConfig.startPaused != (bool)configSaveU8))
					{
						opsConfig.startPaused = (bool)configSaveU8;
						saveOpsConfiguration(&opsConfig);
					}
					lcd_clrscr();
					screenState = SCREEN_CONF_MENU_DRAW;
				}
				// Buttons handled, clear
				buttonsPressed = 0;	
				break;

//  00000000001111111111
//  01234567890123456789
// [Stop Relearns Dir:  ]
// [[ ] Yes             ]
// [[ ] No              ]
// [ YES  NO  SAVE CNCL ]

			case SCREEN_CONF_RELEARN_SETUP:
				lcd_clrscr();
				configSaveU8 = (opsConfig.stopRetriggersLearnMode)?1:0;
				lcd_gotoxy(0,0);
				lcd_puts_p(PSTR("Stop Relearns Dir:"));
				drawSoftKeys_p(PSTR("YES"),  PSTR(" NO "), PSTR("SAVE"), PSTR("CNCL"));
				// Intentional fall-through

			case SCREEN_CONF_RELEARN_DRAW:
				lcd_gotoxy(0,1);
				lcd_puts_p(PSTR("[ ] Yes"));
				lcd_gotoxy(0,2);
				lcd_puts_p(PSTR("[ ] No"));
				lcd_gotoxy(1, (configSaveU8)?1:2);
				lcd_putc('*');
				screenState = SCREEN_CONF_RELEARN_IDLE;
				break;

			case SCREEN_CONF_RELEARN_IDLE:
				if (SOFTKEY_1 & buttonsPressed)
				{
					configSaveU8 = 1;
					screenState = SCREEN_CONF_RELEARN_DRAW;
				}
				else if (SOFTKEY_2 & buttonsPressed)
				{
					configSaveU8 = 0;
					screenState = SCREEN_CONF_RELEARN_DRAW;
				}
				else if ((SOFTKEY_3 | SOFTKEY_4) & buttonsPressed)
				{
					if (SOFTKEY_3 & buttonsPressed && (opsConfig.startPaused != (bool)configSaveU8))
					{
						opsConfig.stopRetriggersLearnMode = (bool)configSaveU8;
						saveOpsConfiguration(&opsConfig);
					}
					lcd_clrscr();
					screenState = SCREEN_CONF_MENU_DRAW;
				}
				// Buttons handled, clear
				buttonsPressed = 0;	
				break;



//  Loco Configuration Screen 2
//  00000000001111111111
//  01234567890123456789
// [Manual Adjustment   ]
// [ Run Speed: F%03d   ]
// [                    ]
// [ SPD+ SPD- F<>R CNCL]



			case SCREEN_CONF_MANUAL_SETUP:
				lcd_clrscr();
				lcd_gotoxy(0,0);
				lcd_puts_p(PSTR("Manual Adjustment"));
				lcd_gotoxy(1,1);
				lcd_puts_p(PSTR("Run Speed:"));
				screenState = SCREEN_CONF_MANUAL_DRAW;
				break;

			case SCREEN_CONF_MANUAL_DRAW:
				drawSoftKeys_p((currentLoco.maxSpeed < 100)?PSTR("SPD+"):PSTR(""), (currentLoco.maxSpeed > 0)?PSTR("SPD-"):PSTR(""), PSTR("F<>R"), PSTR("BACK"));
				screenState = SCREEN_CONF_MANUAL_IDLE;
				break;

			case SCREEN_CONF_MANUAL_IDLE:
				snprintf(screenLineBuffer, sizeof(screenLineBuffer), "%c%03d%%", opsConfig.requestedSpeed<0?'R':'F', currentLoco.maxSpeed);
				lcd_gotoxy(12, 1);
				lcd_puts(screenLineBuffer);

/*				snprintf(screenLineBuffer, sizeof(screenLineBuffer), "%05d %05d %03d", opsConfig.requestedSpeed, opsConfig.speed, currentLoco.maxSpeed);
				lcd_gotoxy(0, 2);
				lcd_puts(screenLineBuffer);*/

				if ((SOFTKEY_1 | SOFTKEY_1_LONG) & buttonsPressed)
				{
					if (currentLoco.maxSpeed < 100)
						currentLoco.maxSpeed++;
					screenState = SCREEN_CONF_MANUAL_DRAW;
				}
				else if ((SOFTKEY_2 | SOFTKEY_2_LONG) & buttonsPressed)
				{
					if (currentLoco.maxSpeed > 0)
						currentLoco.maxSpeed--;
					screenState = SCREEN_CONF_MANUAL_DRAW;
				}
				else if (SOFTKEY_3 & buttonsPressed)
				{
					if (opsConfig.requestedSpeed > 0)
						opState = STATE_FWDDECEL;
					else
						opState = STATE_REVDECEL;
					screenState = SCREEN_CONF_MANUAL_DRAW;
				}
				else if (SOFTKEY_4 & buttonsPressed)
				{
					lcd_clrscr();
					screenState = SCREEN_MAIN_DRAW;
				}
				// Buttons handled, clear
				buttonsPressed = 0;
				break;

			case SCREEN_CONF_RESET_SETUP:
				lcd_clrscr();
				configSaveU8 = 5;
				screenState = SCREEN_CONF_RESET_DRAW;
				break;


//  Factory Reset Screen
//  00000000001111111111
//  01234567890123456789
// [CLEAR ALL SETTINGS? ]
// [ Press YES n more   ]
// [ times to confirm   ]
// [ YES! YES!     CNCL ]
			case SCREEN_CONF_RESET_DRAW:
				lcd_gotoxy(0,0);
				lcd_puts_p(PSTR("CLEAR ALL SETTINGS?"));

				if (configSaveU8 > 0)
				{
					lcd_gotoxy(1,1);
					lcd_puts_p(PSTR("Press YES n more"));
					lcd_gotoxy(1,2);
					lcd_puts_p(PSTR("times to confirm"));
					lcd_gotoxy(11,1);
					lcd_putc(configSaveU8 + '0');
					drawSoftKeys_p(PSTR("YES!"), PSTR(""), PSTR(""), PSTR("CNCL"));
				} else { 
					lcd_gotoxy(0,1);
					lcd_puts_p(PSTR("    REALLY ERASE    "));
					lcd_gotoxy(0,2);
					lcd_puts_p(PSTR("    EVERYTHING?     "));
					drawSoftKeys_p(PSTR(""), PSTR("YES!"), PSTR(""), PSTR("CNCL"));
				}
				screenState = SCREEN_CONF_RESET_IDLE;
				// Buttons handled, clear
				buttonsPressed = 0;	
				break;

			case SCREEN_CONF_RESET_IDLE:
				if (SOFTKEY_1 & buttonsPressed)
				{
					if (configSaveU8 > 0)
						configSaveU8--;
					screenState = SCREEN_CONF_RESET_DRAW;
				}
				else if (SOFTKEY_2 & buttonsPressed)
				{
					if (configSaveU8 == 0)
					{
						lcd_clrscr();
						lcd_gotoxy(0,0);
						lcd_puts_p(PSTR("RESETTING..."));
						lcd_gotoxy(0,1);
						lcd_puts_p(PSTR("EEPROM... "));
						firstTimeInitConfig();
						lcd_puts_p(PSTR("done"));
						lcd_gotoxy(0,2);
						lcd_puts_p(PSTR("Reboot"));
						while(1); // Just stall and wait for a WDT reset
					}
				}
				else if (SOFTKEY_4 & buttonsPressed)
				{
					lcd_clrscr();
					screenState = SCREEN_CONF_MENU_DRAW;
				}
				// Buttons handled, clear
				buttonsPressed = 0;	
				break;

//  Diagnostic Screen
//  00000000001111111111
//  01234567890123456789
// [V:vv.vV FDC 00000l/s]
// [A:vv.v B:vv.v I:a.aa]
// [XXXXXX vx.y LR IR IL]
// [PHSA PHSB      BACK ]
// F:n - n=Y/N for faulted

			case SCREEN_CONF_DIAG_SETUP:
				lcd_clrscr();
				drawSoftKeys_p(PSTR(""), PSTR(""), PSTR(""), PSTR("BACK"));
				screenState = SCREEN_CONF_DIAG_DRAW;
				break;
				
			case SCREEN_CONF_DIAG_DRAW:
				configSaveU8 = decisecs;
				{
					const char* outMode = "DCC";
				
					if (opsConfig.dcMode)
						outMode = "*DC";
					if (trackStatus & TRACK_STATUS_FAULTED)
						outMode = "FLT";
					lcd_gotoxy(0,0);
					snprintf(screenLineBuffer, sizeof(screenLineBuffer), "V:%02d.%01dV %s %05lul/s", inputVoltage/10, inputVoltage%10, outMode, kloopsPerSec);
					lcd_puts(screenLineBuffer);

					lcd_gotoxy(0,1);
					snprintf(screenLineBuffer, sizeof(screenLineBuffer), "A:%02d.%01d B:%02d.%01d I:%01d.%02d", 
						phaseAVoltage/10, phaseAVoltage%10, phaseBVoltage/10, phaseBVoltage%10, trackCurrent/100, trackCurrent%100);
					lcd_puts(screenLineBuffer);

					lcd_gotoxy(0,2);
					snprintf(screenLineBuffer, sizeof(screenLineBuffer), "%06lX v%d.%d %c%c %s %s", GIT_REV, SWREV_MAJOR, SWREV_MINOR, 
						(trackStatus & TRACK_STATUS_SENSOR_LEFT)?'L':'-', (trackStatus & TRACK_STATUS_SENSOR_RIGHT)?'R':'-', 
						(trackStatus & TRACK_STATUS_SENSOR_INT_LEFT)?"IL":"--", (trackStatus & TRACK_STATUS_SENSOR_INT_RIGHT)?"IR":"--");

					lcd_puts(screenLineBuffer);
				}
				screenState = SCREEN_CONF_DIAG_IDLE;
				break;
				
			case SCREEN_CONF_DIAG_IDLE:
				if (SOFTKEY_4 & buttonsPressed)
				{
					lcd_clrscr();
					screenState = SCREEN_CONF_MENU_DRAW;
				} else if (configSaveU8 != decisecs)
					screenState = SCREEN_CONF_DIAG_DRAW;
				buttonsPressed = 0;
				break;


//  Error Screen
//  00000000001111111111
//  01234567890123456789
// [Oh No!              ]
// [   Unable to draw   ]
// [    screen %03d     ]
// [   PRESS ANY KEY    ]

			default:
				lcd_gotoxy(0,0);
				lcd_puts_p(PSTR("OH NO!  ERROR!"));
				lcd_gotoxy(3,1);
				lcd_puts_p(PSTR("Unable to draw"));
				snprintf(screenLineBuffer, sizeof(screenLineBuffer), "screen %03d", screenState);
				lcd_gotoxy(3,2);
				lcd_puts(screenLineBuffer);
				lcd_gotoxy(3,3);
				lcd_puts_p(PSTR("PRESS ANY KEY"));
				if ((SOFTKEY_1 | SOFTKEY_2 | SOFTKEY_3 | SOFTKEY_4) & buttonsPressed)
				{
					lcd_clrscr();
					screenState = SCREEN_MAIN_DRAW;
				}
				buttonsPressed = 0;
				break;
		}

		if (screenUpdateDecisecs >= 10)
		{
			switch(screenState)
			{
				case SCREEN_MAIN_DRAW:
				default:
					break;
			}
			
			screenUpdateDecisecs -= 10;
			kloopsPerSec = loopCount;
			loopCount = 0;
		}
	}
}
