IowaScaledEngineering/ckt-pingpong/src/userconfig.h

#ifndef _USERCONFIG_H_
#define _USERCONFIG_H_

#define NUM_LOCO_OPTIONS 15
#define NUM_ACC_OPTIONS  6

typedef struct
{
	uint16_t address;
	bool shortDCCAddress;
	uint8_t maxSpeed;
	uint8_t rampRate;
	uint32_t fwdFunctions;
	uint32_t revFunctions;
	uint32_t accFunctions;
	uint32_t decFunctions;
	uint32_t allFunctions;
} LocoConfig;

typedef enum
{
	ACC_DISBL = 0,
	ACC_LS_RC,
	ACC_LC_RS,
	ACC_LSTOG,
	ACC_RSTOG,
	ACC_XSTOG,
	ACC_INIT,
	ACC_LE_ST,
	ACC_RE_ST,
	ACC_XE_ST,
	ACC_LI_ST,
	ACC_RI_ST,
	ACC_XI_ST,
	ACC_MAX_OPS_MODES
} AccOperationMode;

typedef struct
{
	uint16_t address;
	bool startState;
	bool currentState;
	AccOperationMode trigMode;
} AccConfig;

typedef enum
{
	DIRECTION_LEARNED = 0,
	DIRECTION_RIGHT_IS_FORWARD = 1,
	DIRECTION_LEFT_IS_FORWARD = 2
} SensorToDirection;

// TRAVEL_BIDIRECTIONAL - normal bi-directional movement
// TRAVEL_FORWARD_NORMAL_INTERMEDIATES - Always go forward, use normal intermediates for forward movement
// TRAVEL_FORWARD_FLIP_INTERMEDIATES - Always go forward, but use reverse intermediates when going "reverse"


typedef enum
{
	TRAVEL_BIDIRECTIONAL = 0,
	TRAVEL_FORWARD_NORMAL_INTERMEDIATES = 1,
	TRAVEL_FORWARD_FLIP_INTERMEDIATES = 2
} TravelDirectionMode;

typedef enum
{
	DIRECTION_STOP    = 0,
	DIRECTION_FORWARD = 1,
	DIRECTION_REVERSE = 2
} Direction;

typedef struct
{
	// Loaded from EEP
	bool dcMode;
	bool intStopsEnable;
	uint8_t activeLocoConfig;
	bool startPaused;
	bool stopRetriggersLearnMode;
	SensorToDirection definedDirection;
	bool startFromSavedState;
	TravelDirectionMode travelMode;
	// Runtime elements
	bool stopped;
	int16_t speed;
	int16_t requestedSpeed;
	uint8_t direction;
	uint16_t endpointDelay;
	uint16_t midpointDelay;
	uint8_t backlightTimeout;
} OpsConfiguration;

#define EEP_OPSCONFIG_FLAGS1          0x0000
#define EEP_OPSCONFIG_ACTIVE_LOCO     0x0001
#define EEP_OPSCONFIG_ENDPOINT_DELAY  0x0002 // unit16 v1.3+
#define EEP_OPSCONFIG_MIDPOINT_DELAY  0x0004 // uint16 v1.3+
#define EEP_OPSCONFIG_BACKLIGHT_DELAY 0x0005 
#define EEP_OPSCONFIG_DEF_DIRECTION   0x0006
#define EEP_OPSCONFIG_TRAVEL_MODE     0x0007
#define EEP_OPSCONFIG_REINITIALIZE    0x0008


#define OPSCONFIG_FLAGS1_DC_MODE      0x01
#define OPSCONFIG_FLAGS1_INIT_STOP    0x02
#define OPSCONFIG_FLAGS1_INT_STOPS_EN 0x04
#define OPSCONFIG_FLAGS1_STOP_RELEARN 0x08
#define OPSCONFIG_FLAGS1_STATE_SAVE   0x10

void loadOpsConfiguration(OpsConfiguration* opsConfig);
void saveOpsConfiguration(OpsConfiguration* opsConfig);

void doFastReinitialize();
bool isFastReinitialize();

void firstTimeInitOpsConfiguration();


// Locomotive configurations are stored at address 0x0040
// Each has 32 bytes reserved for it

// Addr   - Purpose
// +0x0000 - Locomotive address number [15:8]
// +0x0001 - Locomotive address number [7:0]
// +0x0002 - Flags #1
//           Bit 0 - DCC Short Address
//           (other bits undefined)
// +0x0003 - Locomotive max speed (0-100)
// +0x0004 - Locomotive ramp time (1-255 decisecs)
// +0x0005 - Always on functions [31:24]
// +0x0006 - Always on functions [23:16]
// +0x0007 - Always on functions [15:8]
// +0x0008 - Always on functions [7:0]
// +0x0009 - Forward on functions [31:24]
// +0x000A - Forward on functions [23:16]
// +0x000B - Forward on functions [15:8]
// +0x000C - Forward on functions [7:0]
// +0x000E - Reverse on functions [31:24]
// +0x000F - Reverse on functions [23:16]
// +0x0010 - Reverse on functions [15:8]
// +0x0011 - Reverse on functions [7:0]

#define EEP_LOCOCONFIG_MEM_START_ADDR   0x0040

#define EEP_LOCOCONFIG_ADDR_H_OFFSET    0x0000
#define EEP_LOCOCONFIG_ADDR_L_OFFSET    0x0001
#define EEP_LOCOCONFIG_FLAGS_OFFSET     0x0002
#define EEP_LOCOCONFIG_MAXSPEED_OFFSET  0x0003
#define EEP_LOCOCONFIG_RAMPRATE_OFFSET  0x0004
#define EEP_LOCOCONFIG_ALLFUNC_OFFSET   0x0005
#define EEP_LOCOCONFIG_FWDFUNC_OFFSET   0x0009
#define EEP_LOCOCONFIG_REVFUNC_OFFSET   0x000D
#define EEP_LOCOCONFIG_ACCFUNC_OFFSET   0x0011
#define EEP_LOCOCONFIG_DECFUNC_OFFSET   0x0015


#define EEP_LOCOCONFIG_BLOCK_SIZE   32

#define LOCOCONFIG_FLAGS1_DCC_SHORTADDR  0x01


uint32_t loadLocoConfigFunctions(uint16_t offset, uint16_t functionStart);
void loadLocoConfiguration(uint8_t whichConfig, LocoConfig* locoConfig);
bool saveLocoConfiguration(uint8_t whichConfig, LocoConfig* locoConfig);
void firstTimeInitLocoConfiguration();
void firstTimeInitConfig();

#define EEP_ACCCONFIG_MEM_START_ADDR    (EEP_LOCOCONFIG_MEM_START_ADDR + EEP_LOCOCONFIG_BLOCK_SIZE * NUM_LOCO_OPTIONS)

#define EEP_ACCCONFIG_ADDR_H_OFFSET     0x0000
#define EEP_ACCCONFIG_ADDR_L_OFFSET     0x0001
#define EEP_ACCCONFIG_MODE_OFFSET       0x0002
#define EEP_ACCCONFIG_FLAGS1_OFFSET     0x0003

#define ACCCONFIG_FLAGS1_START_SET      0x01

#define EEP_ACCCONFIG_BLOCK_SIZE   8

void firstTimeInitAccConfig();
void loadAccConfiguration(uint8_t whichConfig, AccConfig* accConfig);
void saveAccConfiguration(uint8_t whichConfig, AccConfig* accConfig);

const char* getAccModeText(AccOperationMode mode);

#define EEP_WEAR_LEVEL_STATE_START_ADDR 0x800

#endif
