IowaScaledEngineering/ckt-pingpong/(commit log)

2020-06-28 Initial version of the dedicated ping-pong controller
    [ckt-pingpong.pcb, ckt-pingpong.sch]
2020-06-29 PCB layout and some minor adjustments to the schematic
    [ckt-pingpong.pcb, ckt-pingpong.sch]
2020-06-29 Change current shunt amp to 20x gain instead of 50x
    [ckt-pingpong.sch]
2020-06-29 Fix everything MDP found except a LPF on the current sense line
    [ckt-pingpong.pcb, ckt-pingpong.sch]
2020-06-29 Michael's recommendations
    [ckt-pingpong.pcb, ckt-pingpong.sch]
2020-07-02 PG v1.0
    [ckt-pingpong.bottom.gbr, ckt-pingpong.bottommask.gbr, ckt-pingpong.bottompaste.gbr, ckt-pingpong.bottomsilk.gbr, ckt-pingpong.fab.gbr, ckt-pingpong.outline.gbr, ckt-pingpong.top.gbr, ckt-pingpong.topmask.gbr]
2020-07-28 Fix ADC values
2020-07-28 Adjust initial state so that buttons start not pressed
2020-07-29 Break DC and DCC drivers into their own files
2020-07-29 Add factory reset menu option
    [ckt-pingpong.c]
2020-07-30 Bug fixes to get basic configuration working
    [ckt-pingpong.c, dcc.c, dcc.h, userconfig.c, userconfig.h]
2020-07-30 Fix a few bugs, add pause on start
    [ckt-pingpong.c, dcc.c, userconfig.c, userconfig.h]
2020-08-05 Initial version of track switch
    [ckt-pingpong-sw.pcb]
2020-08-05 Flipped side-to-side. Increased trace size to 70mil.
    [ckt-pingpong-sw.pcb]
2020-08-05 Improved power routing again
    [ckt-pingpong-sw.pcb]
2020-08-05 Changed to pluggable connectors
    [ckt-pingpong-sw.pcb]
2020-08-05 Fixed terminal block orientation
    [ckt-pingpong-sw.pcb]
2020-08-05 Added A/B text and changed input terminal block text
    [ckt-pingpong-sw.pcb]
2020-08-09 Clean up code, add intermediate stop sensor support
2020-08-09 Forgot to put state text for forward/reverse intermediate accelerate states
    [ckt-pingpong.c]
2020-08-16 Add toggle on either sensor mode
2020-08-18 Remove R4 & R8 Add pin 1 marker to U1 and U5 Add intermediate L/R sensor inputs and route them up to unused pins rather than putting them into SDA/SCL as had been proposed
    [ckt-pingpong.pcb, ckt-pingpong.sch]
2020-08-18 Fix where signal lines come off the ESD diodes
    [ckt-pingpong.pcb]
2020-08-18 Update crystal to 12MHz
    [ckt-pingpong.sch]
2020-08-20 Sent to fab 8/19
    [ckt-pingpong-sw.bottom.gbr, ckt-pingpong-sw.bottommask.gbr, ckt-pingpong-sw.bottompaste.gbr, ckt-pingpong-sw.bottomsilk.gbr, ckt-pingpong-sw.fab.gbr, ckt-pingpong-sw.outline.gbr, ckt-pingpong-sw.top.gbr, ckt-pingpong-sw.topmask.gbr]
2020-08-30 Move intermediate sensors to new pins
2020-08-30 Add menu option to relearn or not based on stop button
2020-08-31 Add pingpong manual - rough cut
2020-09-04 Adjust backlight timeout Modify diags screen to show sensor inputs
2020-09-18 Faeplate upate
    [pingpong-faceplate v5.stl, pingpong-faceplate v6.stl]
2020-10-21 Make acc/dec functions actually work, fix issue where if you edit the active locomotive configuration, you previously had to then go back to the main screen and load it. Now it does it automatically
    [ckt-pingpong.c, userconfig.c, userconfig.h]
2020-10-21 Found the issue with F5-F8 and F9-F12 not working - the groups were reversed. Also fixed some comments.
    [dcc.c]
2020-10-23 Fix reverse and forward functions beign backwards
    [ckt-pingpong.c]
2020-10-26 Use FWDDECEL and REVDECEL in F<>R instead of just swapping the speed
    [ckt-pingpong.c]
2020-11-21 Fix incorrect retval from debounce()
    [ckt-pingpong.c]
2020-11-21 Add WDT reset within factor reset - otherwise it was timing out with all the time necessary to reset the locomotive configurations
    [userconfig.c]
2020-12-23 Updated faceplate
    [pingpong-faceplate v6.stl, pingpong-faceplate v7.stl]
2021-01-04 Fix issues: - F/R doesn't change on the screen in manual operations due to screen not being refreshed - Can't get back to short addresses after setting to a long address in loco configuration - Can't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
    [ckt-pingpong.c]
2021-01-04 Make it so when selecting a locomotive number, it won't go into short mode unless the lower three digits would be a compatible short address
    [ckt-pingpong.c]
2021-01-17 v2 with a rotary switch
    [ckt-pingpong-sw.pcb]
2021-01-17 Changed AUX IN to MOTORMAN
    [ckt-pingpong-sw.pcb]
2021-01-19 Rotated switch for proper knob alignment
    [ckt-pingpong-sw.pcb]
2021-02-06 Add sw2.0
    [ckt-pingpong-sw.bottom.gbr, ckt-pingpong-sw.bottommask.gbr, ckt-pingpong-sw.bottompaste.gbr, ckt-pingpong-sw.bottomsilk.gbr, ckt-pingpong-sw.fab.gbr, ckt-pingpong-sw.outline.gbr, ckt-pingpong-sw.top.gbr, ckt-pingpong-sw.topmask.gbr]
2021-02-20 New switch faceplate files
    [knob v7.stl, knob-pointer v7.stl, pingpong-faceplate v16.3mf, pingpong-faceplate v7.stl, pingpong-faceplate-abc v16.stl, pingpong-faceplate-plate v16.stl]
2021-06-14 Rotated U6 90deg Fixed heatsink footprint to better match connection points
    [ckt-pingpong.pcb, ckt-pingpong.sch]
2021-06-14 Bumped rev to 1.2
    [ckt-pingpong.pcb]
2021-06-16 Sent to fab 6/15/2021
    [ckt-pingpong.bottom.gbr, ckt-pingpong.bottommask.gbr, ckt-pingpong.bottompaste.gbr, ckt-pingpong.bottomsilk.gbr, ckt-pingpong.fab.gbr, ckt-pingpong.outline.gbr, ckt-pingpong.top.gbr, ckt-pingpong.topmask.gbr]
2021-12-24 Updated faceplate files
    [knob v7.3mf, pingpong-faceplate v16.3mf, pingpong-faceplate v18.3mf, pingpong-faceplate-abc v16.stl, pingpong-faceplate-abc v18.stl, pingpong-faceplate-plate v16.stl, pingpong-faceplate-plate v18.stl]
2022-04-18 Fix endstop functions to not retrigger, update to version 1.2
    [ckt-pingpong.c]
2022-04-23 Fix issue with function fix only in certain states
    [ckt-pingpong.c]
2022-10-30 Get rid of RPacks and update input protection circuits
    [ckt-pingpong.pcb, ckt-pingpong.sch]
2022-11-03 Updated date to 2022
    [ckt-pingpong.pcb]
2023-02-03 PG 1.3
    [ckt-pingpong.bottom.gbr, ckt-pingpong.bottommask.gbr, ckt-pingpong.bottompaste.gbr, ckt-pingpong.bottomsilk.gbr, ckt-pingpong.fab.gbr, ckt-pingpong.outline.gbr, ckt-pingpong.top.gbr, ckt-pingpong.topmask.gbr]
2025-11-30 Put in code to save acc function states over a power cycle
2026-04-15 Various bugfixes for v2 firmware
    [ckt-pingpong.c, screenStates.h, userconfig.c]
2026-06-28 Fix it so the cancel button actually works in the travel mode menu
    [ckt-pingpong.c]
2026-08-26 Add code for the arduino test interface for the hardware-in-the-loop regression tester
2026-08-28 Initial cut of test harness code
2026-09-05 Fix issue where "relearn on stop" wasn't getting saved
    [userconfig.c]
2026-09-05 Fix issue where stopped was always considered forward and would activate forward functions, even if it was a pause while reversing
    [ckt-pingpong.c, userconfig.h]
2026-09-06 Make manual completely manual Make fast reinitialization work Skip splash screen on restore state except in fast reinit
    [ckt-pingpong.c, userconfig.c, userconfig.h]
